machadevrepos/Vantare_Vantage_Suit/Docs/Files from Client/Second level Enclosure Design 03rd April 2026.pptx

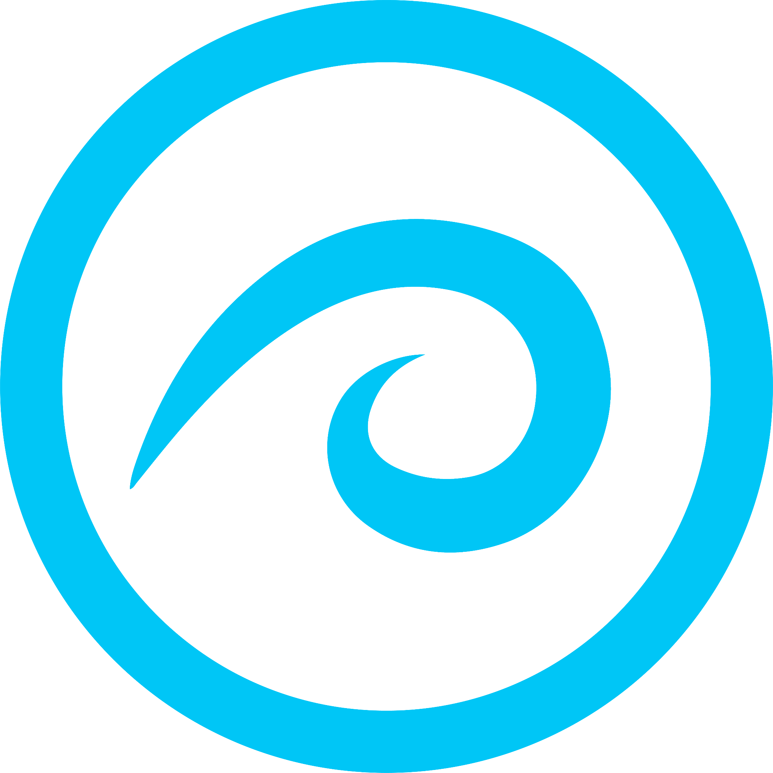
[picture p1: figure]

Exoskeleton
Master and Node Assembly Enclosure Design

Prototype Lab, Groundswell Startups

Date: 03-04-2026, Version: 1.1

## Slide 2

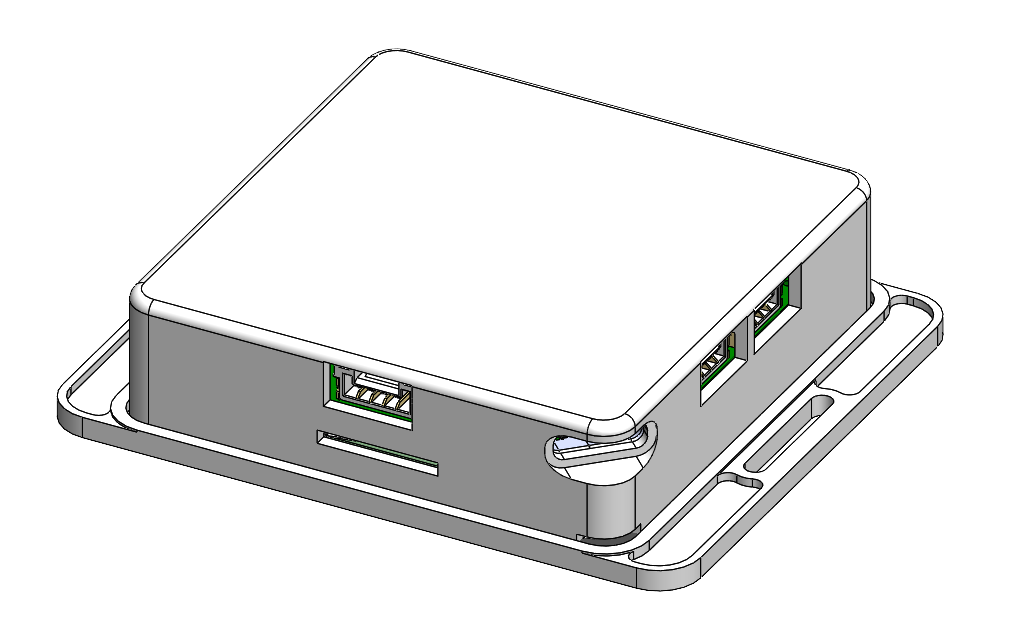
[picture p2: figure]

Master PCB Assembly with encloser

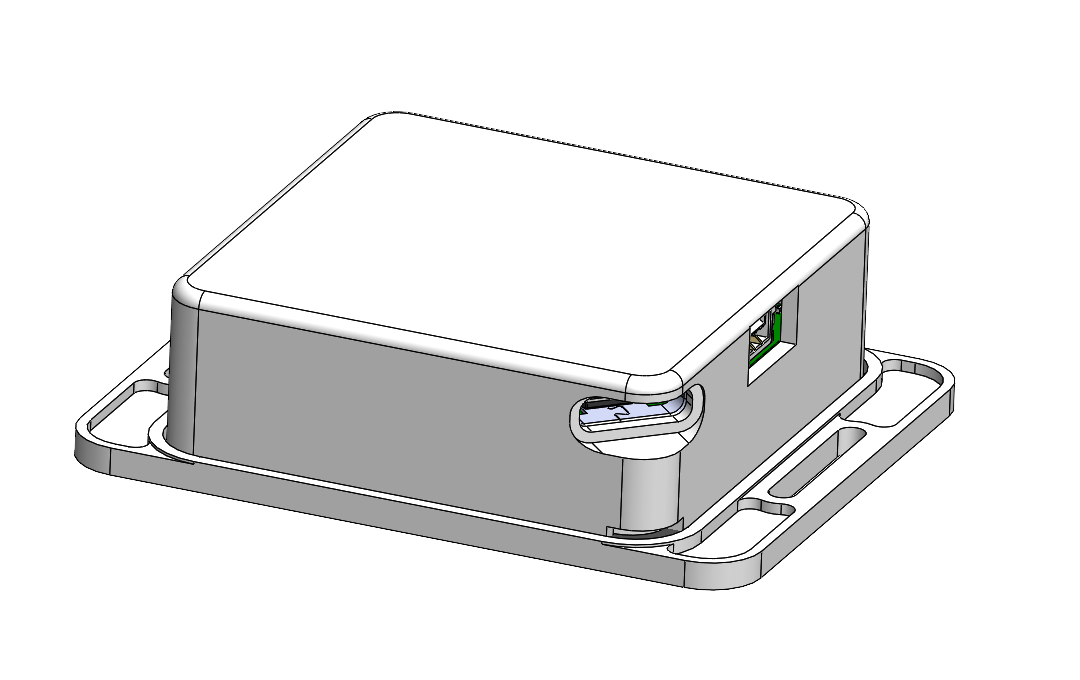
[picture p3: figure]

Node PCB Assembly with encloser

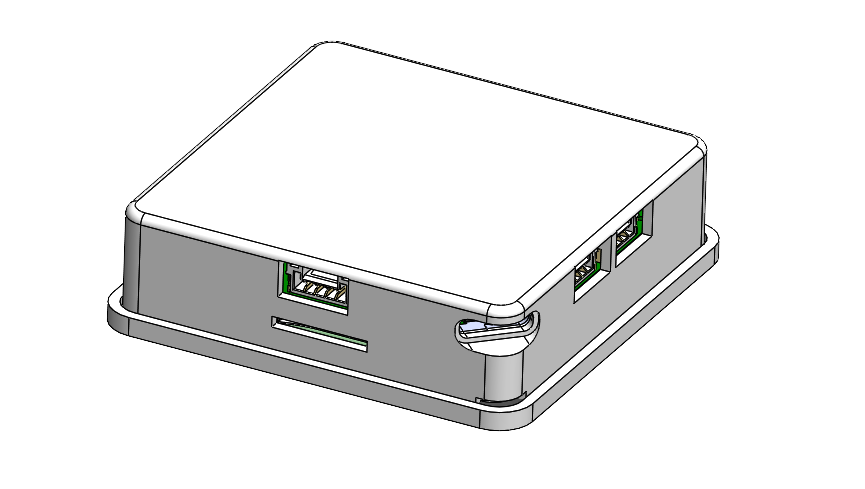
[picture p4: figure]
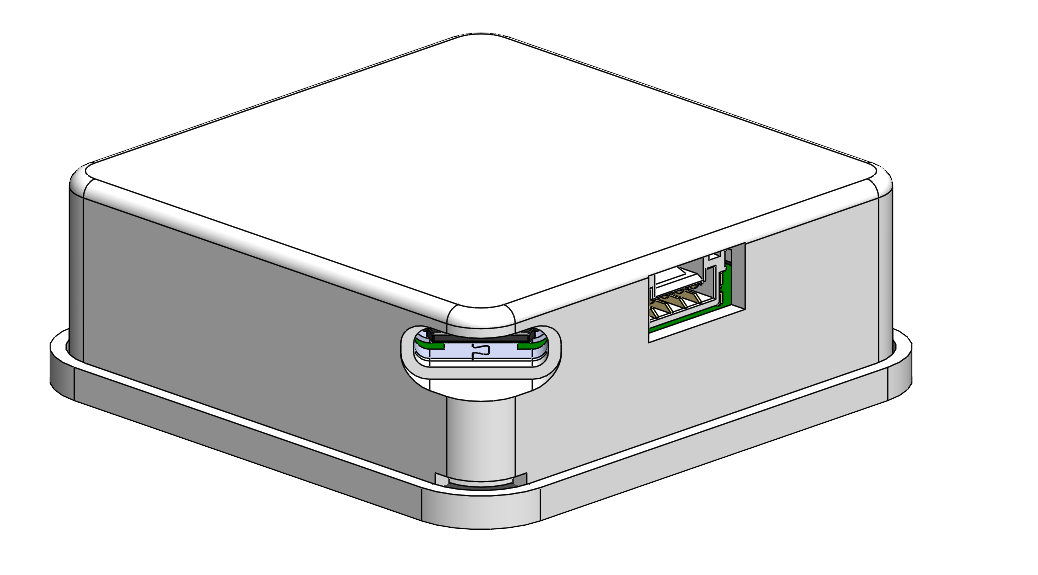
[picture p5: figure]

## Slide 3

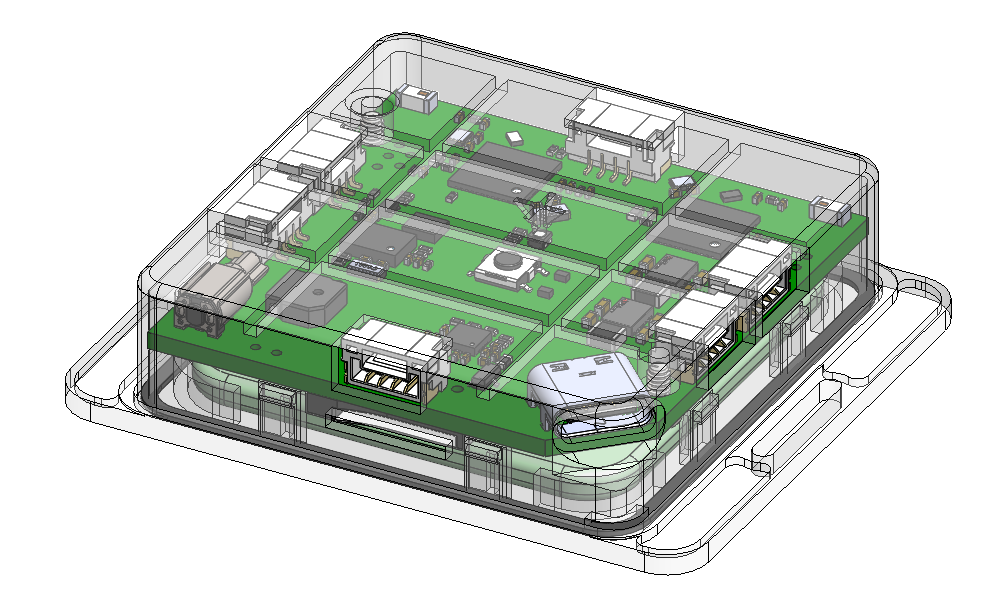
[picture p6: figure]
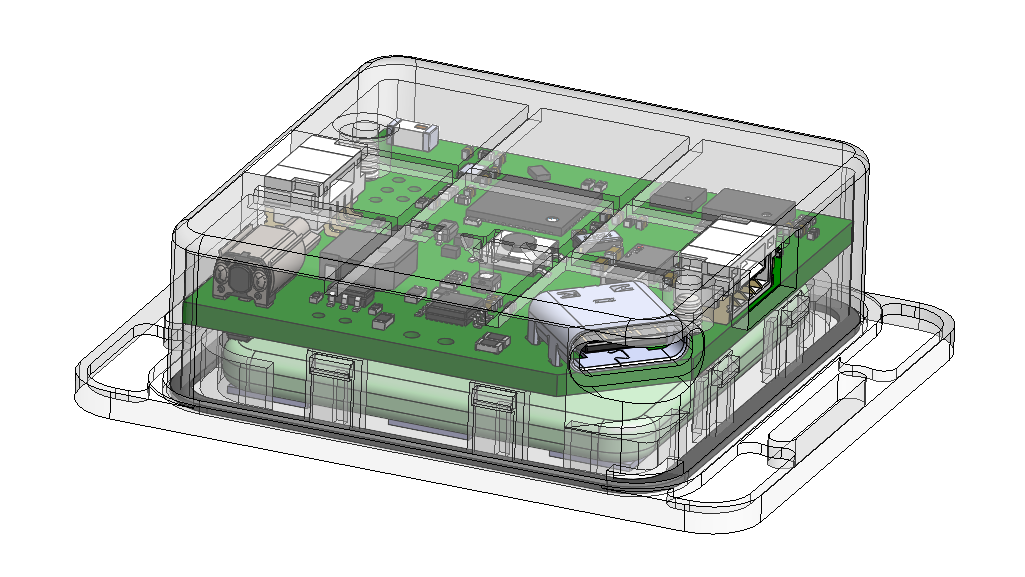
[picture p7: figure]

Node PCB Assembly with encloser

Master PCB Assembly with encloser

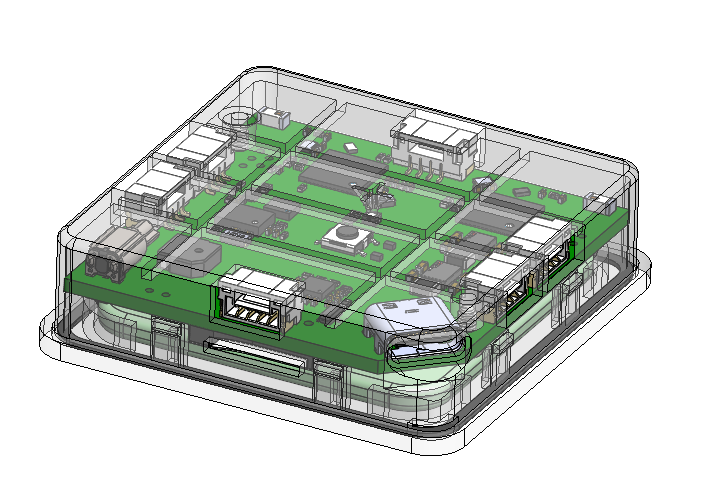
[picture p8: figure]
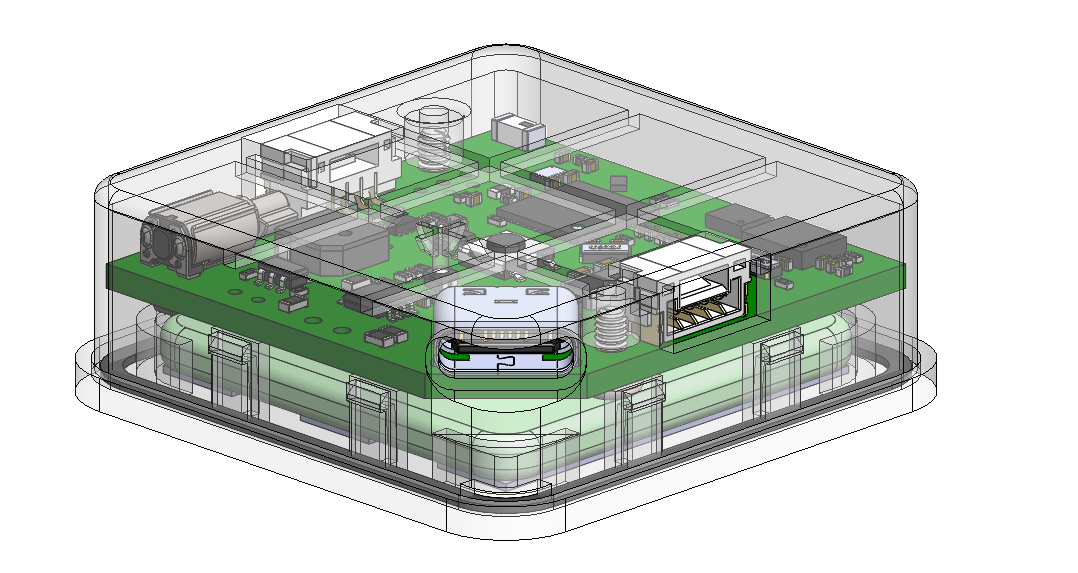
[picture p9: figure]

## Slide 4

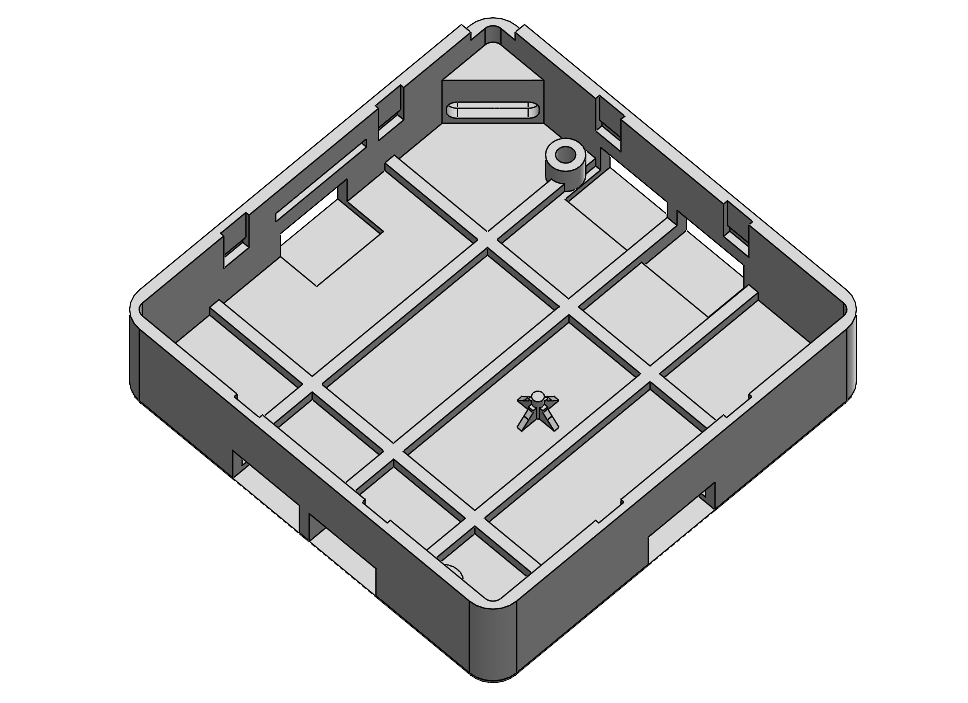
[picture p10: figure]
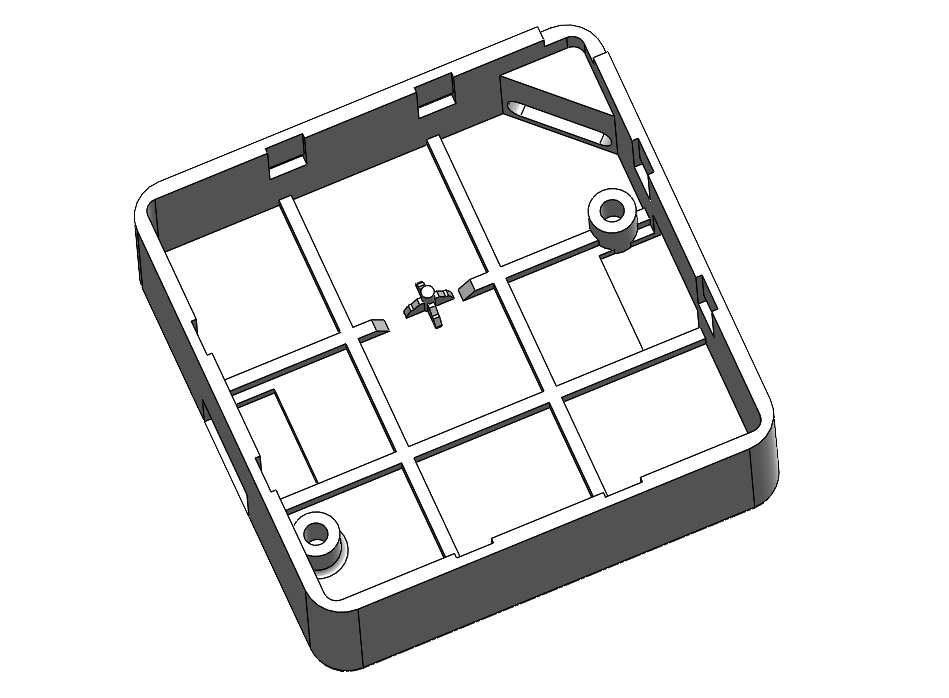
[picture p11: figure]

Node PCB Assembly Top Part

Master PCB Assembly Top Part

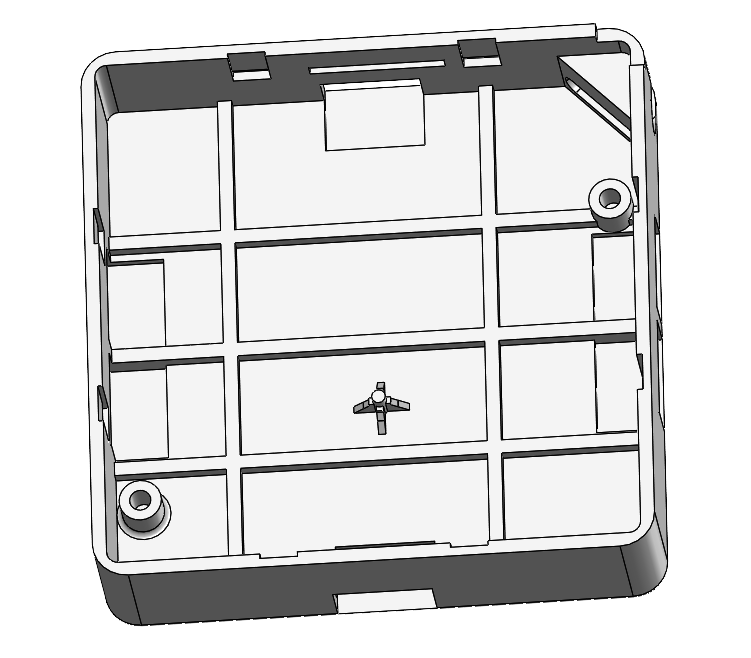
[picture p12: figure]

## Slide 5

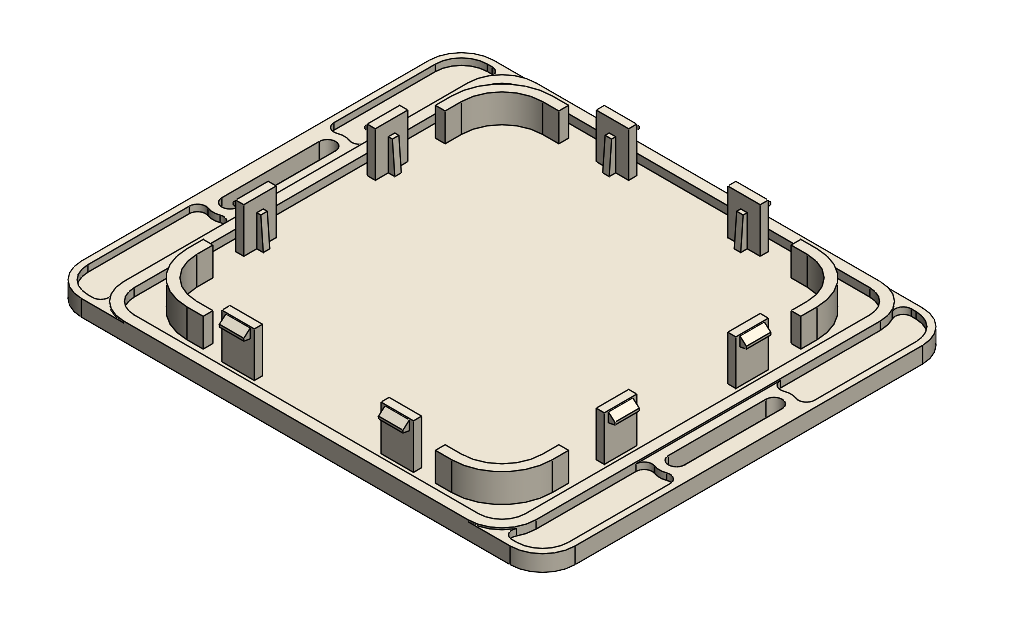
[picture p13: figure]

Node PCB Assembly Bottom Part

Master PCB Assembly Bottom Part

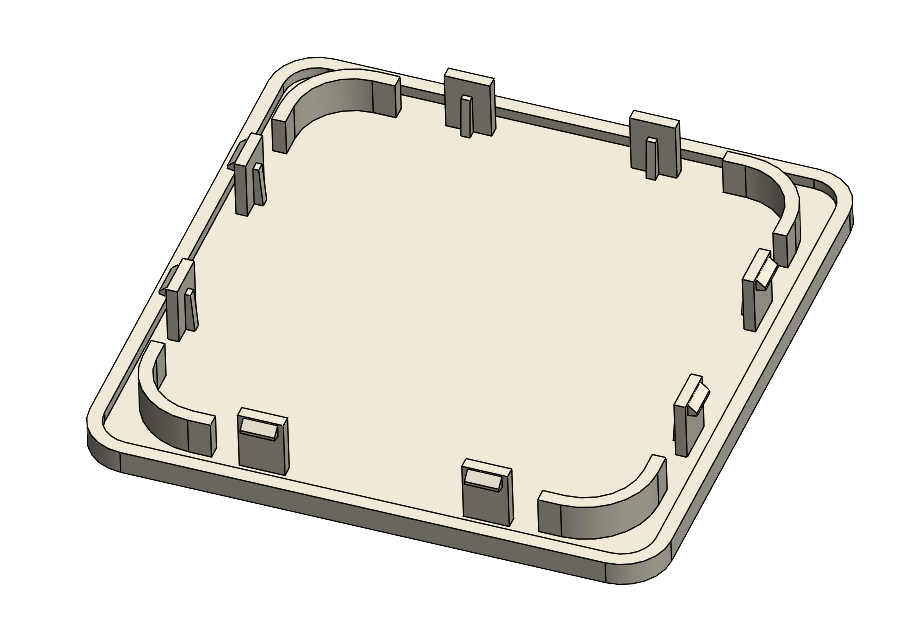
[picture p14: figure]

## Slide 6

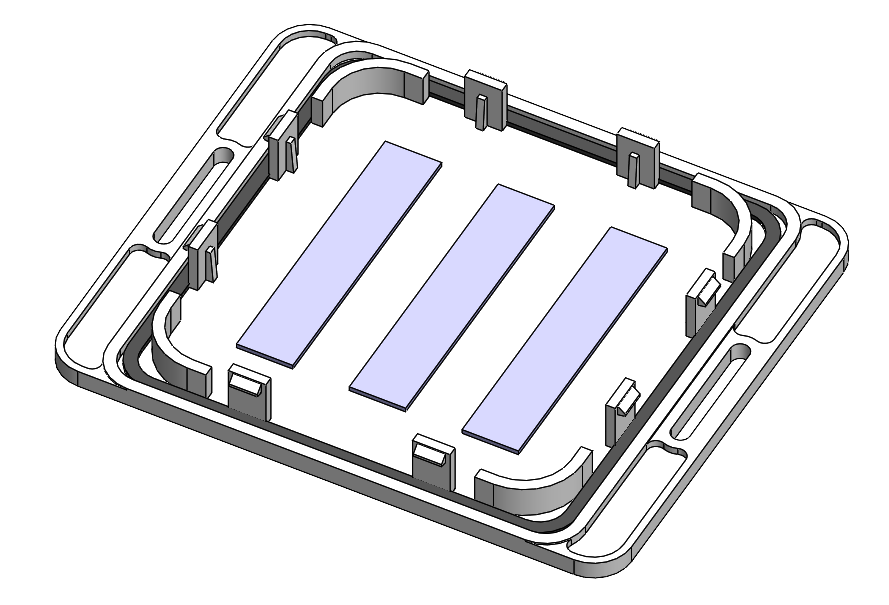
[picture p15: figure]
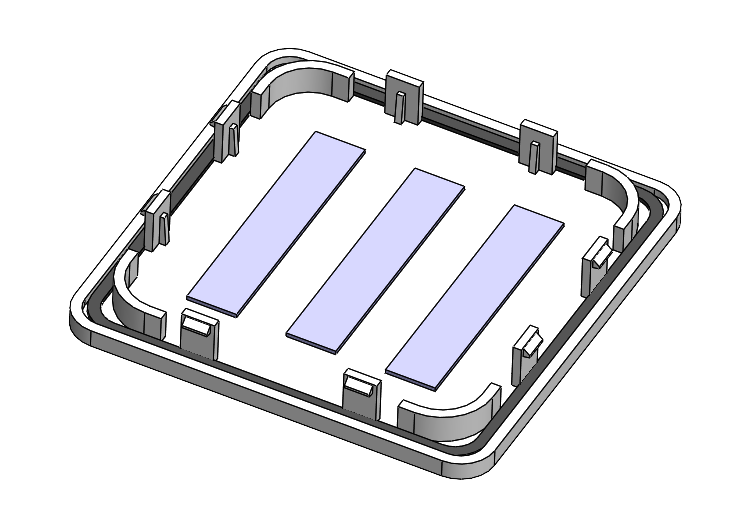
[picture p16: figure]

Master Bottom Part with DST for Battery

Node Bottom Part with DST for Battery

## Slide 7

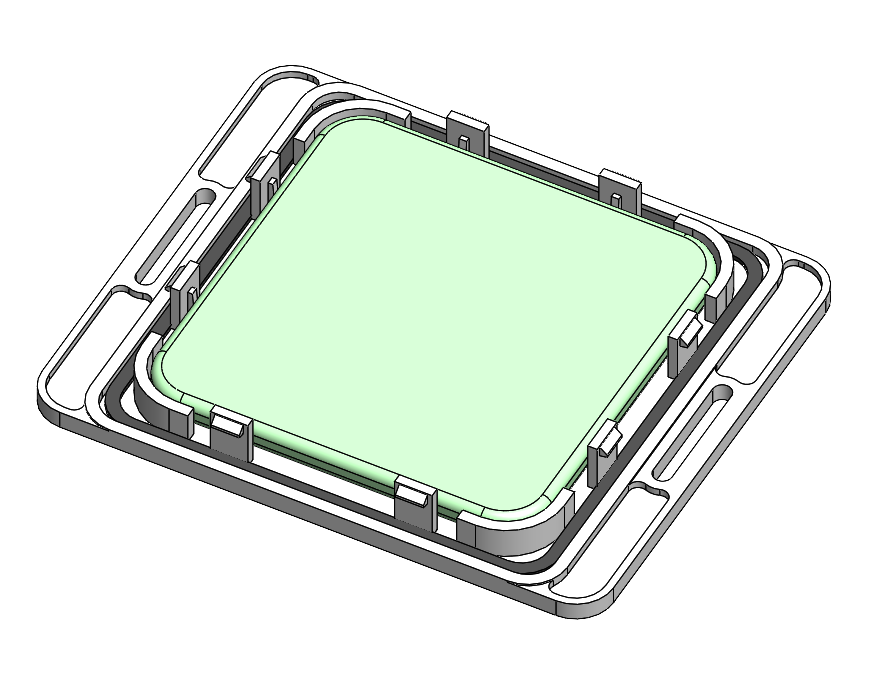
[picture p17: figure]

Master Bottom Part with DST & Battery placement

Node Bottom Part with DST & Battery placement

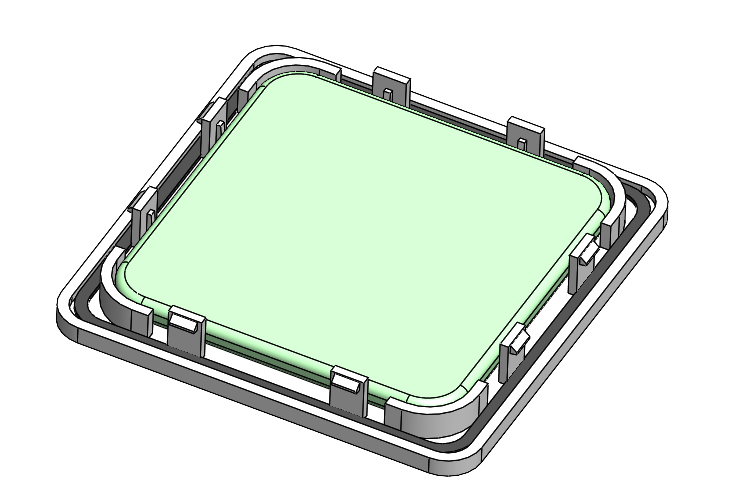
[picture p18: figure]

## Slide 8

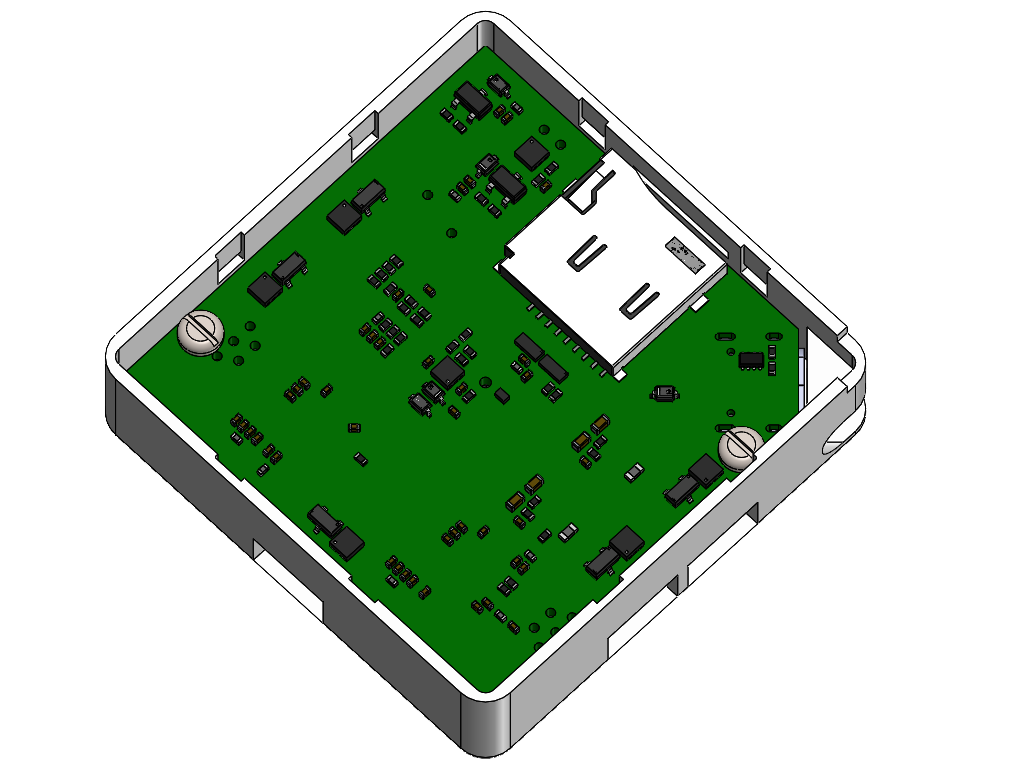
[picture p19: figure]

Master Top Part with PCB placement with self tapping screw

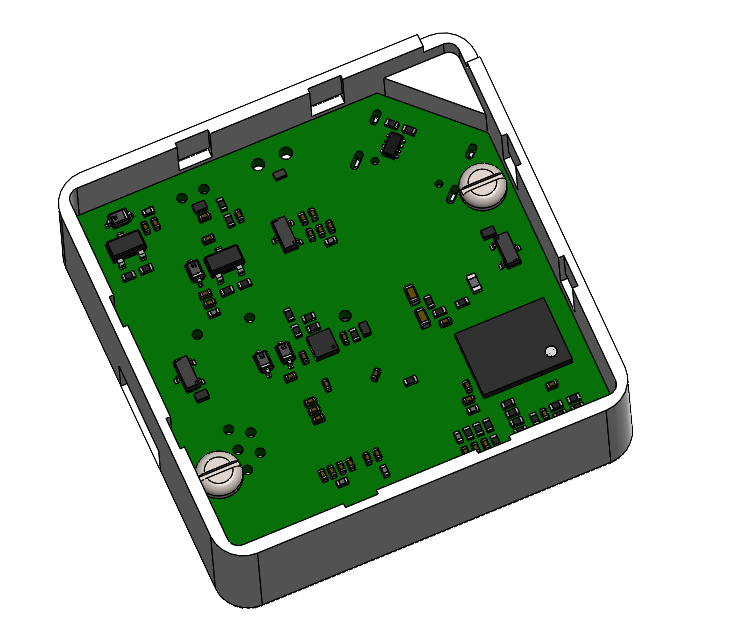
[picture p20: figure]

Node Top Part with PCB placement with self tapping screw

## Slide 9

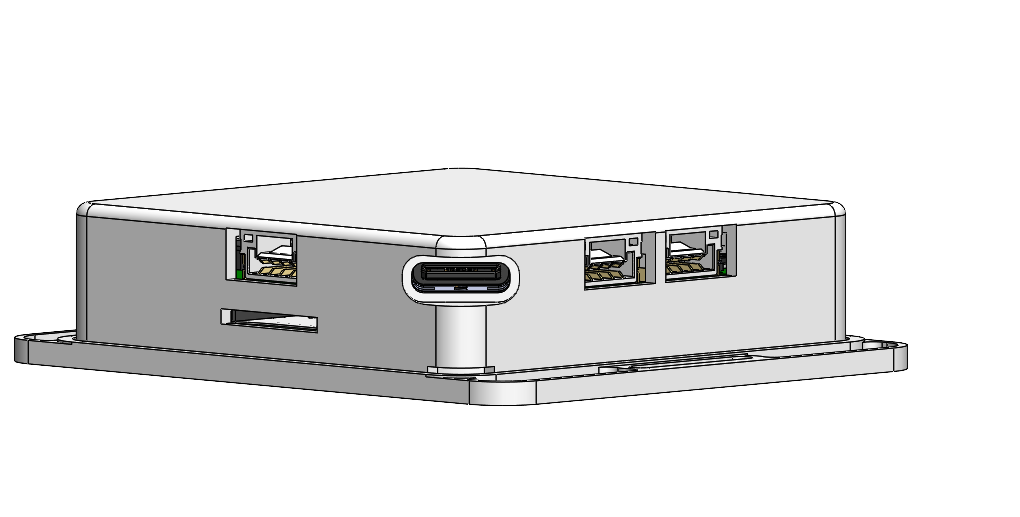
[picture p21: figure]
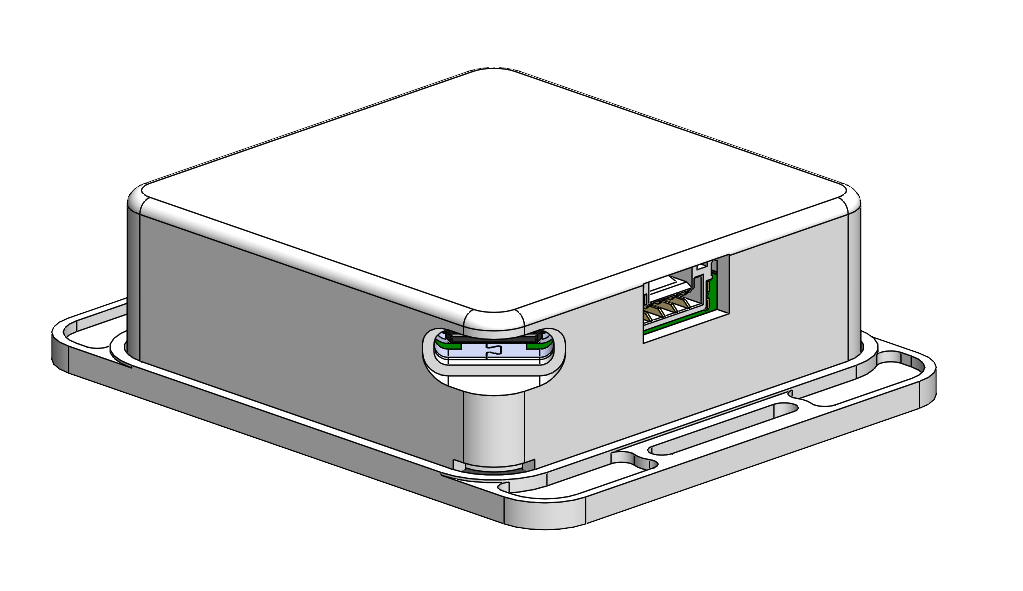
[picture p22: figure]

Master Top Part with cutout for USB-C

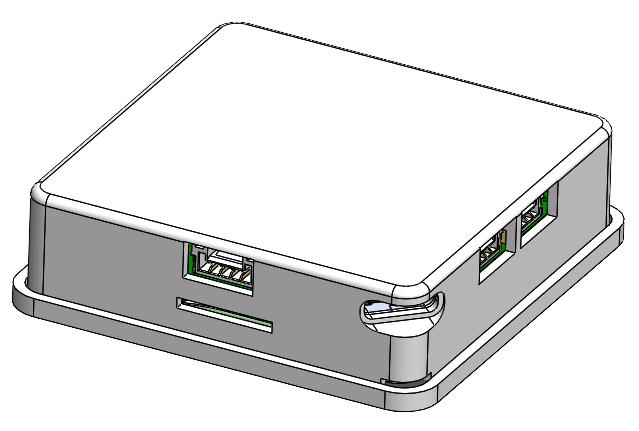
[picture p23: figure]

Node Top Part with cutout for USB-C

## Slide 10

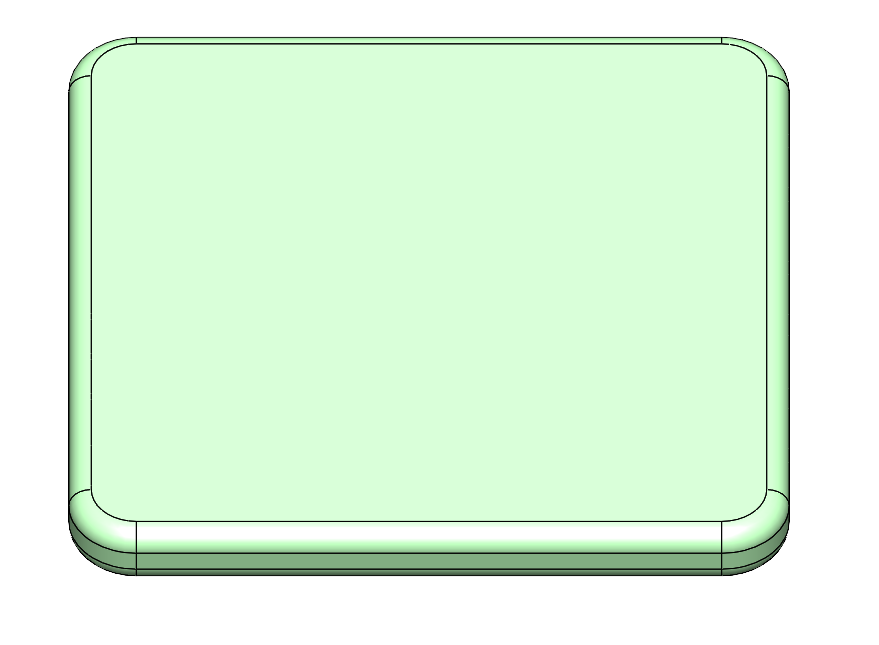
[picture p24: figure]

Length – 42mm
Width – 42mm
Thickness – 3mm

Length – 32mm
Width – 32mm
Thickness – 3mm

Node Assembly Battery Dimensions

Master Assembly Battery Dimensions

## Slide 11

Exoskeleton
Master and Node Assembly Enclosure Design

prototype@swellstartups.com

Thank you!
