machadevrepos/Vantare_Vantage_Suit/Docs/Vantare VantageSuit™️ Pitch Deck_PDF Version.pdf

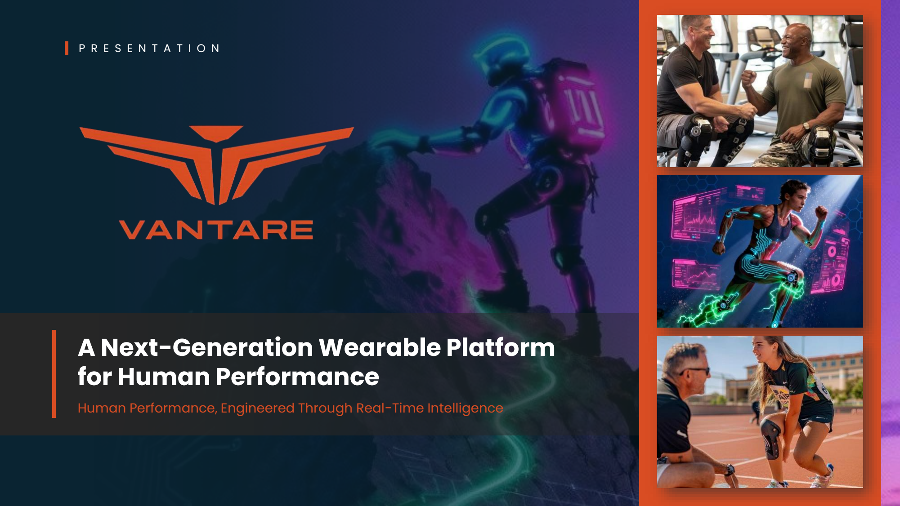
[picture p53: page 1]

1

# A Next-Generation Wearable Platform for Human Performance

Human Performance, Engineered Through Real-Time Intelligence

P R E S E N T A T I O N

## Vantare VantageSuit is a performance technology platform

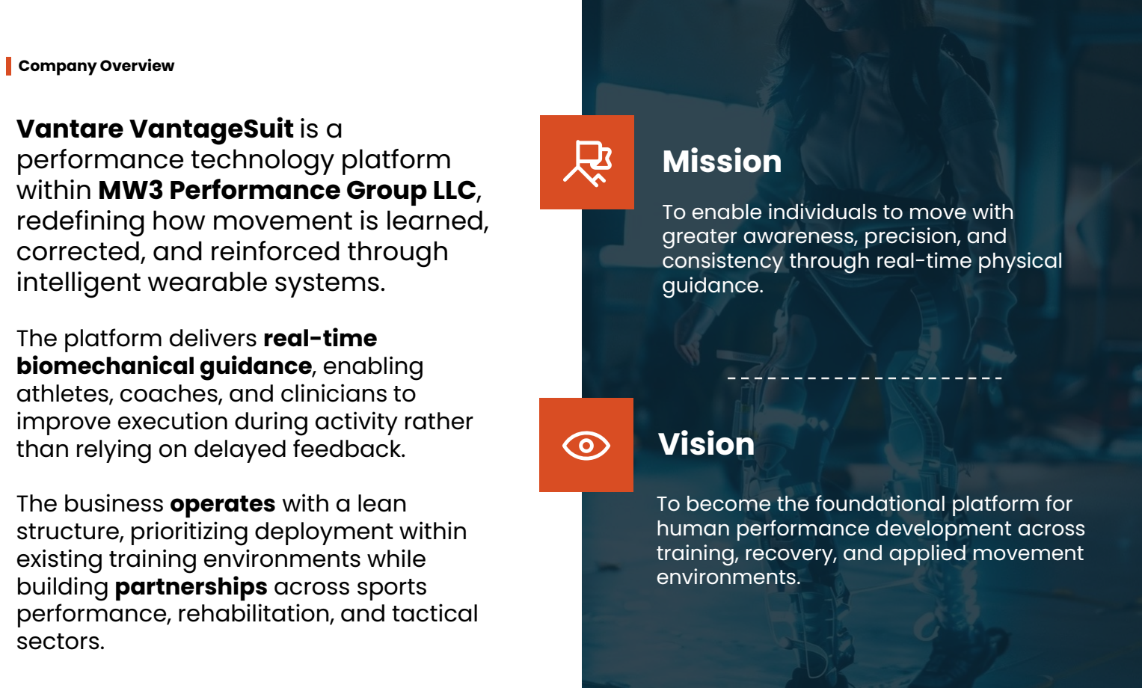
[picture p54: page 2]

2

Company Overview

within MW3 Performance Group LLC, redefining how movement is learned,

## corrected, and reinforced through

intelligent wearable systems.

## The platform delivers real-time biomechanical guidance, enabling athletes, coaches, and clinicians to improve execution during activity rather

than relying on delayed feedback.

## The business operates with a lean structure, prioritizing deployment within existing training environments while building partnerships across sports performance, rehabilitation, and tactical

sectors.

# Mission

## To enable individuals to move with greater awareness, precision, and consistency through real-time physical

guidance.

# Vision

## To become the foundational platform for human performance development across training, recovery, and applied movement

environments.

3

The Founder

# Powering Vantare’s Innovation

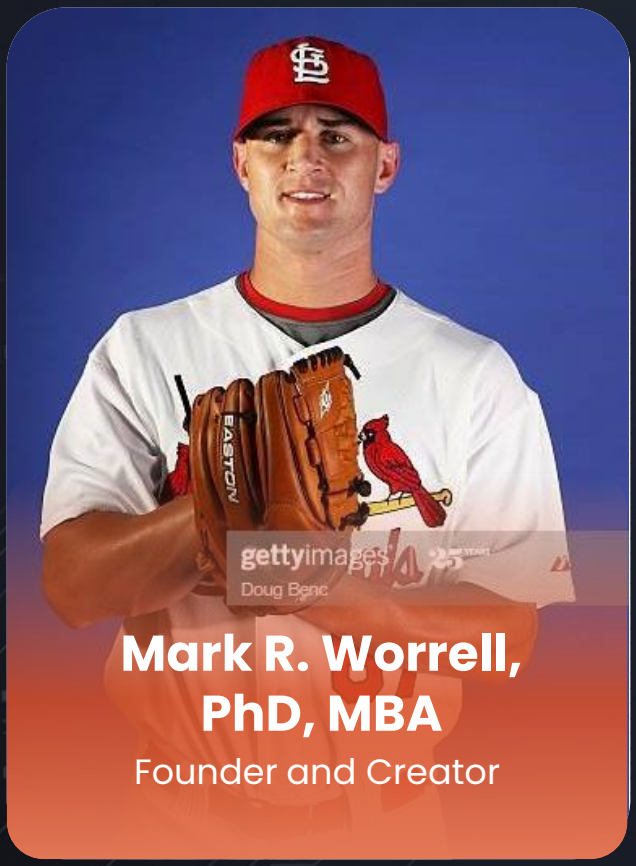
[picture p55: figure]
Mark R. Worrell, PhD, MBA Founder and Creator

### - Elite Athletic Background: Former Major League Baseball player with firsthand experience in high-performance environments

### - Academic Expertise: Advanced academic training in biomechanics, performance science, and human movement development

### - Problem Insight: Deep understanding of the gap between coaching instruction and physical execution

### - Innovation Leadership: Creator of a system that translates coaching intent into real-time physical guidance

- Industry Perspective: Experience across sports, training systems,

### and performance methodologies

### - Vision Alignment: Focused on building scalable solutions for improving movement across multiple sectors

# The Translation Gap: Coaching does not equal physical execution

There is currently no system that translates coaching instruction into real-time physical correction.

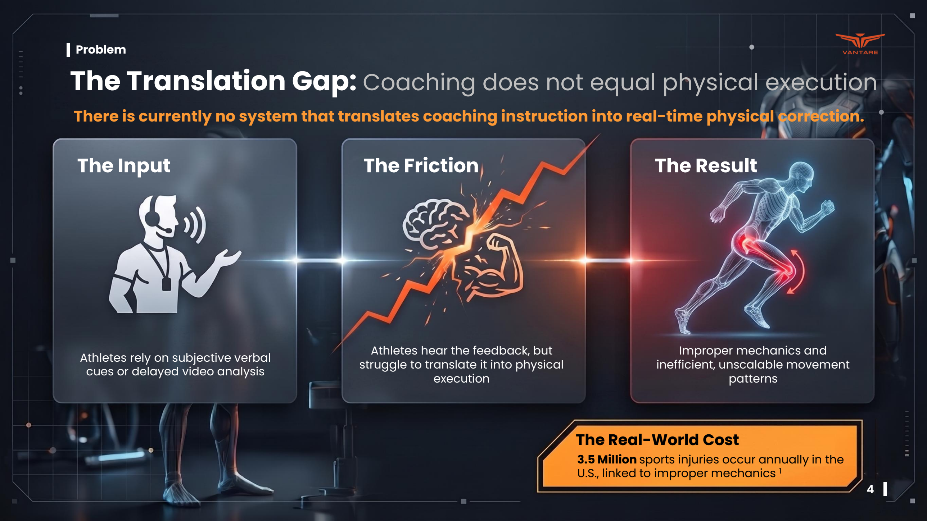
[picture p56: page 4]

4

Problem

## The Input

Athletes rely on subjective verbal cues or delayed video analysis

## The Friction

Athletes hear the feedback, but struggle to translate it into physical execution

## The Result

Improper mechanics and
inefficient, unscalable movement patterns

### 3.5 Million sports injuries occur annually in the

U.S., linked to improper mechanics ¹

## The Real-World Cost

# Introducing Vantare VantageSuit : Guided Physical Learning

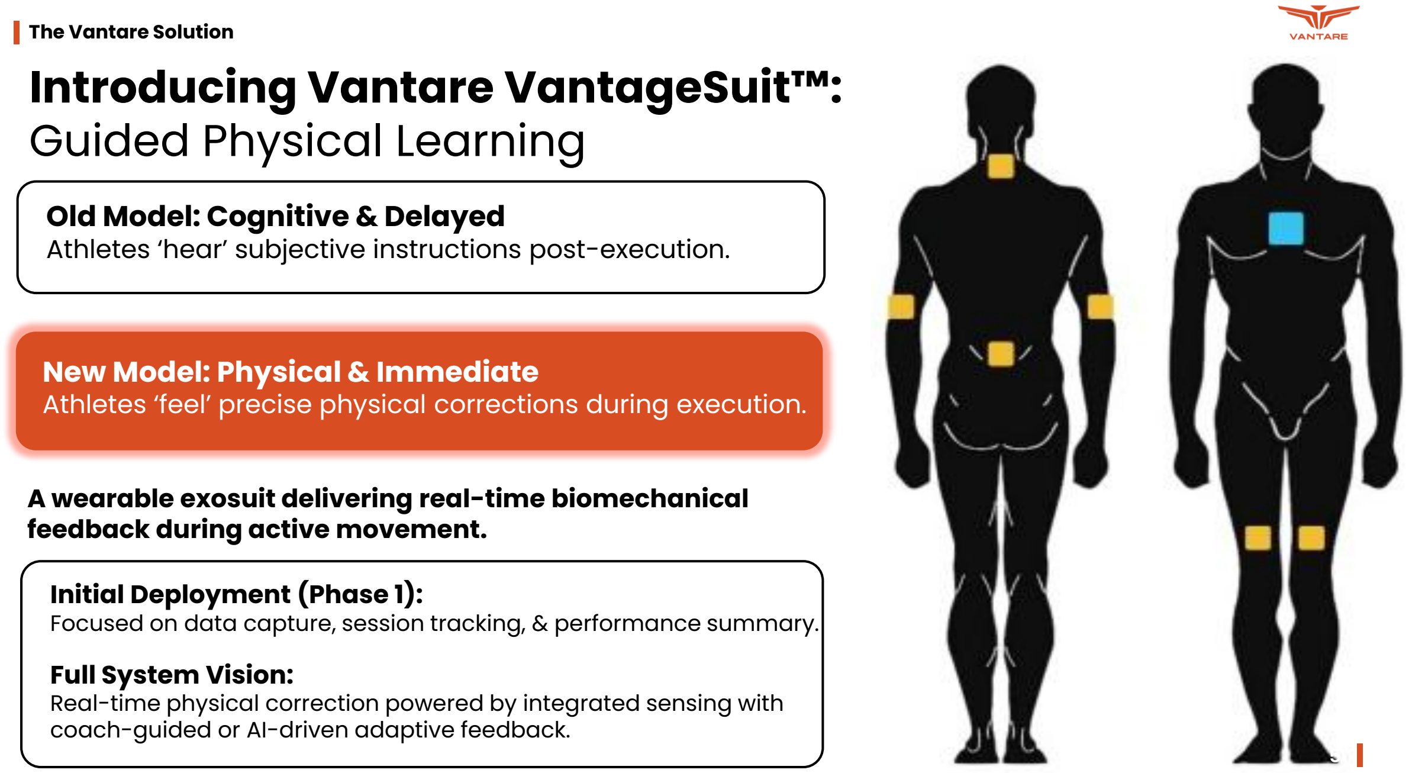
[picture p57: page 5]

5

The Vantare Solution

## Old Model: Cognitive & Delayed

Athletes ‘hear’ subjective instructions post-execution.

## New Model: Physical & Immediate

Athletes ‘feel’ precise physical corrections during execution.

## A wearable exosuit delivering real-time biomechanical

feedback during active movement.

5

## Initial Deployment (Phase 1):

Focused on data capture, session tracking, & performance summary.

## Full System Vision:

Real-time physical correction powered by integrated sensing with coach-guided or AI-driven adaptive feedback.

# A Comprehensive Human Performance System

## An integrated system combining wearable hardware, software platforms, and

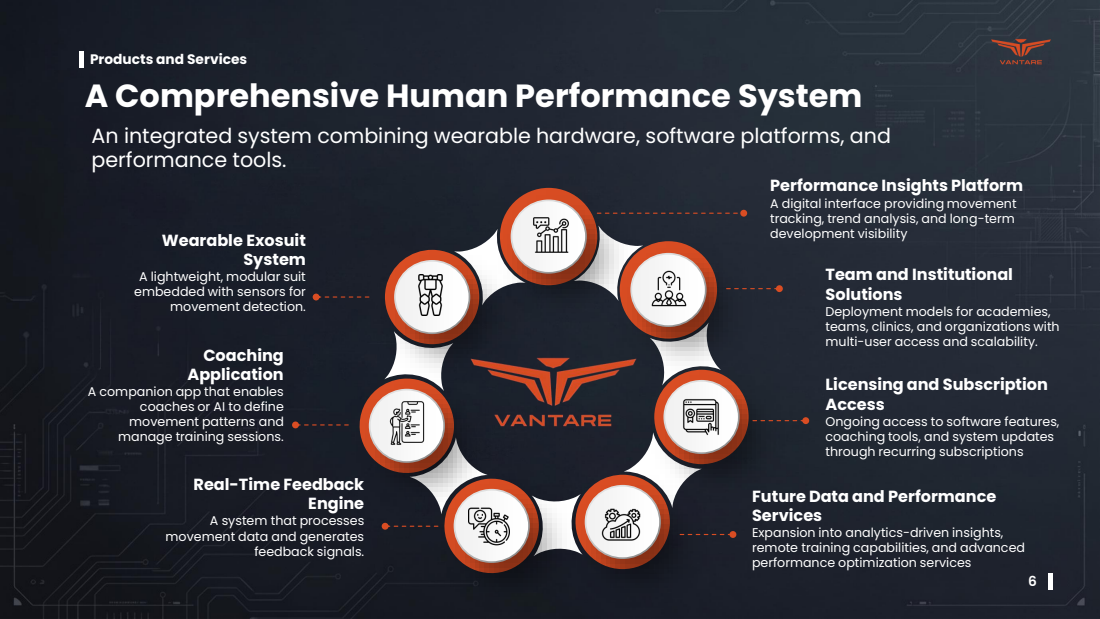
[picture p58: page 6]
performance tools.; Coaching Application; Wearable Exosuit System; Engine; feedback signals.

Products and Services

Performance Insights Platform
A digital interface providing movement
tracking, trend analysis, and long-term
development visibility
Team and Institutional
Solutions
Deployment models for academies,
teams, clinics, and organizations with
multi-user access and scalability.
Licensing and Subscription
Access
Ongoing access to software features,
coaching tools, and system updates
through recurring subscriptions

A lightweight, modular suit
embedded with sensors for
movement detection.

A companion app that enables
coaches or AI to define
movement patterns and
manage training sessions.

Real-Time Feedback

Future Data and Performance
Services
Expansion into analytics-driven insights,
remote training capabilities, and advanced
performance optimization services

A system that processes
movement data and generates

Our Technology

# Real-Time Biomechanical Intelligence System

## - Integrated Motion System: Multi-point sensors capture movement and positional changes continuously

## - Adaptive Guidance Engine: Processes motion data and generates response signals

## - Modular Exosuit Architecture: Flexible design adapts across body types and training contexts

## - Dynamic Response Framework: Adjusts system response based on movement patterns and activity conditions

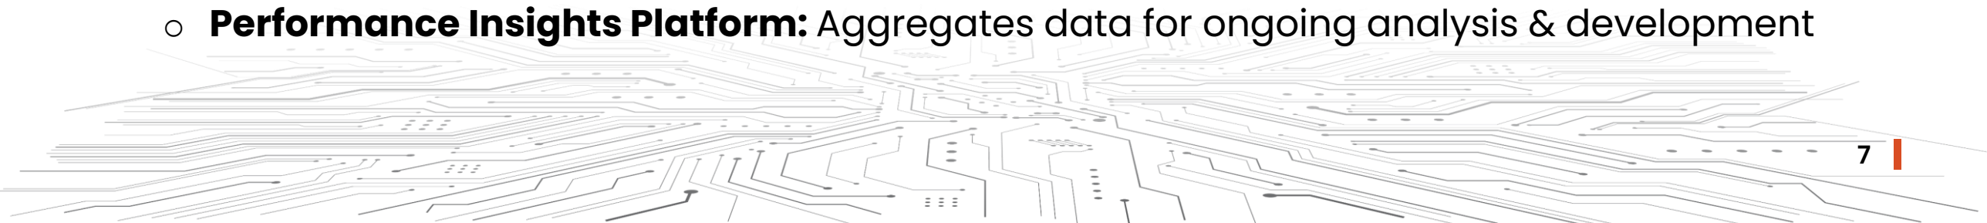
[picture p59: figure]

## - Performance Insights Platform: Aggregates data for ongoing analysis & development

## The Vantare VantageSuit platform is powered by a layered architecture

combining sensing, processing, and adaptive feedback systems.

# Intelligent and Continuous Movement Feedback

The system delivers a seamless process that connects sensing, processing, and response into a

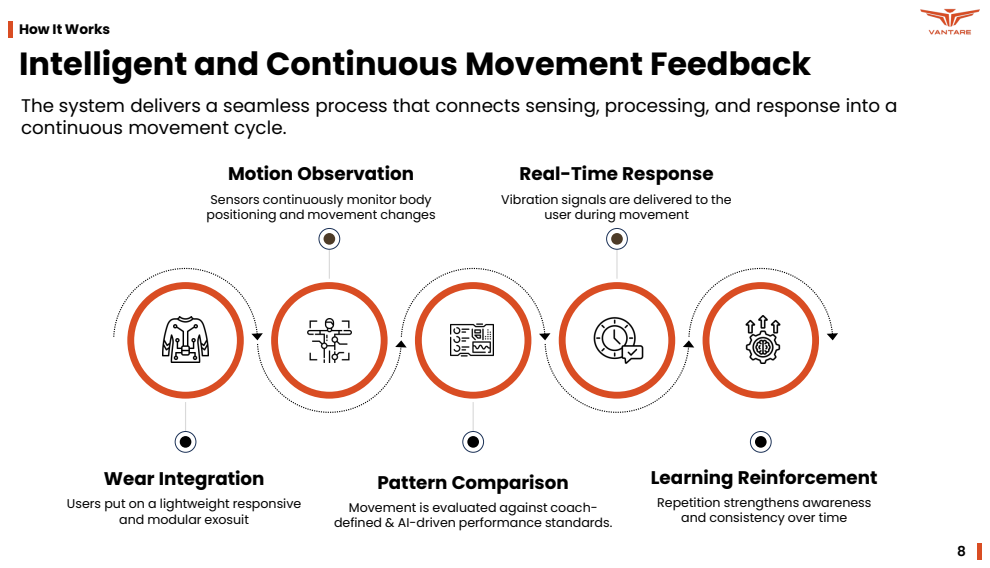
[picture p60: page 8]

How It Works

continuous movement cycle.

Motion Observation
Sensors continuously monitor body
positioning and movement changes

Real-Time Response
Vibration signals are delivered to the
user during movement

Wear Integration
Users put on a lightweight responsive
and modular exosuit

Pattern Comparison
Movement is evaluated against coach-
defined & AI-driven performance standards.

Learning Reinforcement
Repetition strengthens awareness
and consistency over time

9

Market Opportunity in Performance Training Technology

# Unlocking Underserved Training Demand

Organizations spend heavily on training, analytics, and wearables, but the lack of real-time movement feedback creates a clear gap in performance technology.

29.2%

U.S. share of the global smart sports wearables market, reflecting strong U.S. adoption of sports wearable technology.¹

16.7M

Baseball participants in the U.S. (2023),² with high school sports participation reaching 8.06M athletes.³

$4B

$4B in annual NCAA athletic scholarships supporting 500,000+ student-athletes across 1,000+ programs.⁴
36%–44%

U.S. adults using wearable technology, with wearables ranked the #1 fitness trend in 2024.⁵

4.4M

Sports and recreational injury-related emergency visits annually in the U.S.,⁶ with ~3.5M total sports injuries per year⁷

11%

Projected growth in physical therapist employment (2024–2034), indicating expanding rehabilitation demand.⁸

The U.S. sports and performance training landscape is entering a phase of strong adoption of wearable & data-driven tools, yet current solutions remain fragmented and do not address real-time movement correction during training.

10

## The business operates in the U.S. sports technology and wearable performance market, offering a system that improves movement, training consistency, and real-time coaching for athletes and training

organizations.

# Sports Technology & Wearable Performance Market

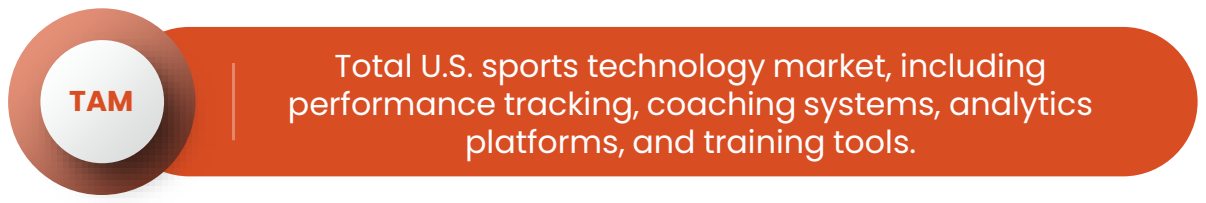
[picture p61: figure]
performance tracking, coaching systems, analytics platforms, and training tools.; TAM

Total U.S. sports technology market, including

U.S. smart sports wearables market, representing wearable-based performance systems used in training,

Initial market share from early adoption across training facilities and sports programs, estimated at $6.9 Million

Addressable Market Size

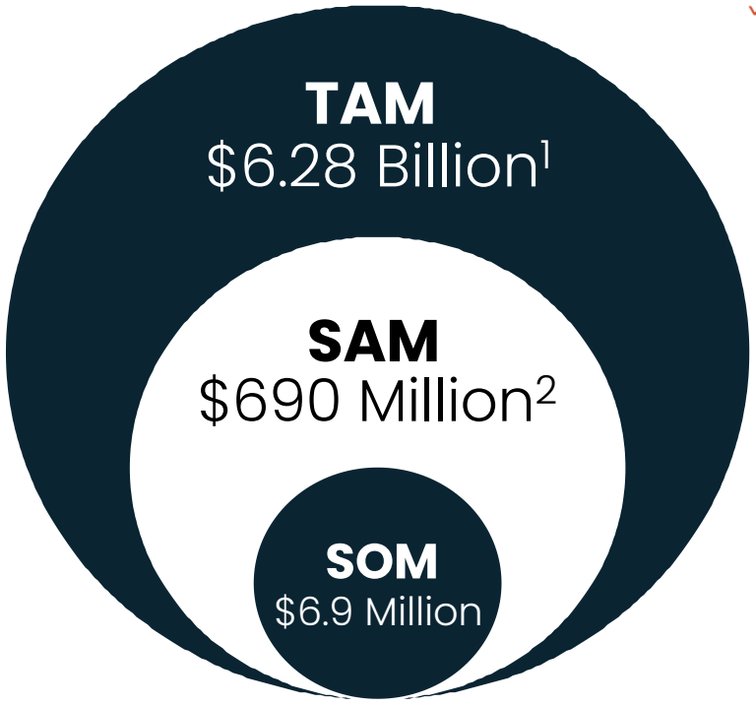
[picture p62: figure]
TAM $6.28 Billion¹; SAM $690 Million²; SOM $6.9 Million

Market Sizing Approach:

Estimates are based on U.S. sports technology market data, wearable adoption trends, and industry benchmarks.
TAM reflects the total sports technology ecosystem, SAM narrows to wearable-based performance systems, and SOM assumes initial penetration of approximately 1% of SAM through early adoption across training organizations.

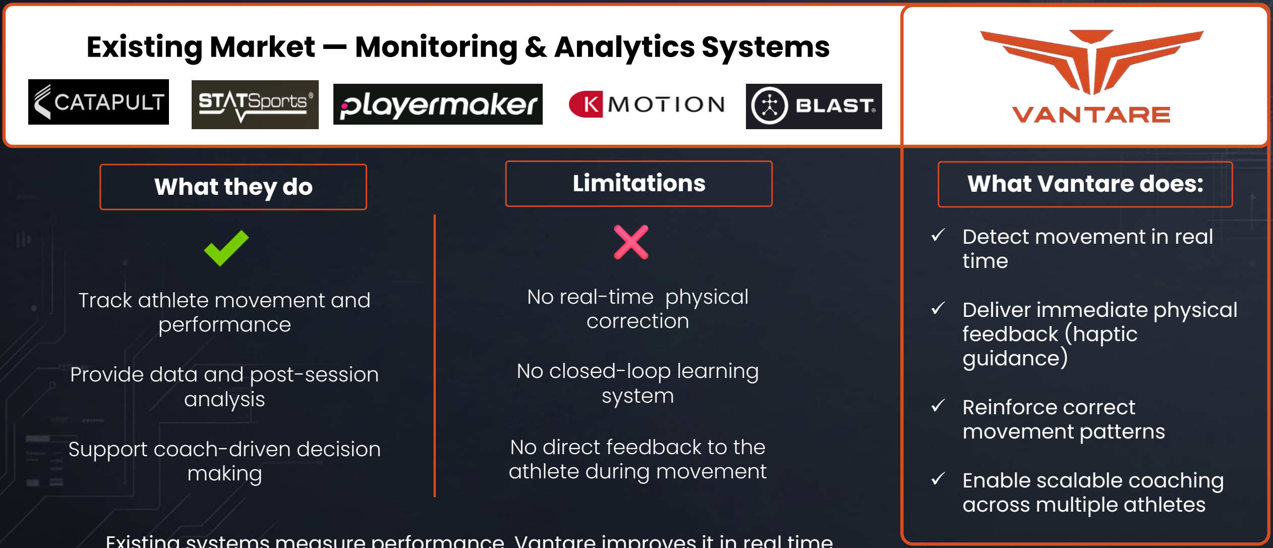
[picture p63: figure]
What they do; Track athlete movement and performance; Provide data and post-session analysis; Support coach-driven decision making; Limitations; No real-time physical correction; No closed-loop learning system; No direct feedback to the athlete during movement; Detect movement in real; time; Deliver immediate physical; feedback (haptic guidance); Reinforce correct; movement patterns; Enable scalable coaching; across multiple athletes; What Vantare does:

11

The Competition

# From Monitoring to Real-Time Performance Correction

## Existing Market — Monitoring & Analytics Systems

Existing systems measure performance. Vantare improves it in real time.

# What Exists vs What’s Missing

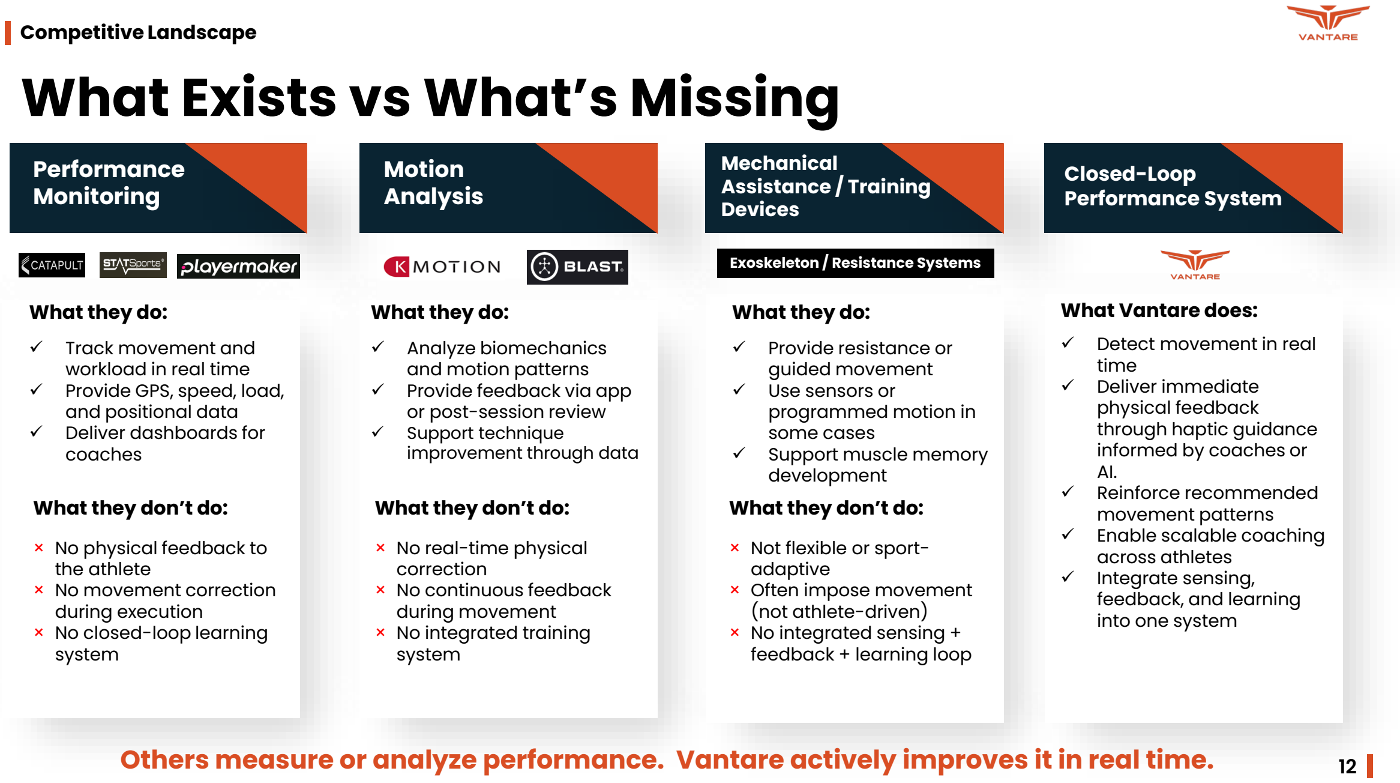
[picture p64: page 12]

12

Competitive Landscape

Performance
Monitoring

Motion
Analysis

Mechanical
Assistance / Training
Devices

Closed-Loop
Performance System

What Vantare does:
✓ | Detect movement in real
| time
✓ | Deliver immediate
| physical feedback
| through haptic guidance
| informed by coaches or
| AI.
✓ | Reinforce recommended
| movement patterns
✓ | Enable scalable coaching
| across athletes
✓ | Integrate sensing,
| feedback, and learning
| into one system

What they do:
✓ | Track movement and
| workload in real time
✓ | Provide GPS, speed, load,
| and positional data
✓ | Deliver dashboards for
| coaches

What they don’t do:
× No physical feedback to
| the athlete
× No movement correction
| during execution
× No closed-loop learning
| system

What they do:
✓ | Analyze biomechanics
| and motion patterns
✓ | Provide feedback via app
| or post-session review
✓ | Support technique improvement through data

What they don’t do:
× No real-time physical
| correction
× No continuous feedback
| during movement
× No integrated training
| system

What they do:
✓ | Provide resistance or
| guided movement
✓ | Use sensors or
| programmed motion in
| some cases
✓ | Support muscle memory
| development
What they don’t do:
× Not flexible or sport-
| adaptive
× Often impose movement
| (not athlete-driven)
× No integrated sensing +
| feedback + learning loop

Exoskeleton / Resistance Systems

Others measure or analyze performance. Vantare actively improves it in real time.

13

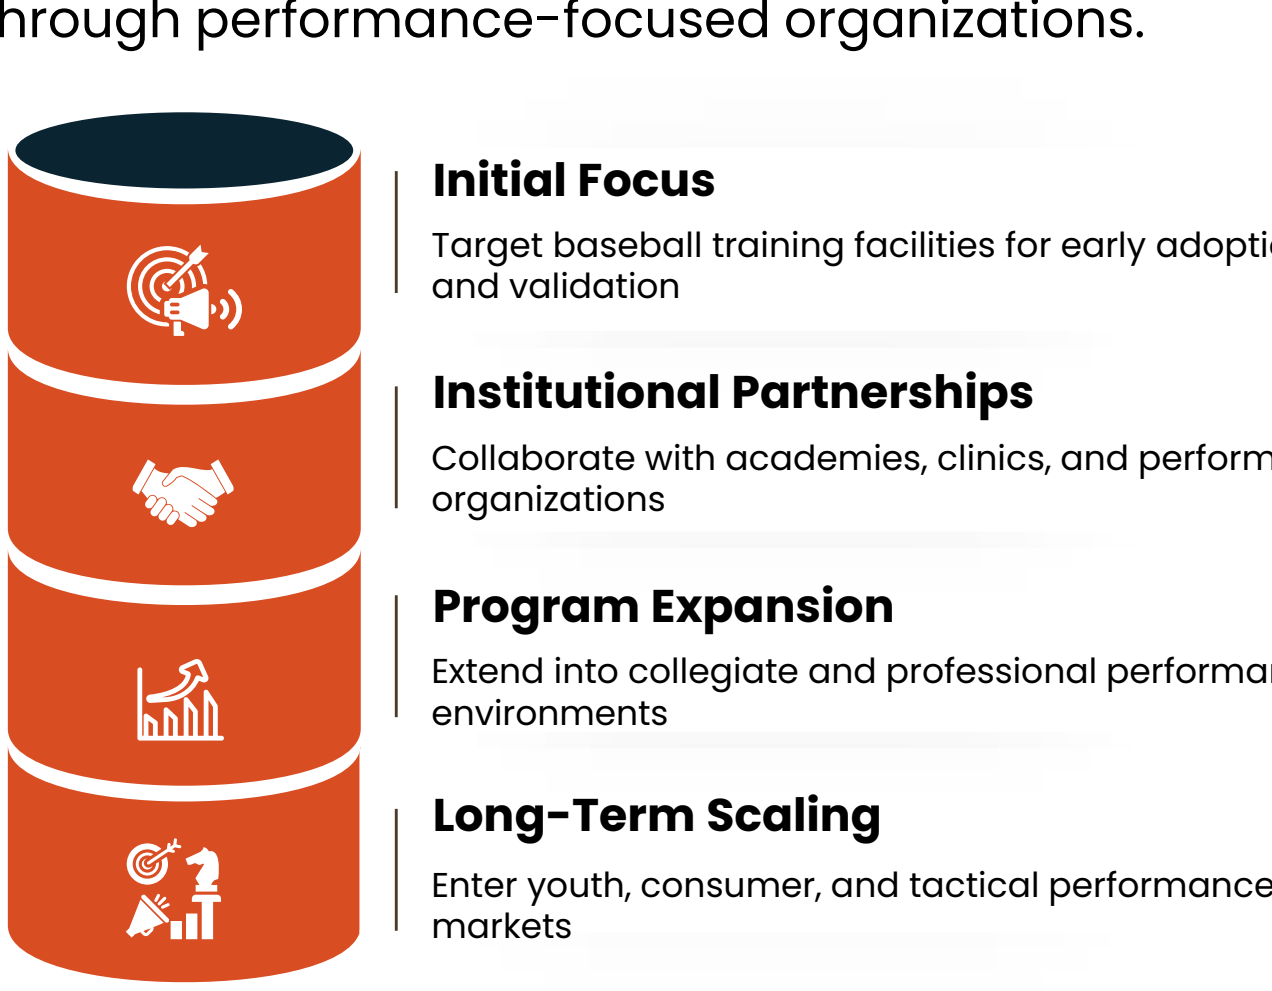
[picture p65: figure]
Initial Focus; and validation; Institutional Partnerships; organizations; Program Expansion; environments Long-Term Scaling; markets

Target baseball training facilities for early adoption

Collaborate with academies, clinics, and performance

Extend into collegiate and professional performance

Enter youth, consumer, and tactical performance

Market Strategy & Expansion Vision

## Our go-to-market strategy prioritizes controlled deployment, validation, and expansion

through performance-focused organizations.

# Strategic Entry and Expansion Approach

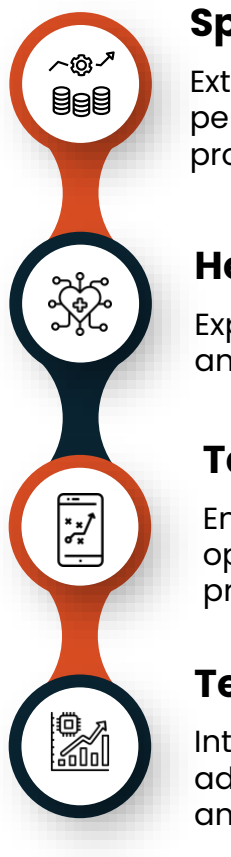
[picture p66: figure]

Sports Expansion
Extend beyond baseball into broader athletic performance environments and training programs

Healthcare Integration
Expand into rehabilitation, physical therapy, and movement recovery applications
Tactical Applications
Enter military and high-performance operational training environments requiring precision and discipline
Technology and Data Evolution
Integrate with immersive systems while advancing data-driven performance insights and analytics

# Early Progress and Market Alignment

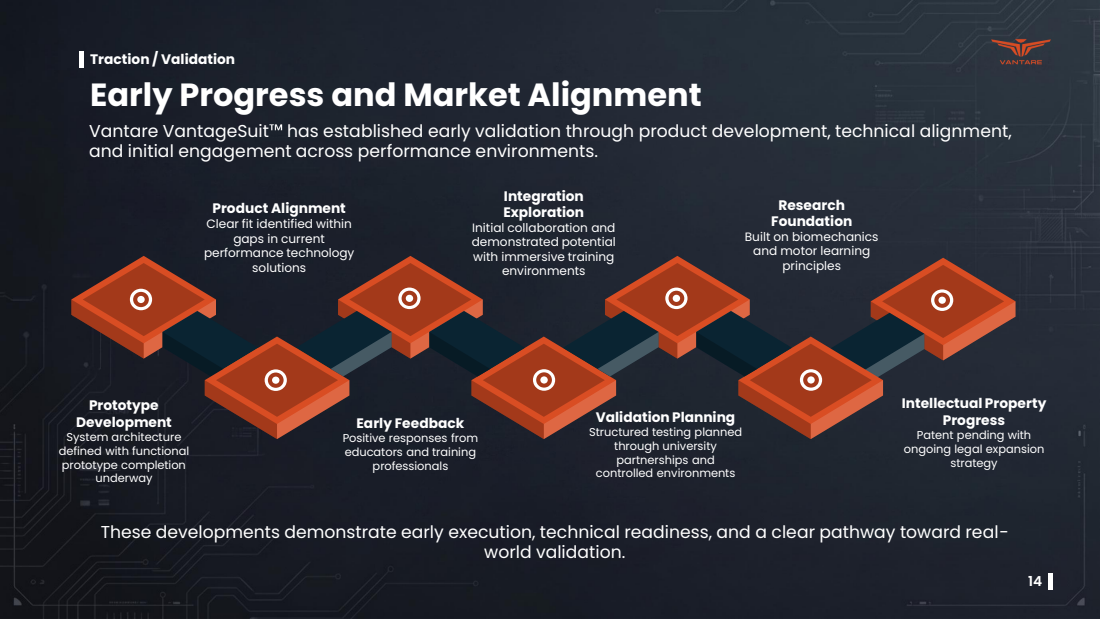
[picture p67: page 14]
world validation.; Traction / Validation

Vantare VantageSuit has established early validation through product development, technical alignment,
and initial engagement across performance environments.

Integration
Exploration
Initial collaboration and
demonstrated potential
with immersive training
environments

Research
Foundation
Built on biomechanics
and motor learning
principles

Product Alignment
Clear fit identified within
gaps in current
performance technology
solutions

Prototype
Development
System architecture
defined with functional
prototype completion
underway

Intellectual Property
Progress
Patent pending with
ongoing legal expansion
strategy

Validation Planning
Structured testing planned
through university
partnerships and
controlled environments

Early Feedback
Positive responses from
educators and training
professionals

These developments demonstrate early execution, technical readiness, and a clear pathway toward real-

15

Pilot Plan

# Structured Deployment for Real-World Validation

## The pilot plan is designed to validate system effectiveness, usability, and adoption

within real training environments through structured deployment.

## Pilot Targets: Engagement with 3–5 organizations, each including 20-30 participating athletes

## Deployment Structure: 60-day implementation period with 15–20 VantageSuit units distributed across sites

## Training Integration: Systems embedded within existing performance routines to ensure realistic testing conditions

## Success Metrics: Measurement of movement consistency improvement, coach adoption, and athlete usability satisfaction

## Conversion Objective: Target conversion of 50–70% of pilot participants into paying customers

16

## Hardware Sales

VantageSuit units sold to
individuals, teams, and
organizations as the
primary entry point

## Software Subscriptions

Monthly access to
coaching tools, real-time
feedback, and
performance insights

## Institutional Contracts

Agreements with
organizations deploying
the system across
structured environments

## Data & Analytics Expansion

Expansion into performance insights and advanced data services

## Team Licensing

Multi-user access
models designed for
academies, training
facilities, and institutions

Revenue Model

# Hybrid and Recurring Revenue Structure

Vantare VantageSuit
operates a hybrid
monetization structure that combines hardware
distribution with recurring digital access, enabling
consistent engagement &
long-term value generation across performance
environments.

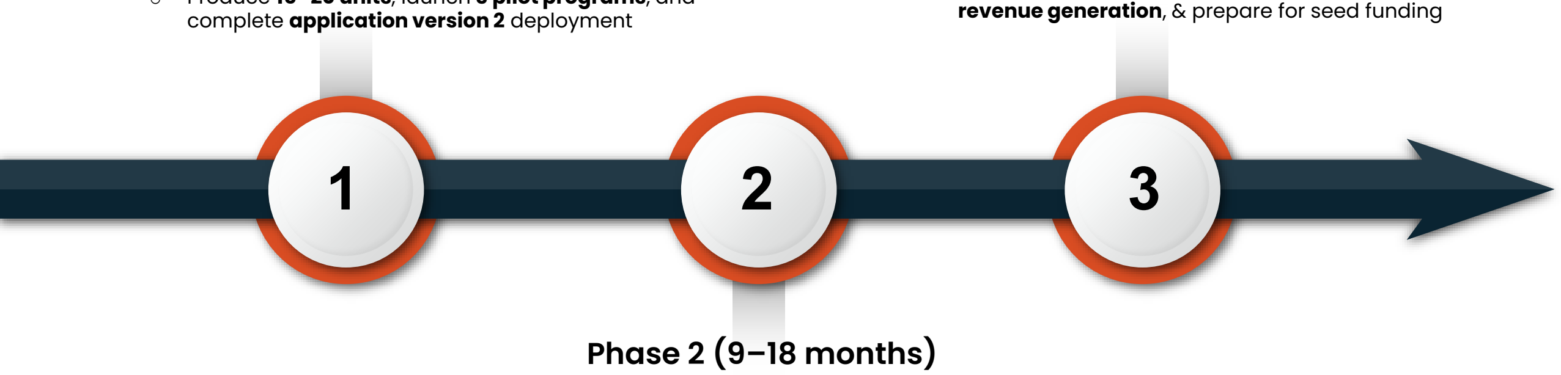
[picture p68: figure]
Phase 2 (9–18 months); complete application version 2 deployment

17

- Expand to 5–10 organizations, collect 150+ athlete sessions, and refine product and pricing

Strategic Roadmap

# Phased Execution Strategy

## Phase 1 (0–9 months)

- Produce 15–20 units, launch 3 pilot programs, and

## Phase 3 (18+ months)

- Scale production to 50+ units, support early-stage revenue generation, & prepare for seed funding

## Vantare VantageSuit roadmap defines a phased execution plan covering product

deployment, validation, and expansion across performance environments.

# Building a High-Margin, Scalable Model

## The financial outlook reflects a hybrid structure combining upfront product sales with

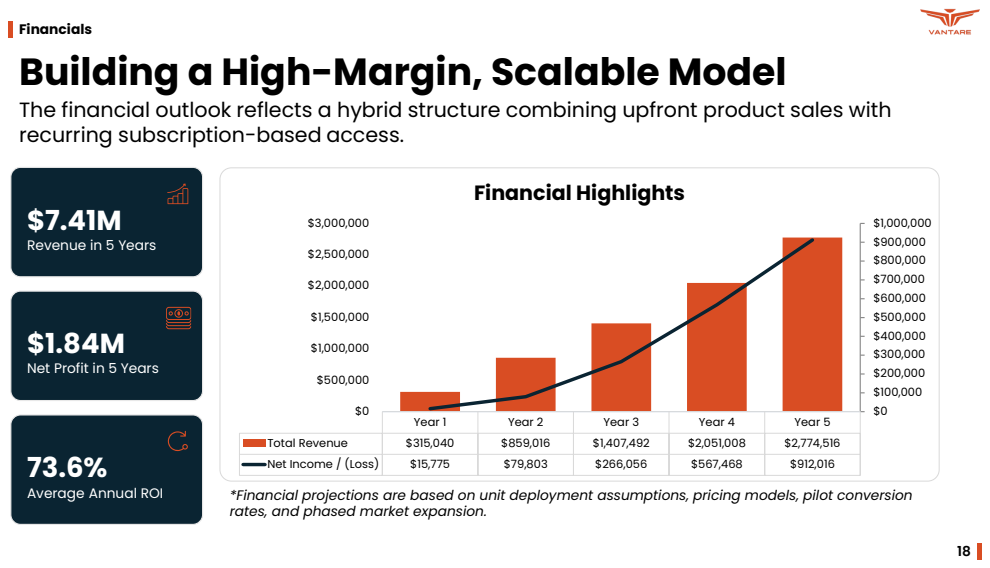
[picture p69: page 18]
Financials; Financial Highlights

recurring subscription-based access.

Revenue in 5 Years

Net Profit in 5 Years

Year 1 | Year 2 | Year 3 | Year 4 | Year 5

Total Revenue | $315,040 | $859,016 | $1,407,492 | $2,051,008 | $2,774,516
Net Income / (Loss) | $15,775 | $79,803 | $266,056 | $567,468 | $912,016

Average Annual ROI

*Financial projections are based on unit deployment assumptions, pricing models, pilot conversion
rates, and phased market expansion.

# Funding to Drive Deployment and Validation

Vantare VantageSuit is seeking investment to transition from prototype readiness to real-world

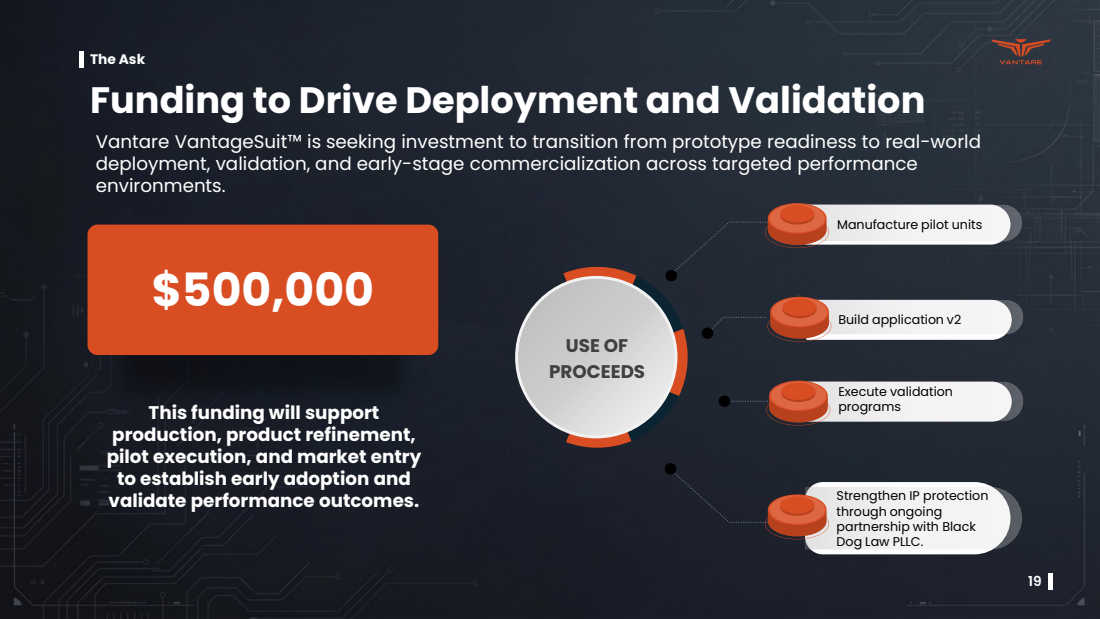
[picture p70: page 19]
The Ask; USE OF PROCEEDS; Build application v2; Execute validation programs

deployment, validation, and early-stage commercialization across targeted performance
environments.

Manufacture pilot units

This funding will support
production, product refinement,
pilot execution, and market entry
to establish early adoption and
validate performance outcomes.

Strengthen IP protection
through ongoing
partnership with Black
Dog Law PLLC.

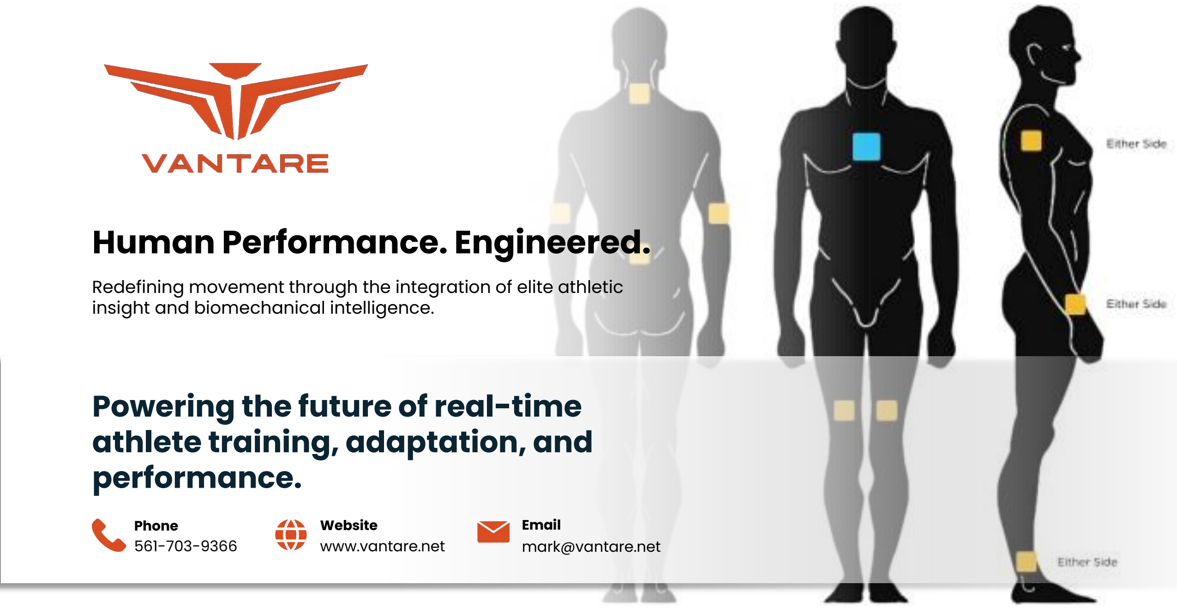
[picture p71: page 20]

20

Human Performance. Engineered.

Redefining movement through the integration of elite athletic insight and biomechanical intelligence.

# Powering the future of real-time athlete training, adaptation, and

performance.

Phone
561-703-9366

Email
mark@vantare.net

Website
www.vantare.net
