machadevrepos/Vantare_Vantage_Suit/Docs/Vantage_Component_list.xlsx

 | Quantity | Price/unit | Total Price | Note | Link | Local Availability
STM32WB55CG | 5 | $8.41 | 42.05 |  | https://www.aliexpress.com/item/1005007119406784.html?curPageLogUid=1kyLN33iCBkm
or nRF 5340 | 5 | $63.39 | 316.95 | instead of STM we can use this due to its higher performance but the drawback could be high price | https://www.aliexpress.com/item/1005009779397672.html?curPageLogUid=McXtCieCkKVZ&utparam-url=scene%3Asearch|query_from%3A|x_object_id%3A1005009779397672|_p_origin_prod%3A
4KHZ Buzzer | 4 | $1.91 | 7.64 |  | https://www.aliexpress.com/item/1005009589049639.html?curPageLogUid=4HAyTh37b3zS
Vibration Motor DC 3V | 4 | $2.07 | 8.28 | locally available | https://www.aliexpress.com/item/1005007600971536.html?curPageLogUid=x8iPAnTSgmjD | https://electrobes.com/product/3v-6v-dc-mini-coin-vibration-motor-miniature-micro-vibrator/
IMU BNO085 | 4 | $22.32 | 89.28 |  | https://www.aliexpress.com/item/1005010533705883.html?curPageLogUid=lUDpyoDrCCzh
ICM-45686 IMU SENSOR | 4 | $7.81 | 31.24 |  | https://www.aliexpress.com/item/1005010459308693.html?curPageLogUid=V4EVMkfAnmvl
MAX485 Module RS-485 | 8 | $1.02 | 8.16 | locally available | https://www.aliexpress.com/item/1005007539932947.html?curPageLogUid=RFn3M7zAKkh1&utparam-url=scene%3Asearch|query_from%3A|x_object_id%3A1005007539932947|_p_origin_prod%3A1005008258254062 | https://electrobes.com/product/uart-ttl-to-rs485-converter-module/
RS485 Twisted Pair Shielded Cable 26awg | 10m | $20.09 | 15.8 | make sure its a 4 core cable | https://www.aliexpress.com/item/1005006546939974.html?curPageLogUid=JUjTtfaylVYK&utparam-url=scene%3Asearch|query_from%3A|x_object_id%3A1005006546939974|_p_origin_prod%3A
Flex Sensors | 4 | $4.33 | 17.32 |  | https://www.aliexpress.com/item/1005010471550362.html?curPageLogUid=tT85eVDygi15&utparam-url=scene%3Asearch|query_from%3A|x_object_id%3A1005010471550362|_p_origin_prod%3A
Total Price |  | $67.96 | 219.77 | excluding nrf price for now because nRF alone would cost 316.95
