machadevrepos/Vantare_Vantage_Suit/Docs/Files from Client/ExoSkeleton Master PCB V1.0.xlsx

Comment | Description | Manufacturer | MPN | Designator | Link | Quantity
2450AT18B100E | Antennas ANTENNA CHIP ISM 915MHZ | Johanson Dielectrics | 2450AT18B100E | ANT1, ANT2 | https://www.mouser.in/ProductDetail/Johanson-Technology/2450AT18B100E?qs=yCnrNFeXz%252Bh5MFsFIXGZGA%3D%3D | 2
10uF 10V 0402 X5R | 10V 10uF X5R ±20% 0402 Multilayer Ceramic Capacitors MLCC - SMD/SMT ROHS | Samsung Electro-Mechanics | CL05A106MQ5NUNC | C1, C9, C10, C25, C26, C30, C32, C34, C41, C50, C51, C63, C72, C73, C80, C88 | https://www.mouser.in/ProductDetail/Samsung-Electro-Mechanics/CL05A106MQ5NUNC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 | 16
47nF 50V 0402 X7R | 50V 47nF X7R ±10% 0402 Multilayer Ceramic Capacitors MLCC - SMD/SMT ROHS | Samsung Electro-Mechanics | CL05B473KB5VPNC | C2 | https://www.mouser.in/ProductDetail/Samsung-Electro-Mechanics/CL05B473KB5VPNC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 | 1
100nF 50V 0402 X7R | 50V 100nF X7R ±10% 0402 Multilayer Ceramic Capacitors MLCC - SMD/SMT ROHS | Samsung Electro-Mechanics | CL05B104KB54PNC | C3, C5, C7, C8, C17, C24, C27, C28, C31, C33, C35, C36, C38, C39, C42, C43, C44, C46, C48, C49, C58, C60, C61, C64, C65, C66, C68, C70, C71, C81, C82, C83, C86, C87 | https://www.mouser.in/ProductDetail/Samsung-Electro-Mechanics/CL05B104KB54PNC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 | 34
2.2uF 10V 0402 X5R | 10V 2.2uF X5R ±10% 0402 Multilayer Ceramic Capacitors MLCC - SMD/SMT ROHS | Samsung Electro-Mechanics | CL05A225KP5NSNC | C4, C6 | https://www.mouser.in/ProductDetail/Samsung-Electro-Mechanics/CL05A225KP5NSNC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 | 2
22uF 10V 0603 X5R | 22uF ±20% 10V Ceramic Capacitor X5R 0603 | Samsung Electro-Mechanics | CL10A226MP8NUNE | C11, C12, C13, C14, C15, C16, C18, C19, C20, C21, C22, C23 | https://www.mouser.in/ProductDetail/Samsung-Electro-Mechanics/CL10A226MP8NUNE?qs=gRKWieUq2Hb5O0PTfRKzDQ%3D%3D | 12
100pF 50V 0402 C0G | 50V 100pF C0G ±5% 0402 Multilayer Ceramic Capacitors MLCC - SMD/SMT ROHS | Vishay | GA0402A101JXAAC31G | C37, C40, C59, C62 | https://www.mouser.in/ProductDetail/Vishay-Vitramon/GA0402A101JXAAC31G?qs=y6ZabgHbY%252ByIrHtIRnCYQg%3D%3D | 4
4.7uF 10V 0402 X5R | 10V 4.7uF X5R ±20% 0402 Multilayer Ceramic Capacitors MLCC - SMD/SMT ROHS | Samsung Electro-Mechanics | CL05A475MP5NRNC | C45, C47, C67, C69 | https://www.mouser.in/ProductDetail/Samsung-Electro-Mechanics/CL05A475MP5NRNC?qs=o1waKiAPAqcD9NPTF25fGg%3D%3D | 4
15pF 50V 0402 C0G | 50V 15pF C0G ±5% 0402 Multilayer Ceramic Capacitors MLCC - SMD/SMT ROHS | Vishay | VJ0402A150JXAAC | C52, C53, C74, C75, C84, C85 | https://www.mouser.in/ProductDetail/Vishay-Vitramon/VJ0402A150JXAAC?qs=am5fBa4br%2FvB4vvn0AQ47A%3D%3D | 6
6pF 50V 0402 C0G | 50V 6pF C0G 0402 Multilayer Ceramic Capacitors MLCC - SMD/SMT ROHS | FH (Guangdong Fenghua Advanced Tech) | 0402CG6R0C500NT | C54, C55, C76, C77 | https://www.digikey.in/en/products/detail/cal-chip-electronics-inc/GMC04CG6R0C50NT/23028935 | 4
TVS0500DRVR | -40℃~+125℃ 155pF 400W@8/20us 43A@8/20us 5V 7.9V 70pA 9.2V IEC 61000-4-2 TVS Unidirectional WSON-6(2x2) ESD and Surge Protection (TVS/ESD) ROHS | Texas Instruments | TVS0500DRVR | D1, D2, D6, D8, D10, D12, D14, D16 | https://www.ti.com/product/TVS0500 | 8
1N5819WS | 40V 600mV@1A 1A SOD-323 Schottky Diodes ROHS | Shenzhen Slkormicro Semicon Co., Ltd. | 1N5819WS | D3, D4, D5, D21, D22 | https://www.digikey.in/en/products/detail/shenzhen-slkormicro-semicon-co-ltd/1N5819WS/26112850 | 5
SM712 | RS485 12A 15V 300W Bidirectional SOT-23 ESD and Surge Protection (TVS/ESD) ROHS | SMC Diode Solutions | SM712 | D7, D9, D11, D13, D15, D17 | https://www.digikey.in/en/products/detail/smc-diode-solutions/SM712/16584910 | 6
CDDFN10-3324P-ES | 8A 120W 9V 4V Unidirectional 3.3V DFN2510-10L ESD and Surge Protection (TVS/ESD) ROHS | Bourns Inc. | CDDFN10-3324P-ES | D18, D19 | https://www.digikey.in/en/products/detail/bourns-inc/CDDFN10-3324P/5019648 | 2
RGB LED | -30℃~+85℃ 1.5mm 1.6mm 110° 1mm Common Anode R:2V、G:2.7V、B:2.8V R:48mW、G:64mW、B:64mW R:48mcd、G:155mcd、B:25mcd R:622nm、G:526nm、B:470nm R:8mA、G:5mA、B:3mA Top-mount SMD-4P,1.6x1.5mm RGB LEDs ROHS | Foshan NationStar Optoelectronics | NH-B1515RGBA-HF | D20 | https://www.digikey.com/en/products/detail/xinglight/XL-B1515RGBA-HF/25673124 | 1
SP3031-01ETG | 5A@8/20us 7.5V 6V Unidirectional 5V SOD-882 ESD and Surge Protection (TVS/ESD) ROHS | Littelfuse | SP3031-01ETG | D23, D24, D25 | https://www.mouser.in/ProductDetail/Littelfuse/SP3031-01ETG?qs=B%2FZyIADl9o%252B%2FfpJwZJPmLg%3D%3D | 3
BLM21SP111SN1D | -55℃~+125℃ 1 110Ω@100MHz 13mΩ 5A ±25% 0805 Ferrite Beads ROHS | Murata Electronics | BLM21SP111SN1D | FB1, FB2, FB3 | https://www.mouser.in/ProductDetail/Murata-Electronics/BLM21SP111SN1D?qs=byeeYqUIh0MCjH4e%2FBBFzA%3D%3D | 3
BLM15AX102SN1D | Ferrite Bead 0402 Murata BLM15PX Series | Murata | BLM15AX102SN1D | FB4, FB5, FB6, FB7, FB8, FB9, FB10, FB11, FB12, FB13, FB14, FB15 | https://www.mouser.in/ProductDetail/Murata-Electronics/BLM15AX102SN1D?qs=MY6wChARw2zFsmOR09MDxg%3D%3D | 12
TYPEC-304J-BCP16 | 5A USB 3.1 1 260℃ Surface Mount 16 Female -40℃~+85℃ Type-C SMD USB Connectors ROHS |  |  | J1 |  | 1
1uH 3.3A 1008 | 1uH 3.3A 4.7A 40mΩ ±20% 1008 Power Inductors ROHS | Murata Electronics | DFE252012F-1R0M=P2 | L1, L2, L3 | https://www.mouser.in/ProductDetail/Murata-Electronics/DFE252012F-1R0M%3dP2?qs=ty6qhqyUUEtPvXJAIo0Pnw%3D%3D | 3
10nF 300mA 0402 | 10nH 3.2GHz 300mA 400mΩ 8@100MHz ±5% 0402 Inductors (SMD) ROHS | Sunlord | SDCL1005C10NJTDF | L4, L7 | https://www.mouser.in/ProductDetail/Johanson-Technology/LRC0402CJ10NGV001T?qs=jRuttqqUwMSWUSZ1JoAk2Q%3D%3D | 2
10uH 400mA 0603 | 10uH 400mA 550mΩ ±20% 0603 Inductors (SMD) ROHS | TDK | MLZ1608E100MT | L5, L8 | https://www.mouser.in/ProductDetail/TDK/MLZ1608E100MT?qs=chjFIDm9dbpIEfuxjG5mwA%3D%3D&mgh=1 | 2
0R 0402 | 10nH 3.2GHz 300mA 400mΩ 8@100MHz ±5% 0402 Inductors (SMD) ROHS | UNI-ROYAL(Uniroyal Elec) | 0402WGF0000TCE | L6, L9 | https://www.mouser.in/ProductDetail/Royalohm/0402WGF0000TCE?qs=e8oIoAS2J1QQohiDIE5NFA%3D%3D | 2
SMD BUZZER | -20℃~+70℃ 100mA 2.5mm 2V~4V 3V 4kHz 5.2mm 5.2mm 75dB Electromagnetic Passive (Externally Driven) SMD,5x5mm Buzzers ROHS | Jiangsu Huaneng Elec | MLT-5020 | LS1 | https://www.hqonline.com/product-detail/alarm-buzzer-siren-hndz-mlt-5020-2500283770 | 1
JST-GH-04P-RA | -25℃~+85℃ 1 1.25mm 1A 1x4P 4 4.25mm 4P 50V 8.25mm Auxiliary Solder Pin GH LCP Phosphor bronze Surface Mount, Right Angle Tin UL94V-0 SMD,P=1.25mm,Surface Mount，Right Angle Wire To Board Connector ROHS | XKB Connection | JST | P2, P3, P4, P5, P6, P7 | https://www.mouser.in/ProductDetail/JST-Commercial/SM04B-GHS-TBLFSN?qs=QpmGXVUTftGayLYZQBIuZw%3D%3D | 6
AO3400A | -55℃~+150℃@(Tj) 1.45V@250uA 30V 48mΩ@2.5V 630pF@15V 7nC@10V N-Channel SOT-23-3L MOSFETs ROHS | Alpha & Omega Semicon | AO3400A | Q1, Q2 | https://www.digikey.in/en/products/detail/alpha-omega-semiconductor-inc/AO3400A/1855772 | 2
10k 0402 | Thick Film Resistors - SMD 0402 62.5 mW (1/16 W) 1% 10K | UNI-ROYAL(Uniroyal Elec) | 0402WGF1002TCE | R1, R3, R6, R7, R11, R17, R18, R24, R27, R31, R34, R35, R37, R38, R40, R41, R43, R46, R47, R48, R59 | https://www.mouser.in/ProductDetail/Royalohm/0402WGF1002TCE?qs=e8oIoAS2J1T9%2FSfQTy4YqQ%3D%3D | 21
137k 0402 | Thick Film Resistors - SMD 0402 62.5 mW (1/16 W) 1% 10K | UNI-ROYAL | 0402WGF1373TCE | R2, R4, R9 | https://www.mouser.in/ProductDetail/Royalohm/0402WGF1373TCE?qs=e8oIoAS2J1RSI%2FTPO1rFCA%3D%3D | 3
14k 0402 | -55℃~+155℃ 14kΩ 50V 62.5mW Thick Film Resistor ±1% ±100ppm/℃ 0402 Chip Resistor - Surface Mount ROHS | UNI-ROYAL(Uniroyal Elec) | 0402WGF1402TCE | R5 | https://www.mouser.in/ProductDetail/Royalohm/0402WGF1402TCE?qs=e8oIoAS2J1RJuzskQU9GMA%3D%3D | 1
768k 0402 | Thick Film Resistors - SMD 0402 62.5 mW (1/16 W) 1% 10K | UNI-ROYAL(Uniroyal Elec) | 0402WGF7683TCE | R8 | www.mouser.com/ProductDetail/Royalohm/0402WGF7683TCE?qs=e8oIoAS2J1TZU81G2s0BIw%3D%3D | 1
30.9K 0402 | -55℃~+155℃ 30.9kΩ 50V 62.5mW Thick Film Resistor ±1% ±100ppm/℃ 0402 Chip Resistor - Surface Mount ROHS | UNI-ROYAL(Uniroyal Elec) | 0402WGF3092TCE | R10 | https://www.mouser.com/ProductDetail/Royalohm/0402WGF3092TCE?qs=e8oIoAS2J1Taod5Yg%2F2i9w%3D%3D | 1
180K 0402 | -55℃~+155℃ 180kΩ 50V 62.5mW Thick Film Resistor ±1% ±100ppm/℃ 0402 Chip Resistor - Surface Mount ROHS | UNI-ROYAL(Uniroyal Elec) | 0402WGF1803TCE | R12, R14 | https://www.mouser.in/ProductDetail/Royalohm/0402WGF1803TCE?qs=e8oIoAS2J1QaedrqcHxcvw%3D%3D | 2
1.62M 0402 | -55℃~+155℃ 1.62MΩ 50V 62.5mW Thick Film Resistor ±1% ±100ppm/℃ 0402 Chip Resistor - Surface Mount ROHS | UNI-ROYAL(Uniroyal Elec) | RC0402FR-071M62L | R13 | https://www.mouser.in/ProductDetail/YAGEO/RC0402FR-071M62L?qs=sxZXDnvRBEhFeauARDSpQA%3D%3D | 1
0R 0402 | Thick Film Resistors - SMD RMC 0402 1/16W 1% T/R-10000 | UNI-ROYAL(Uniroyal Elec) | 0402WGF0000TCE | R15, R69 | https://www.mouser.in/ProductDetail/Royalohm/0402WGF0000TCE?qs=e8oIoAS2J1QQohiDIE5NFA%3D%3D | 2
2K 0402 | Thick Film Resistors - SMD RMC 0402 1/16W 1% T/R-10000 | UNI-ROYAL(Uniroyal Elec) | 0402WGF2001TCE | R20 | https://www.mouser.in/ProductDetail/Royalohm/0402WGF2001TCE?qs=e8oIoAS2J1SkMQvjTM5e8Q%3D%3D | 1
5.1K 0402 | Thick Film Resistors - SMD RMC 0402 1/16W 1% T/R-10000 | UNI-ROYAL(Uniroyal Elec) | 0402WGF5101TCE | R21, R30, R33, R60, R61, R66, R67 | https://www.mouser.in/ProductDetail/Royalohm/0402WGF5101TCE?qs=e8oIoAS2J1TXcMSJPHU1Ew%3D%3D | 7
22R 0402 | Thick Film Resistors - SMD RMC 0402 1/16W 1% T/R-10000 | UNI-ROYAL(Uniroyal Elec) | 0402WGF220JTCE | R22, R23, R25, R26 | https://www.mouser.in/ProductDetail/Royalohm/0402WGF220JTCE?qs=e8oIoAS2J1SfW%252BMYbRP45Q%3D%3D | 4
1K 0402 | Thick Film Resistors - SMD RMC 0402 1/16W 1% T/R-10000 | UNI-ROYAL(Uniroyal Elec) | 0402WGF1001TCE | R28, R29, R32 | https://www.mouser.in/ProductDetail/Royalohm/0402WGF1001TCE?qs=e8oIoAS2J1RlrMC0w7DkrQ%3D%3D | 3
2.43K 0402 | 62.5mW Thick Film Resistor 50V ±100ppm/℃ ±1% 2.43kΩ 0402 Chip Resistor - Surface Mount ROHS | UNI-ROYAL(Uniroyal Elec) | RC0402FR-072K43L | R50, R52, R56, R57 | https://www.mouser.in/ProductDetail/YAGEO/RC0402FR-072K43L?qs=uhiLka0QEaFAaSrxN7NKpQ%3D%3D | 4
120R 0402 | Thick Film Resistors - SMD RMC 0402 1/16W 1% T/R-10000 | UNI-ROYAL(Uniroyal Elec) | 0402WGF1200TCE | R70 | https://www.mouser.in/ProductDetail/Royalohm/0402WGF1200TCE?qs=e8oIoAS2J1RgyR7SId1NOw%3D%3D | 1
BQ25308RTER | BQ25308 Standalone 1-Cell, 17V, 3.0A Battery Charger with Dead Battery Charge Inhibit | Texas Instruments | BQ25308RTER | U1 | https://www.mouser.in/ProductDetail/Texas-Instruments/BQ25308RTER?qs=HFfMDpzxxd2C%252BtwxOSaWsg%3D%3D | 1
TPS63020DSJR | Buck-boost type Adjustable 1.2V~5.5V 1.8V~5.5V 3.5A DFN-14-EP(3x4) DC-DC Converters ROHS | Texas Instruments | TPS63020DSJR | U2, U4 | https://www.mouser.com/c/?q=TPS63020DSJR | 2
TPS2117DRLR | 3.3-V to 5-V 12-Mbps half-duplex RS-485 transceiver auto-direction control ±12-kV IEC ESD | Texas Instruments | TPS2117DRLR | U3 | https://www.ti.com/product/TPS2117 | 1
THVD1426DRLR | 3.3-V to 5-V 12-Mbps half-duplex RS-485 transceiver auto-direction control ±12-kV IEC ESD | Texas Instruments | THVD1426DRLR | U5 | https://www.ti.com/product/THVD1426 | 1
PT2041AD6 | -40℃~+85℃ 1 2.4V~5.5V 2uA 2uA 4kV Capacitive Touch No WDFN-6-EP(2x2) Touch Sensors ROHS | PinTeng | PT2041AD6 | U6 | https://www.mouser.in/ProductDetail/TDK-InvenSense/ICM-45686?qs=vvQtp7zwQdPk96IFOwypvQ%3D%3D | 1
Micro SD card Slot | -25℃~+90℃ 2mm Gold Deck MicroSD card (TF card) 260℃ Copper Alloy Self bomb SMD SD Card / Memory Card Connector ROHS | XKB Connection | XKTF-015-G | U7 | https://www.ktron.in/product/micro-sd-card-holder-smd-push-type/?v=c86ee0d9d7ed | 1
SMD ERM Motor | 14000±2500rpm Cylindrical DC Motor 2.7V CW - Vibration Motors ROHS | KOTL | Z3OC1T8219731 | U8 | https://www.digikey.in/en/products/detail/ineed-motor/IND-SMD-001/15795986?gad_campaignid=20127178981 | 1
STM32WB55CGU6 | Multiprotocol wireless 32-bit MCU Arm®- ased Cortex®-M4 with FPU, Bluetooth® 5.4 and 802.15.4 radio solution | STMicroelectronics | STM32WB55CGU6 | U9, U11 | https://www.mouser.in/ProductDetail/STMicroelectronics/STM32WB55CGU6?qs=lYGu3FyN48eI3bRY%252B36gew%3D%3D | 2
MLPF-WB55-01E3 | Signal Conditioning 2.4 GHz Matched filter companion chip for STM32WB55Cx and STM32WB55Rx | STMicroelectronics | MLPF-WB55-01E3 | U10, U12 | https://www.mouser.in/ProductDetail/STMicroelectronics/MLPF-WB55-01E3?qs=vLWxofP3U2xV%2FkxL9PmCDA%3D%3D | 2
BNO085 | IMUs - Inertial Measurement Units 9-axis IMU | CEVA | BNO085 | U13 | https://www.mouser.in/ProductDetail/CEVA/BNO085?qs=ulEaXIWI0c9BFVeZDQCmmQ%3D%3D | 1
ICM-45686 | IMUs - Inertial Measurement Units Ultra-Low Power, High-Performance Integrated 6-Axis MEMS MotionTracking Device with BalanceGyro Technology, 4000dps/ 32g, dual interface | TDK InvenSense | ICM-45686 | U14 | https://www.mouser.in/ProductDetail/TDK-InvenSense/ICM-45686?qs=vvQtp7zwQdPk96IFOwypvQ%3D%3D | 1
32.768KHz XTAL | 32.768kHz Crystal Oscillator 12.5pF ±20ppm ±30ppm SMD3215-2P Crystals ROHS | ABRACON | ABS07N-32.768kHz-T | Y1, Y3, Y5 | https://www.mouser.in/ProductDetail/ABRACON/ABS07N-32768kHz-T?qs=7%2F6SraaimPRg0eKp7E9hQw%3D%3D&mgh=1 | 3
32MHz 2016-4P | -40℃~+85℃ 32MHz 8pF Crystal Oscillator ±10ppm ±20ppm SMD2016-4P Crystals ROHS | YXC Crystal Oscillators | XL7EL89CKI-111YLC-32M | Y2, Y4 | https://www.xonelec.com/mpn/yangxing/xl7el89cki111ylc32m | 2
