machadevrepos/Vantare_Vantage_Suit/Docs/P037-Exoskeleton/Exoskeleton Node PCB V1.1/Manufacturing Files/ExoSkeleton Node PCB V1.1.xlsx

Comment | Manufacturer | MPN | Designator | Link | Quantity
2450AT18B100E | Johanson Dielectrics | 2450AT18B100E | ANT1 | https://www.mouser.in/ProductDetail/Johanson-Technology/2450AT18B100E?qs=yCnrNFeXz%252Bh5MFsFIXGZGA%3D%3D | 1
10uF 10V 0402 X5R | Samsung Electro-Mechanics | CL05A106MQ5NUNC | C1, C2, C4, C6, C14, C19, C25, C26, C32, C34, C41, C50, C51, C80, C88 | https://www.mouser.in/ProductDetail/Samsung-Electro-Mechanics/CL05A106MQ5NUNC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 | 15
22uF 10V 0603 X5R | Samsung Electro-Mechanics | CL10A226MP8NUNE | C3, C9, C11, C12, C13, C16 | https://www.mouser.in/ProductDetail/Samsung-Electro-Mechanics/CL10A226MP8NUNE?qs=gRKWieUq2Hb5O0PTfRKzDQ%3D%3D | 6
100nF 50V 0402 X7R | Samsung Electro-Mechanics | CL05B104KB54PNC | C5, C7, C8, C10, C15, C17, C18, C27, C28, C33, C35, C36, C38, C39, C42, C43, C44, C46, C48, C49, C81, C82, C83, C86, C87 | https://www.mouser.in/ProductDetail/Samsung-Electro-Mechanics/CL05B104KB54PNC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 | 25
100pF 50V 0402 C0G | Vishay | GA0402A101JXAAC31G | C37, C40 | https://www.mouser.in/ProductDetail/Vishay-Vitramon/GA0402A101JXAAC31G?qs=y6ZabgHbY%252ByIrHtIRnCYQg%3D%3D | 2
4.7uF 10V 0402 X5R | Samsung Electro-Mechanics | CL05A475MP5NRNC | C45, C47 | https://www.mouser.in/ProductDetail/Samsung-Electro-Mechanics/CL05A475MP5NRNC?qs=o1waKiAPAqcD9NPTF25fGg%3D%3D | 2
15pF 50V 0402 C0G | Vishay | VJ0402A150JXAAC | C52, C53, C84, C85 | https://www.mouser.in/ProductDetail/Vishay-Vitramon/VJ0402A150JXAAC?qs=am5fBa4br%2FvB4vvn0AQ47A%3D%3D | 4
6pF 50V 0402 C0G | FH (Guangdong Fenghua Advanced Tech) | 0402CG6R0C500NT | C54, C55 | https://www.digikey.in/en/products/detail/cal-chip-electronics-inc/GMC04CG6R0C50NT/23028935 | 2
SP3031-01ETG | Littelfuse | SP3031-01ETG | D1, D6, D8, D11, D12, D13 | https://www.mouser.in/ProductDetail/Littelfuse/SP3031-01ETG?qs=B%2FZyIADl9o%252B%2FfpJwZJPmLg%3D%3D | 6
TVS0500DRVR | Texas Instruments | TVS0500DRVR | D2 | https://www.ti.com/product/TVS0500 | 1
1N5819WS | Shenzhen Slkormicro Semicon Co., Ltd. | 1N5819WS | D3, D4, D5, D21, D22 | https://www.digikey.in/en/products/detail/shenzhen-slkormicro-semicon-co-ltd/1N5819WS/26112850 | 5
SM712 | SMC Diode Solutions | SM712 | D7, D9 | https://www.digikey.in/en/products/detail/smc-diode-solutions/SM712/16584910 | 2
ESD351DPYR | Texas Instruments | ESD351DPYR | D10 | https://www.mouser.in/ProductDetail/Texas-Instruments/ESD351DPYR?qs=w%2Fv1CP2dgqqeRo4Km2by%252BQ%3D%3D | 1
RGB LED | Foshan NationStar Optoelectronics | NH-B1515RGBA-HF | D20 | https://www.digikey.com/en/products/detail/xinglight/XL-B1515RGBA-HF/25673124 | 1
BLM15AX102SN1D | Murata | BLM15AX102SN1D | FB1, FB3, FB4, FB5, FB6, FB7, FB8, FB9, FB10, FB14, FB15 | https://www.mouser.in/ProductDetail/Murata-Electronics/BLM15AX102SN1D?qs=MY6wChARw2zFsmOR09MDxg%3D%3D | 11
BLM21SP111SN1D | Murata Electronics | BLM21SP111SN1D | FB2 | https://www.mouser.in/ProductDetail/Murata-Electronics/BLM21SP111SN1D?qs=byeeYqUIh0MCjH4e%2FBBFzA%3D%3D | 1
TYPEC-304J-BCP16 |  |  | J1 |  | 1
1uH 3.3A 1008 | Murata Electronics | DFE252012F-1R0M=P2 | L2 | https://www.mouser.in/ProductDetail/Murata-Electronics/DFE252012F-1R0M%3dP2?qs=ty6qhqyUUEtPvXJAIo0Pnw%3D%3D | 1
10nF 300mA 0402 | Sunlord | SDCL1005C10NJTDF | L4 | https://www.mouser.in/ProductDetail/Johanson-Technology/LRC0402CJ10NGV001T?qs=jRuttqqUwMSWUSZ1JoAk2Q%3D%3D | 1
10uH 400mA 0603 | TDK | MLZ1608E100MT | L5 | https://www.mouser.in/ProductDetail/TDK/MLZ1608E100MT?qs=chjFIDm9dbpIEfuxjG5mwA%3D%3D&mgh=1 | 1
0R 0402 | UNI-ROYAL(Uniroyal Elec) | 0402WGF0000TCE | L6 | https://www.mouser.in/ProductDetail/Royalohm/0402WGF0000TCE?qs=e8oIoAS2J1QQohiDIE5NFA%3D%3D | 1
SMD BUZZER | Jiangsu Huaneng Elec | MLT-5020 | LS1 | https://www.hqonline.com/product-detail/alarm-buzzer-siren-hndz-mlt-5020-2500283770 | 1
JST-GH-04P-RA | XKB Connection | JST | P2, P3 | https://www.mouser.in/ProductDetail/JST-Commercial/SM04B-GHS-TBLFSN?qs=QpmGXVUTftGayLYZQBIuZw%3D%3D | 2
AO3400A | Alpha & Omega Semicon | AO3400A | Q1, Q2 | https://www.digikey.in/en/products/detail/alpha-omega-semiconductor-inc/AO3400A/1855772 | 2
2K 0402 | UNI-ROYAL(Uniroyal Elec) | 0402WGF2001TCE | R1, R20 | https://www.mouser.in/ProductDetail/Royalohm/0402WGF2001TCE?qs=e8oIoAS2J1SkMQvjTM5e8Q%3D%3D | 2
137k 0402 | UNI-ROYAL, UNI-ROYAL(Uniroyal Elec) | 0402WGF1373TCE | R2, R3, R4, R5, R9 | https://www.mouser.in/ProductDetail/Royalohm/0402WGF1373TCE?qs=e8oIoAS2J1RSI%2FTPO1rFCA%3D%3D | 5
22R 0402 | UNI-ROYAL(Uniroyal Elec) | 0402WGF220JTCE | R6, R7, R12, R13 | https://www.mouser.in/ProductDetail/Royalohm/0402WGF220JTCE?qs=e8oIoAS2J1SfW%252BMYbRP45Q%3D%3D | 4
768k 0402 | UNI-ROYAL(Uniroyal Elec) | 0402WGF7683TCE | R8 | www.mouser.com/ProductDetail/Royalohm/0402WGF7683TCE?qs=e8oIoAS2J1TZU81G2s0BIw%3D%3D | 1
30.9K 0402 | UNI-ROYAL(Uniroyal Elec) | 0402WGF3092TCE | R10 | https://www.mouser.com/ProductDetail/Royalohm/0402WGF3092TCE?qs=e8oIoAS2J1Taod5Yg%2F2i9w%3D%3D | 1
10k 0402 | UNI-ROYAL(Uniroyal Elec) | 0402WGF1002TCE | R11, R16, R17, R24, R31, R34, R35, R37, R41, R43, R46, R47, R48, R59 | https://www.mouser.in/ProductDetail/Royalohm/0402WGF1002TCE?qs=e8oIoAS2J1T9%2FSfQTy4YqQ%3D%3D | 14
5.1K 0402 | UNI-ROYAL(Uniroyal Elec) | 0402WGF5101TCE | R14, R15, R21, R30, R33, R60, R61 | https://www.mouser.in/ProductDetail/Royalohm/0402WGF5101TCE?qs=e8oIoAS2J1TXcMSJPHU1Ew%3D%3D | 7
0R 0402 | UNI-ROYAL(Uniroyal Elec) | 0402WGF0000TCE | R18, R22 | https://www.mouser.in/ProductDetail/Royalohm/0402WGF0000TCE?qs=e8oIoAS2J1QQohiDIE5NFA%3D%3D | 2
120R 0402 | UNI-ROYAL(Uniroyal Elec) | 0402WGF1200TCE | R19 | https://www.mouser.in/ProductDetail/Royalohm/0402WGF1200TCE?qs=e8oIoAS2J1RgyR7SId1NOw%3D%3D | 1
20K 0.1% 0603 | YAGEO | RT0603BRD0720KL | R25, R26, R27 | https://www.mouser.in/ProductDetail/YAGEO/RT0603BRD0720KL?qs=Br90QIIERxRwlDio38URkw%3D%3D | 3
1K 0402 | UNI-ROYAL(Uniroyal Elec) | 0402WGF1001TCE | R28, R29, R32 | https://www.mouser.in/ProductDetail/Royalohm/0402WGF1001TCE?qs=e8oIoAS2J1RlrMC0w7DkrQ%3D%3D | 3
10K 0.1% 0603 | YAGEO | 0603WAF1002T5E | R38, R39 | https://www.mouser.in/ProductDetail/YAGEO/RT0603BRD0710KL?qs=Br90QIIERxSXuxEMyECqGA%3D%3D | 2
2.43K 0402 | UNI-ROYAL(Uniroyal Elec) | RC0402FR-072K43L | R50, R52, R56, R57 | https://www.mouser.in/ProductDetail/YAGEO/RC0402FR-072K43L?qs=uhiLka0QEaFAaSrxN7NKpQ%3D%3D | 4
TP4054 | GOODWORK | TP4054 | U1 | https://www.digikey.com/en/products/detail/umw/TP4054/17635214 | 1
TPS63020DSJR | Texas Instruments | TPS63020DSJR | U2 | https://www.mouser.com/c/?q=TPS63020DSJR | 1
TPS2117DRLR | Texas Instruments | TPS2117DRLR | U3 | https://www.ti.com/product/TPS2117 | 1
W25Q256JVEIQ | Winbond Electronics | W25Q256JVEIQ | U4 | https://www.mouser.in/ProductDetail/Winbond/W25Q256JVEIQ?qs=qSfuJ%252Bfl%2Fd4o%2FNFUf7yCgA%3D%3D | 1
THVD1426DRLR | Texas Instruments | THVD1426DRLR | U5 | https://www.ti.com/product/THVD1426 | 1
PT2041AD6 | PinTeng | PT2041AD6 | U6 | https://www.mouser.in/ProductDetail/TDK-InvenSense/ICM-45686?qs=vvQtp7zwQdPk96IFOwypvQ%3D%3D | 1
TLV8802DGKR | Texas Instruments | TLV8802DGKR | U7 | https://www.mouser.in/ProductDetail/Texas-Instruments/TLV8802DGKR?qs=aVyJF2WnouRxTiFmfwY8sQ%3D%3D | 1
SMD ERM Motor | KOTL | Z3OC1T8219731 | U8 | https://www.digikey.in/en/products/detail/ineed-motor/IND-SMD-001/15795986?gad_campaignid=20127178981 | 1
STM32WB55CGU6 | STMicroelectronics | STM32WB55CGU6 | U9 | https://www.mouser.in/ProductDetail/STMicroelectronics/STM32WB55CGU6?qs=lYGu3FyN48eI3bRY%252B36gew%3D%3D | 1
MLPF-WB55-01E3 | STMicroelectronics | MLPF-WB55-01E3 | U10 | https://www.mouser.in/ProductDetail/STMicroelectronics/MLPF-WB55-01E3?qs=vLWxofP3U2xV%2FkxL9PmCDA%3D%3D | 1
REF3025AIDBZR | Texas Instruments | REF3025AIDBZR | U11 | https://www.mouser.in/ProductDetail/Texas-Instruments/REF3025AIDBZR?qs=sSOk4GDDv7xc9PQEJ%2FIkkg%3D%3D | 1
BNO085 | CEVA | BNO085 | U13 | https://www.mouser.in/ProductDetail/CEVA/BNO085?qs=ulEaXIWI0c9BFVeZDQCmmQ%3D%3D | 1
ICM-45686 | TDK InvenSense | ICM-45686 | U14 | https://www.mouser.in/ProductDetail/TDK-InvenSense/ICM-45686?qs=vvQtp7zwQdPk96IFOwypvQ%3D%3D | 1
32.768KHz XTAL | ABRACON | ABS07N-32.768kHz-T | Y1, Y5 | https://www.mouser.in/ProductDetail/ABRACON/ABS07N-32768kHz-T?qs=7%2F6SraaimPRg0eKp7E9hQw%3D%3D&mgh=1 | 2
32MHz 2016-4P | YXC Crystal Oscillators | XL7EL89CKI-111YLC-32M | Y2 | https://www.xonelec.com/mpn/yangxing/xl7el89cki111ylc32m | 1
