machadevrepos/Vantare_Vantage_Suit/Docs/P037-Exoskeleton/Exoskeleton Master PCB V1.0/Manufacturing Files/STEP File/Exoskeleton Master STEP File.step

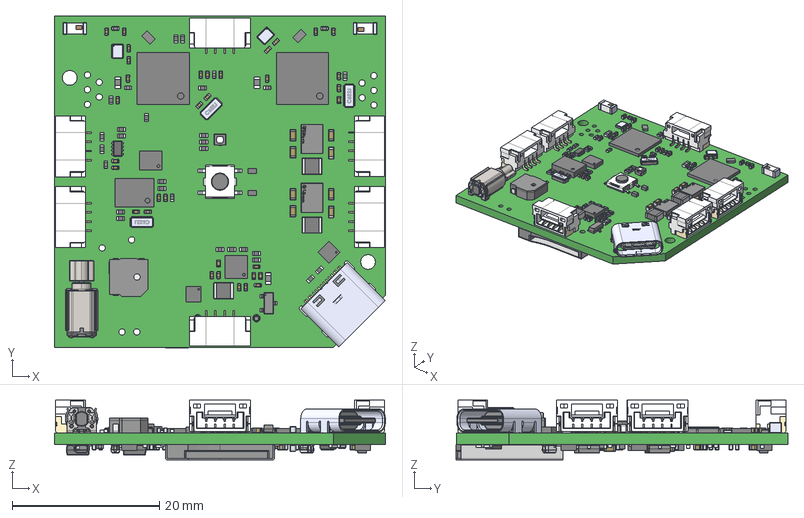
[picture p72: CAD file, 2026-08-03, an earlier design]
Docs/P037-Exoskeleton/Exoskeleton Master PCB V1.0/Manufacturing Files/STEP File/Exoskeleton Master STEP File.step
45.0 x 45.1 x 8.11 mm
bigPin x 6
Mid Body x 60
Mark x 60
FC-135 x 3
CX2016DB32000D0WZRC1_CX2016DB32000D0WZRC1 x 2
Pin Shape x 62
BODY-SOT x 2
Thermal Shape x 12
BLM18SG700TN1D x 5
BLM15AX102SN1D x 16
ON Semiconductor x 5
bar x 5
FRAME x 2
MOLD x 2
Texas Logo Yury x 2
Texas Logo Yury - Copy x 2
VIBRATING-MOTOR-SMD_3P-C9900001680~VIBRATING-MOTOR-SMD_ 3P-C9900001680~P7o008
VIBRATING-MOTOR-SMD_3P-C9900001680~VIBRATING-MOTOR-SMD_ 3P-C9900001680~P7o009
VIBRATING-MOTOR-SMD_3P-C9900001680~VIBRATING-MOTOR-SMD_ 3P-C9900001680~P7o010
VIBRATING-MOTOR-SMD_3P-C9900001680~VIBRATING-MOTOR-SMD_ 3P-C9900001680~P7o011
TF-SMD_XKTF-015-N~TF-SMD_XKTF-015-N~HLSF
TF-SMD_XKTF-015-N~TF-SMD_XKTF-015-N~HLSF001
TF-SMD_XKTF-015-N~TF-SMD_XKTF-015-N~HLSF002
TF-SMD_XKTF-015-N~TF-SMD_XKTF-015-N~HLSF003
TF-SMD_XKTF-015-N~TF-SMD_XKTF-015-N~HLSF004
TF-SMD_XKTF-015-N~TF-SMD_XKTF-015-N~HLSF005
TF-SMD_XKTF-015-N~TF-SMD_XKTF-015-N~HLSF006
TF-SMD_XKTF-015-N~TF-SMD_XKTF-015-N~HLSF007
TF-SMD_XKTF-015-N~TF-SMD_XKTF-015-N~HLSF008
TF-SMD_XKTF-015-N~TF-SMD_XKTF-015-N~HLSF009
TF-SMD_XKTF-015-N~TF-SMD_XKTF-015-N~HLSF010
Leader x 6
Lead x 6
Leads x 6
Nexp x 6
X peria x 6
2450AT18B100E--3DModel-STEP-269445 x 2
