machadevrepos/Vantare_Vantage_Suit/Docs/P037-Exoskeleton/Exoskeleton Node PCB V1.0/Manufacturing Files/STEP 3D/Exoskeleton Node STEP File.step

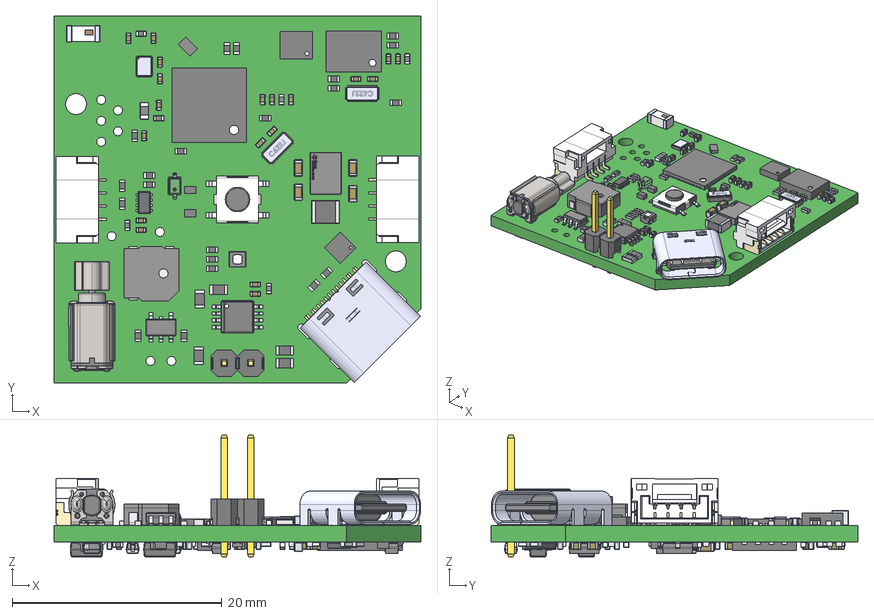
[picture p73: CAD file, 2026-08-03, an earlier design]
Docs/P037-Exoskeleton/Exoskeleton Node PCB V1.0/Manufacturing Files/STEP 3D/Exoskeleton Node STEP File.step
35.0 x 35.0 x 11.6 mm
Mid Body x 56
Mark x 56
BODY-SOT x 3
FRAME
MOLD
Texas Logo Yury
Texas Logo Yury - Copy
BLM18SG700TN1D x 2
Lead x 3
Leads x 3
Nexp x 3
X peria x 3
Leader x 14
BLM15AX102SN1D x 13
bigPin x 12
BODY-SON
ON Semiconductor x 5
bar x 5
Thermal Shape x 4
2450AT18B100E--3DModel-STEP-269445
FC-135 x 2
CX2016DB32000D0WZRC1_CX2016DB32000D0WZRC1
VIBRATING-MOTOR-SMD_3P-C9900001680~VIBRATING-MOTOR-SMD_ 3P-C9900001680~P7o008
VIBRATING-MOTOR-SMD_3P-C9900001680~VIBRATING-MOTOR-SMD_ 3P-C9900001680~P7o009
VIBRATING-MOTOR-SMD_3P-C9900001680~VIBRATING-MOTOR-SMD_ 3P-C9900001680~P7o010
VIBRATING-MOTOR-SMD_3P-C9900001680~VIBRATING-MOTOR-SMD_ 3P-C9900001680~P7o011
Pin Shape x 42
PLS (DS1021 CONNFLY)
LEAD-SOT x 5
LEAD-DUMMY
