machadevrepos/Vantare_Vantage_Suit/Docs/Files from Client/Exo-Skeleton Master PCB Schematics Release 1_1.22.26.pdf

# SWITCH MODE LI-ION/LI-PO BATTERY CHARGER (3A)

# 10uF 10V 0402 X5R 1 2 C¹⁰ 10uF ¹⁰V ⁰⁴⁰² X⁵R

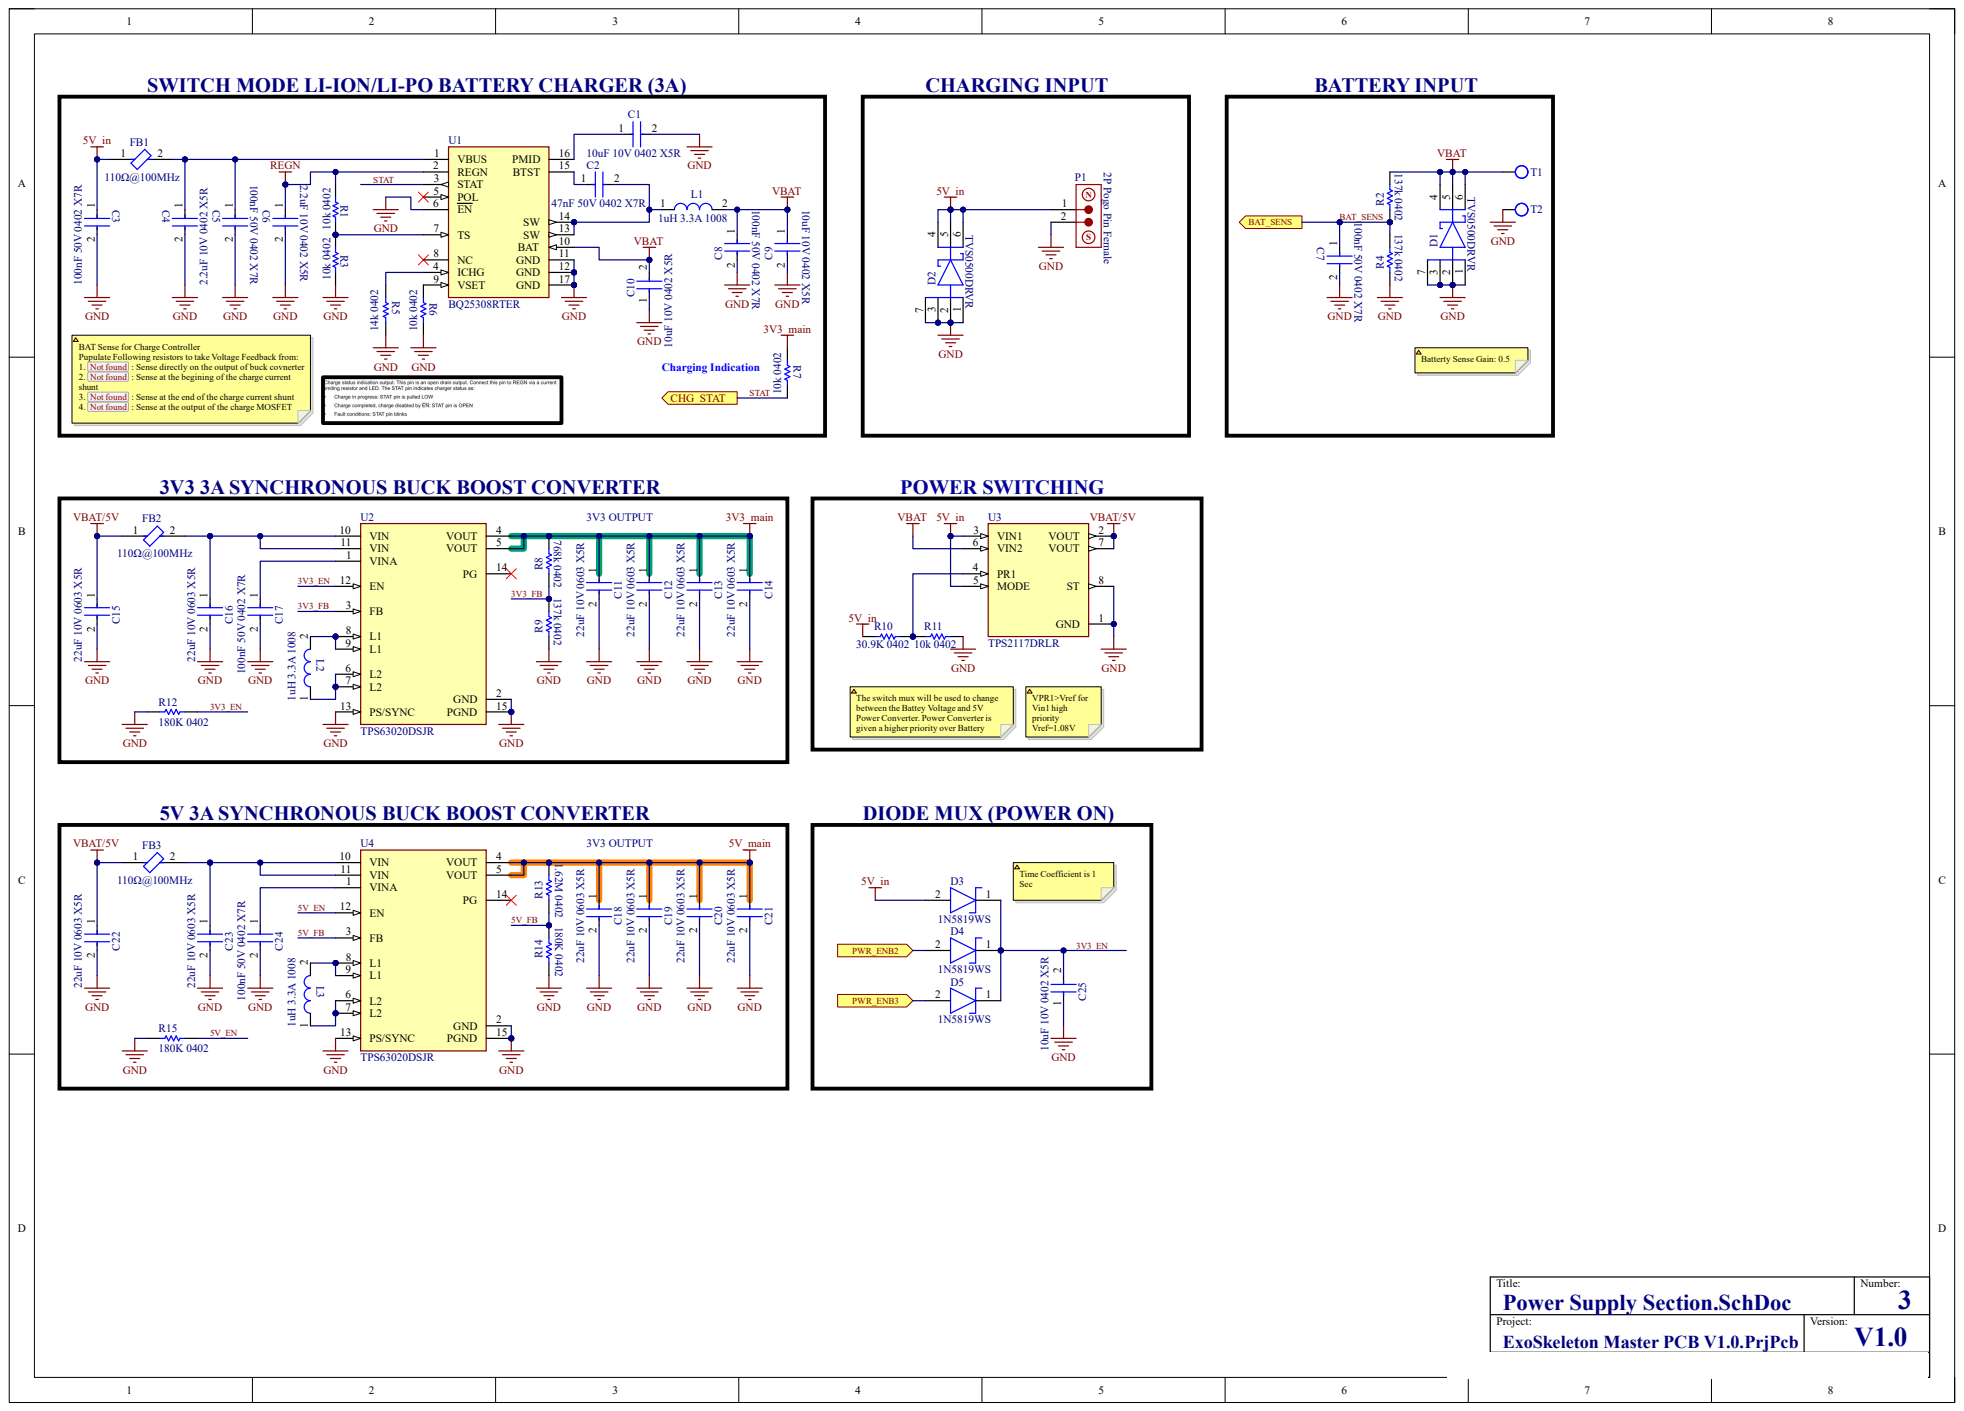
[picture p74: page 1]

BAT Sense for Charge Controller
Pupulate Following resistors to take Voltage Feedback from:
1. Not found : Sense directly on the output of buck covnerter
2. Not found : Sense at the begining of the charge current
shunt
3. Not found : Sense at the end of the charge current shunt
4. Not found : Sense at the output of the charge MOSFET

3V3 3A SYNCHRONOUS BUCK BOOST CONVERTER

The switch mux will be used to change
between the Battey Voltage and 5V
Power Converter. Power Converter is
given a higher priority over Battery

5V 3A SYNCHRONOUS BUCK BOOST CONVERTER

DIODE MUX (POWER ON)

Title: Power Supply Section.SchDoc | Number: 3
Project: ExoSkeleton Master PCB V1.0.PrjPcb | Version: V1.0
Date: | Designed by: 23/4/2024 PRANAY SHARMA

11

22

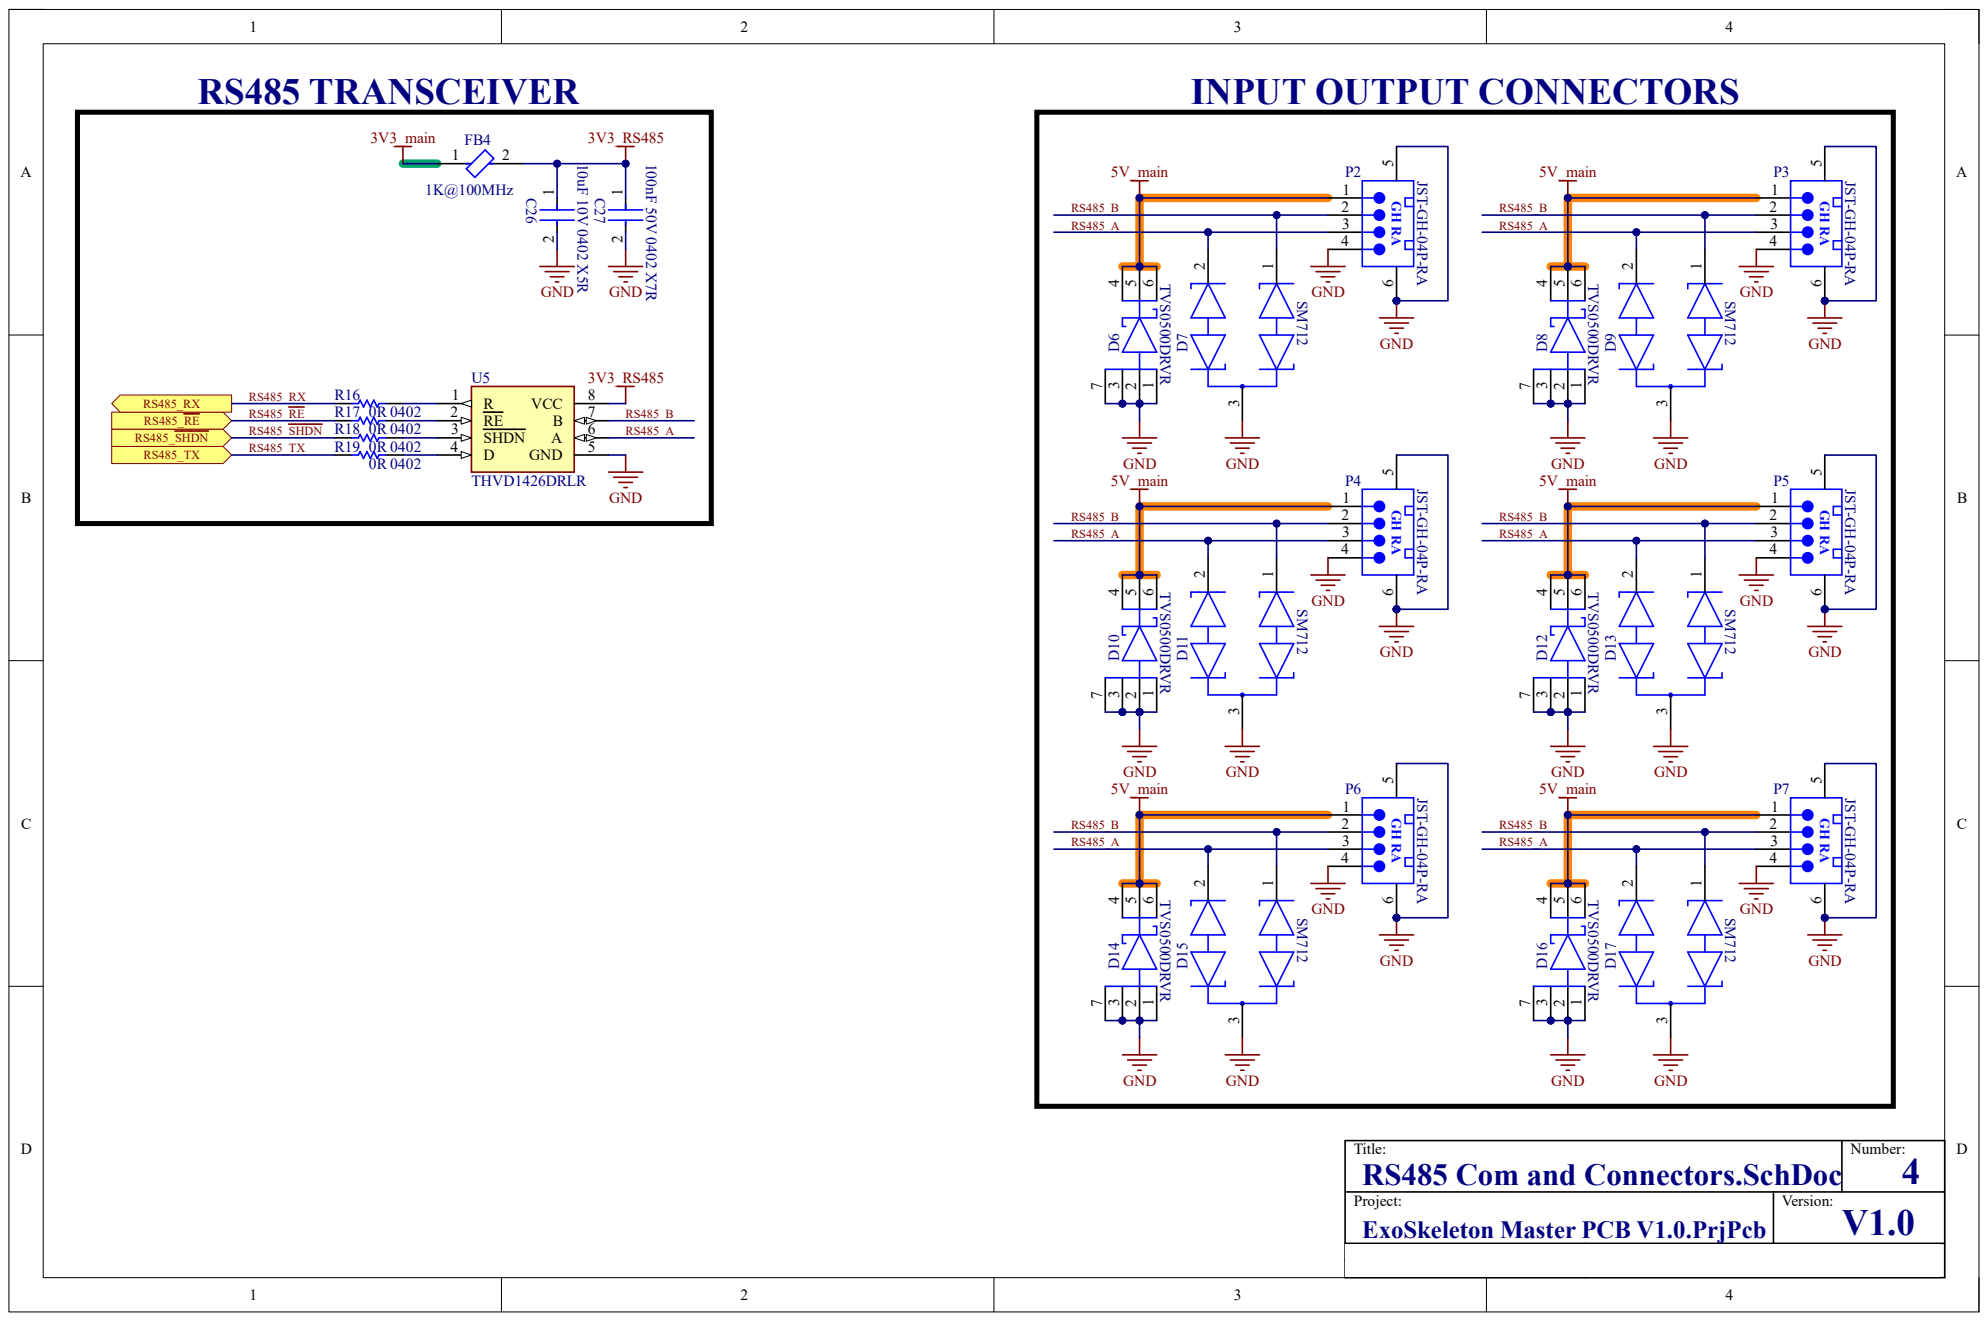
[picture p75: page 2]

Title: RS485 Com and Connectors.SchDoc | Number: 4
Project: ExoSkeleton Master PCB V1.0.PrjPcb | Version: V1.0

Date: | Designed by: 01/02/2025

A A

## 3V3_BNO

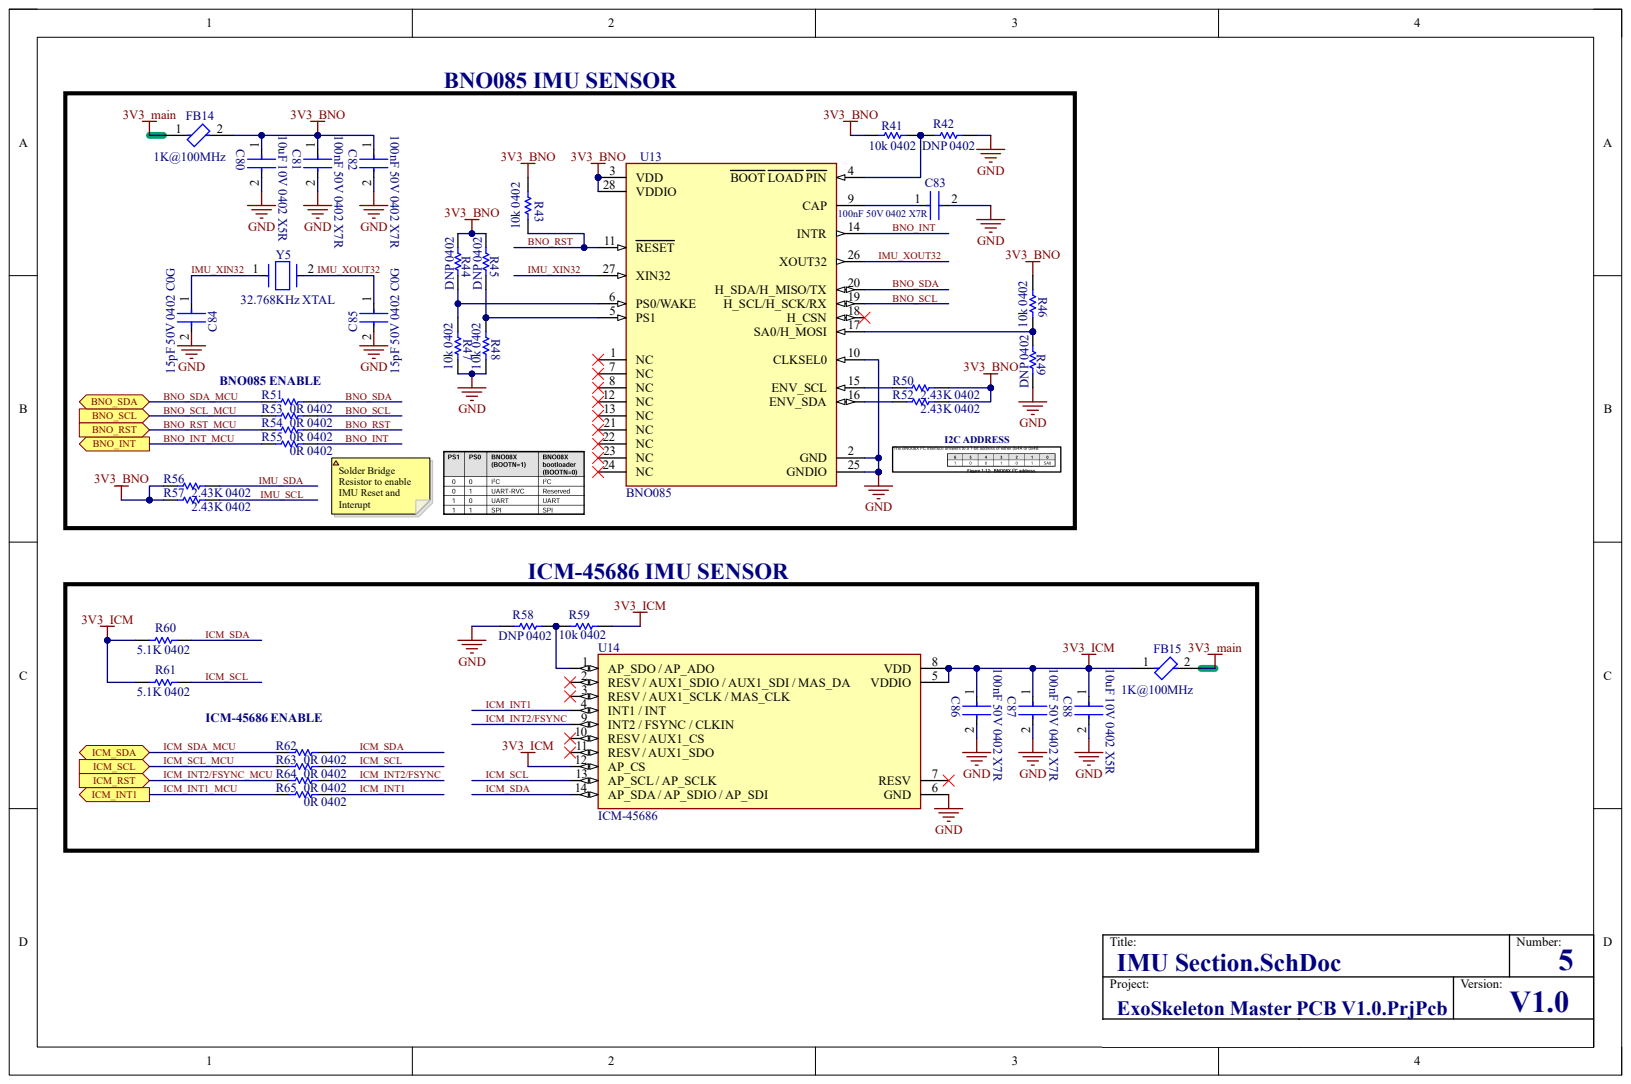
[picture p76: page 3]

Title: IMU Section.SchDoc | Number: 5
Project: ExoSkeleton Master PCB V1.0.PrjPcb | Version: V1.0

Date: | Designed by: 15/7/2024

A A

# MICRO SD CARD SLOT

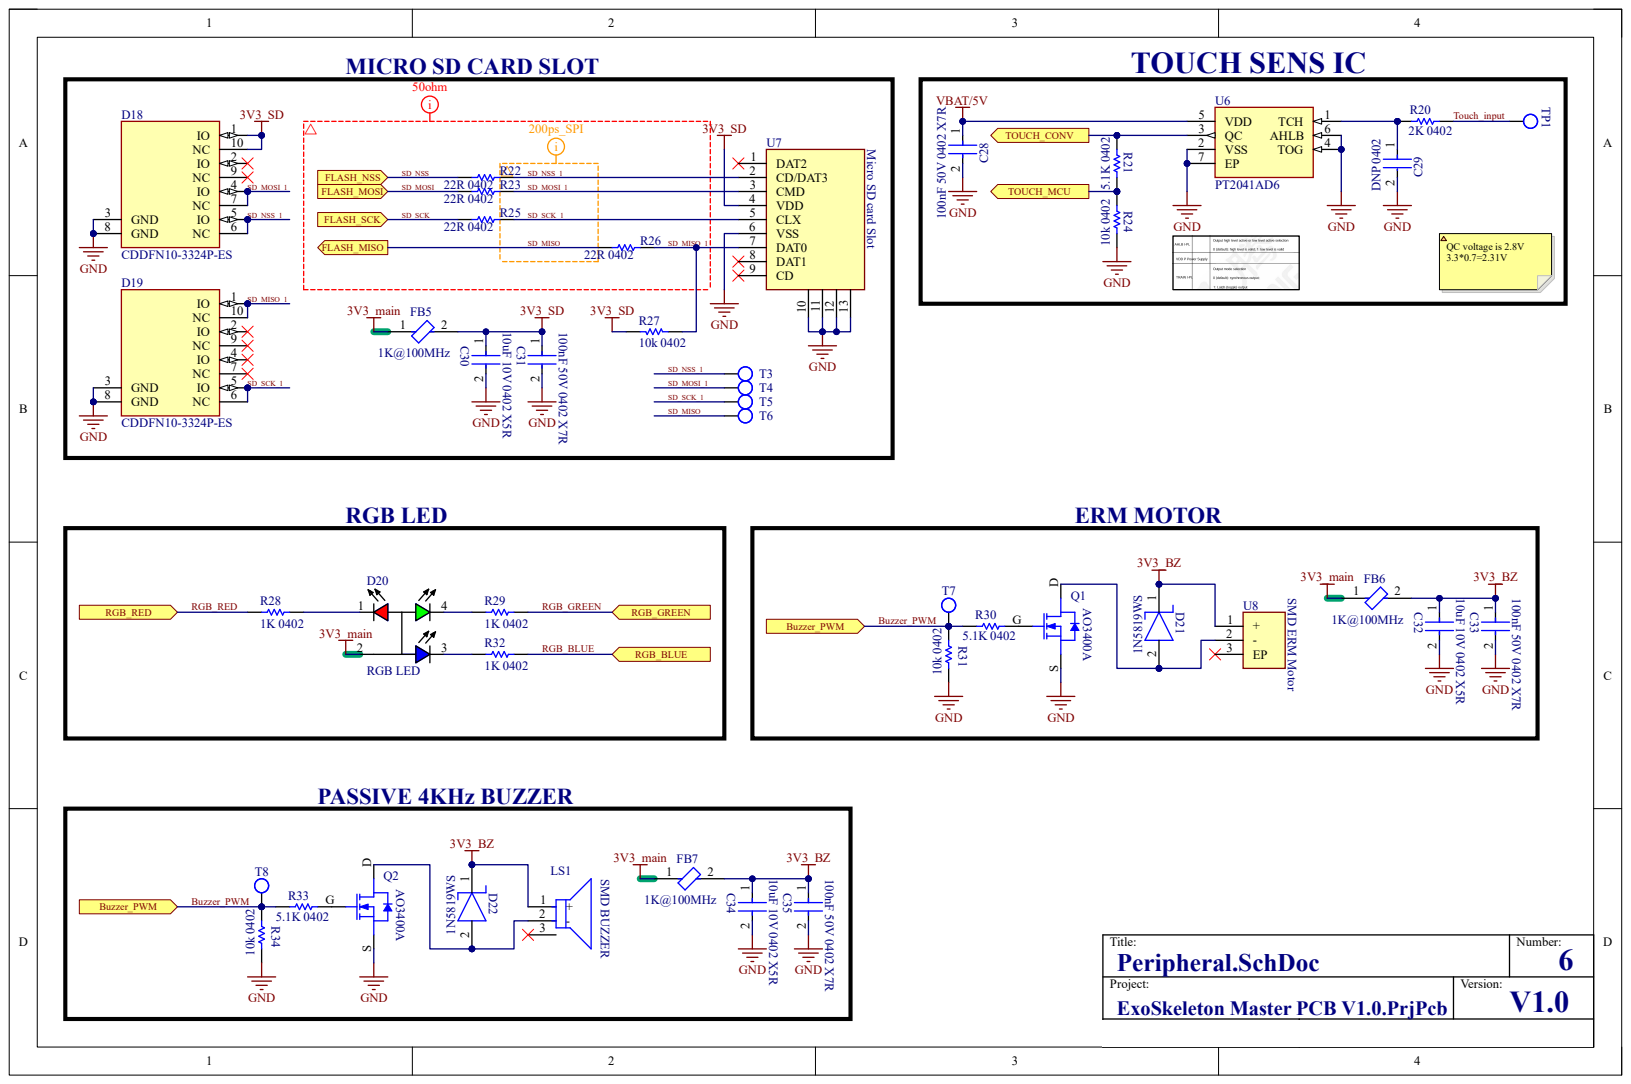
[picture p77: page 4]

Title: Peripheral.SchDoc | Number: 6
Project: ExoSkeleton Master PCB V1.0.PrjPcb | Version: V1.0

Date: | Designed by: 01/02/2025

# GND 100pF ⁵⁰V ⁰⁴⁰² C⁰G

# STM32WB55 POWER SUPPLY

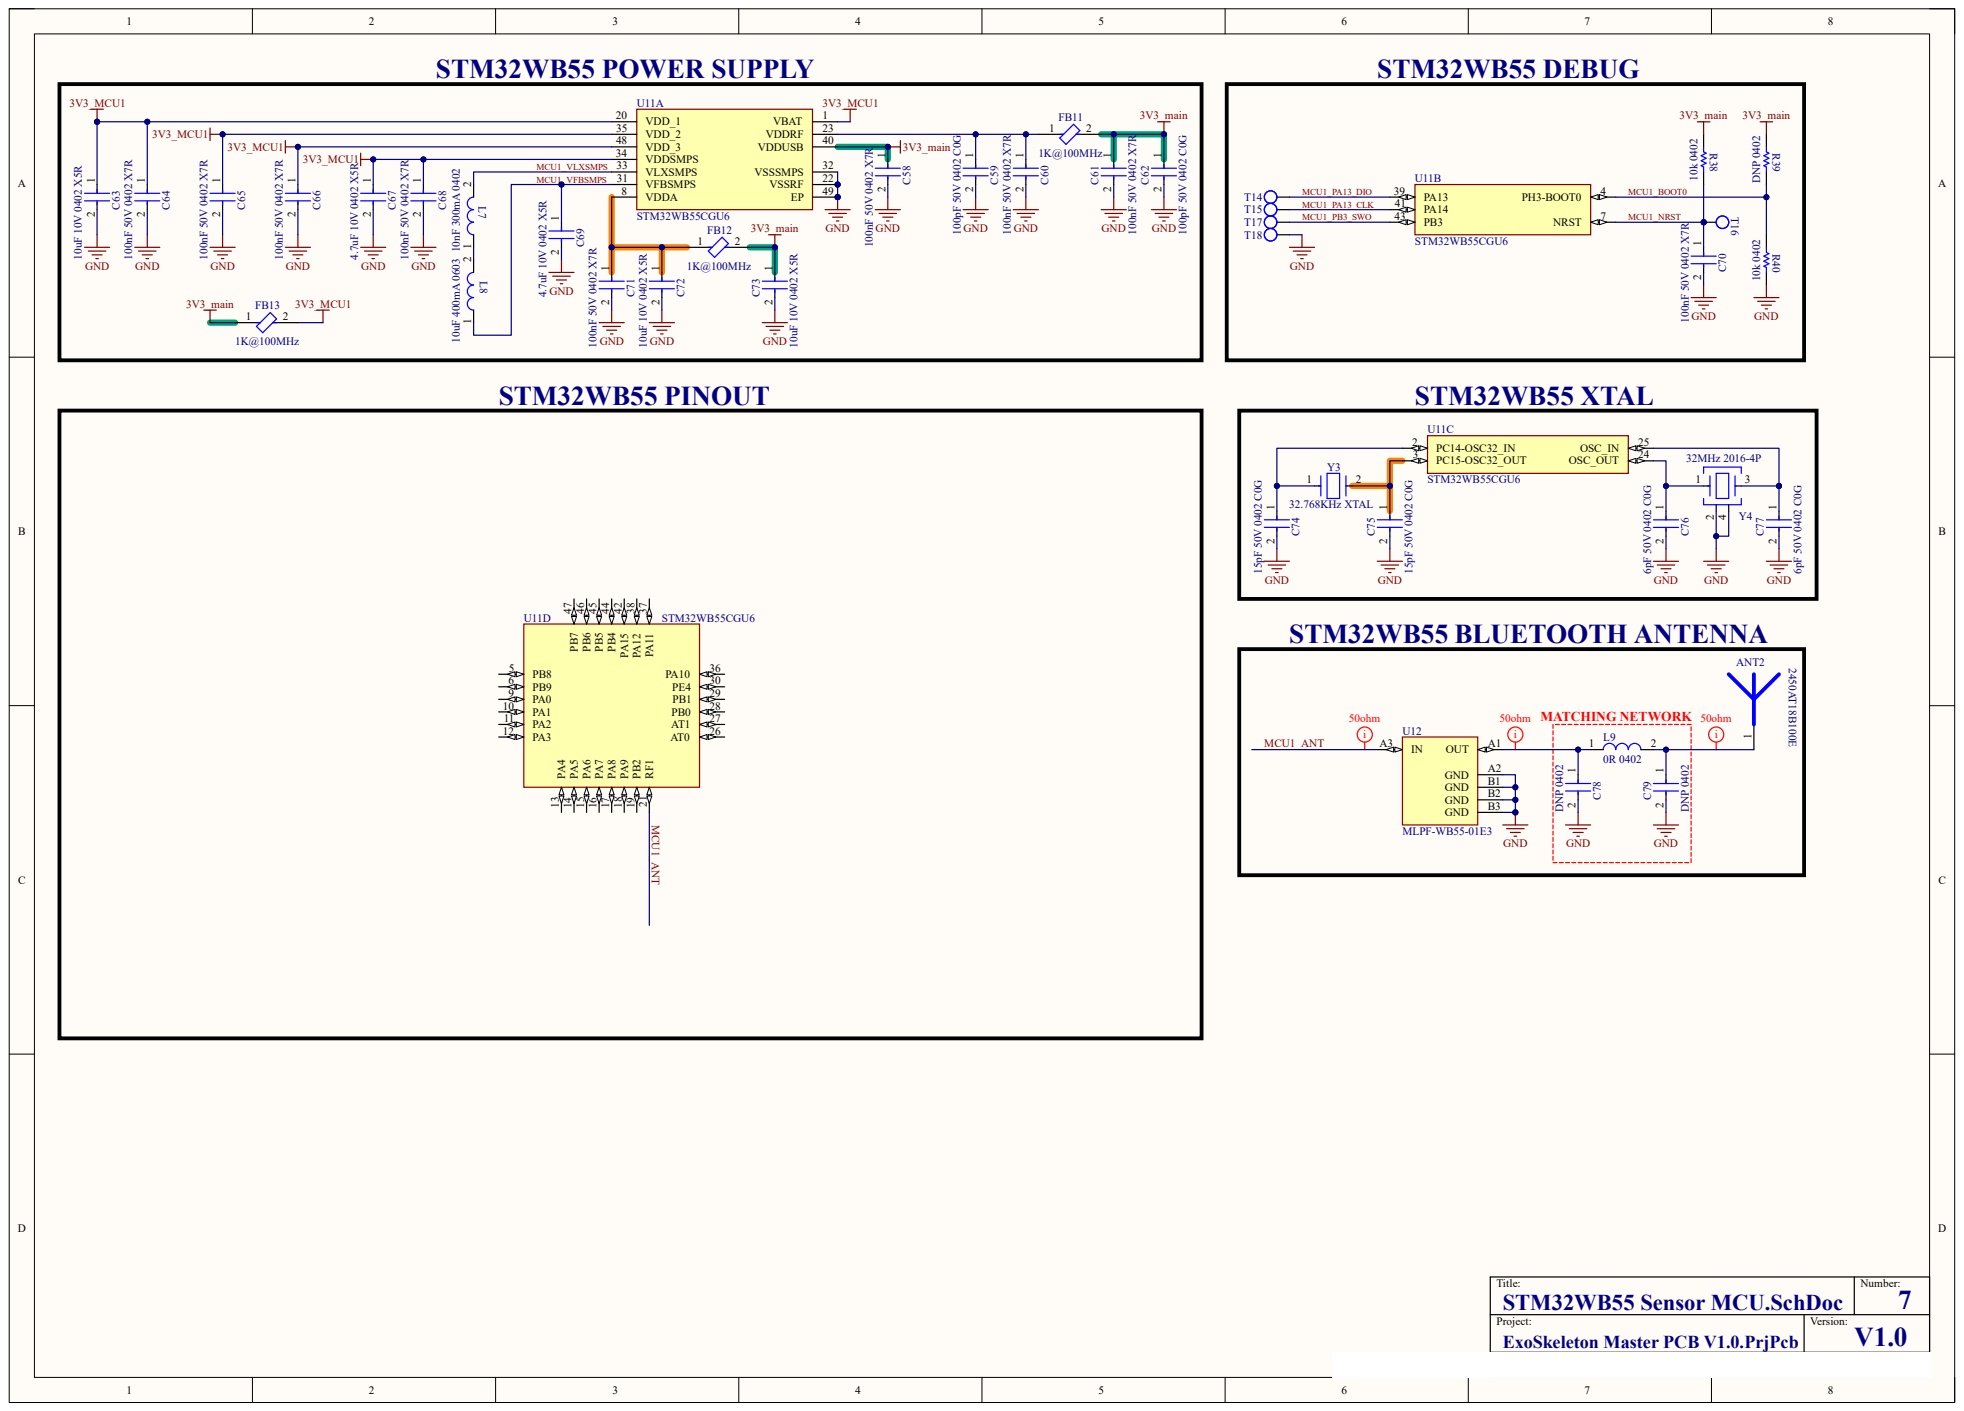
[picture p78: page 5]

# GND 100pF ⁵⁰V ⁰⁴⁰² C⁰G

# STM32WB55 POWER SUPPLY

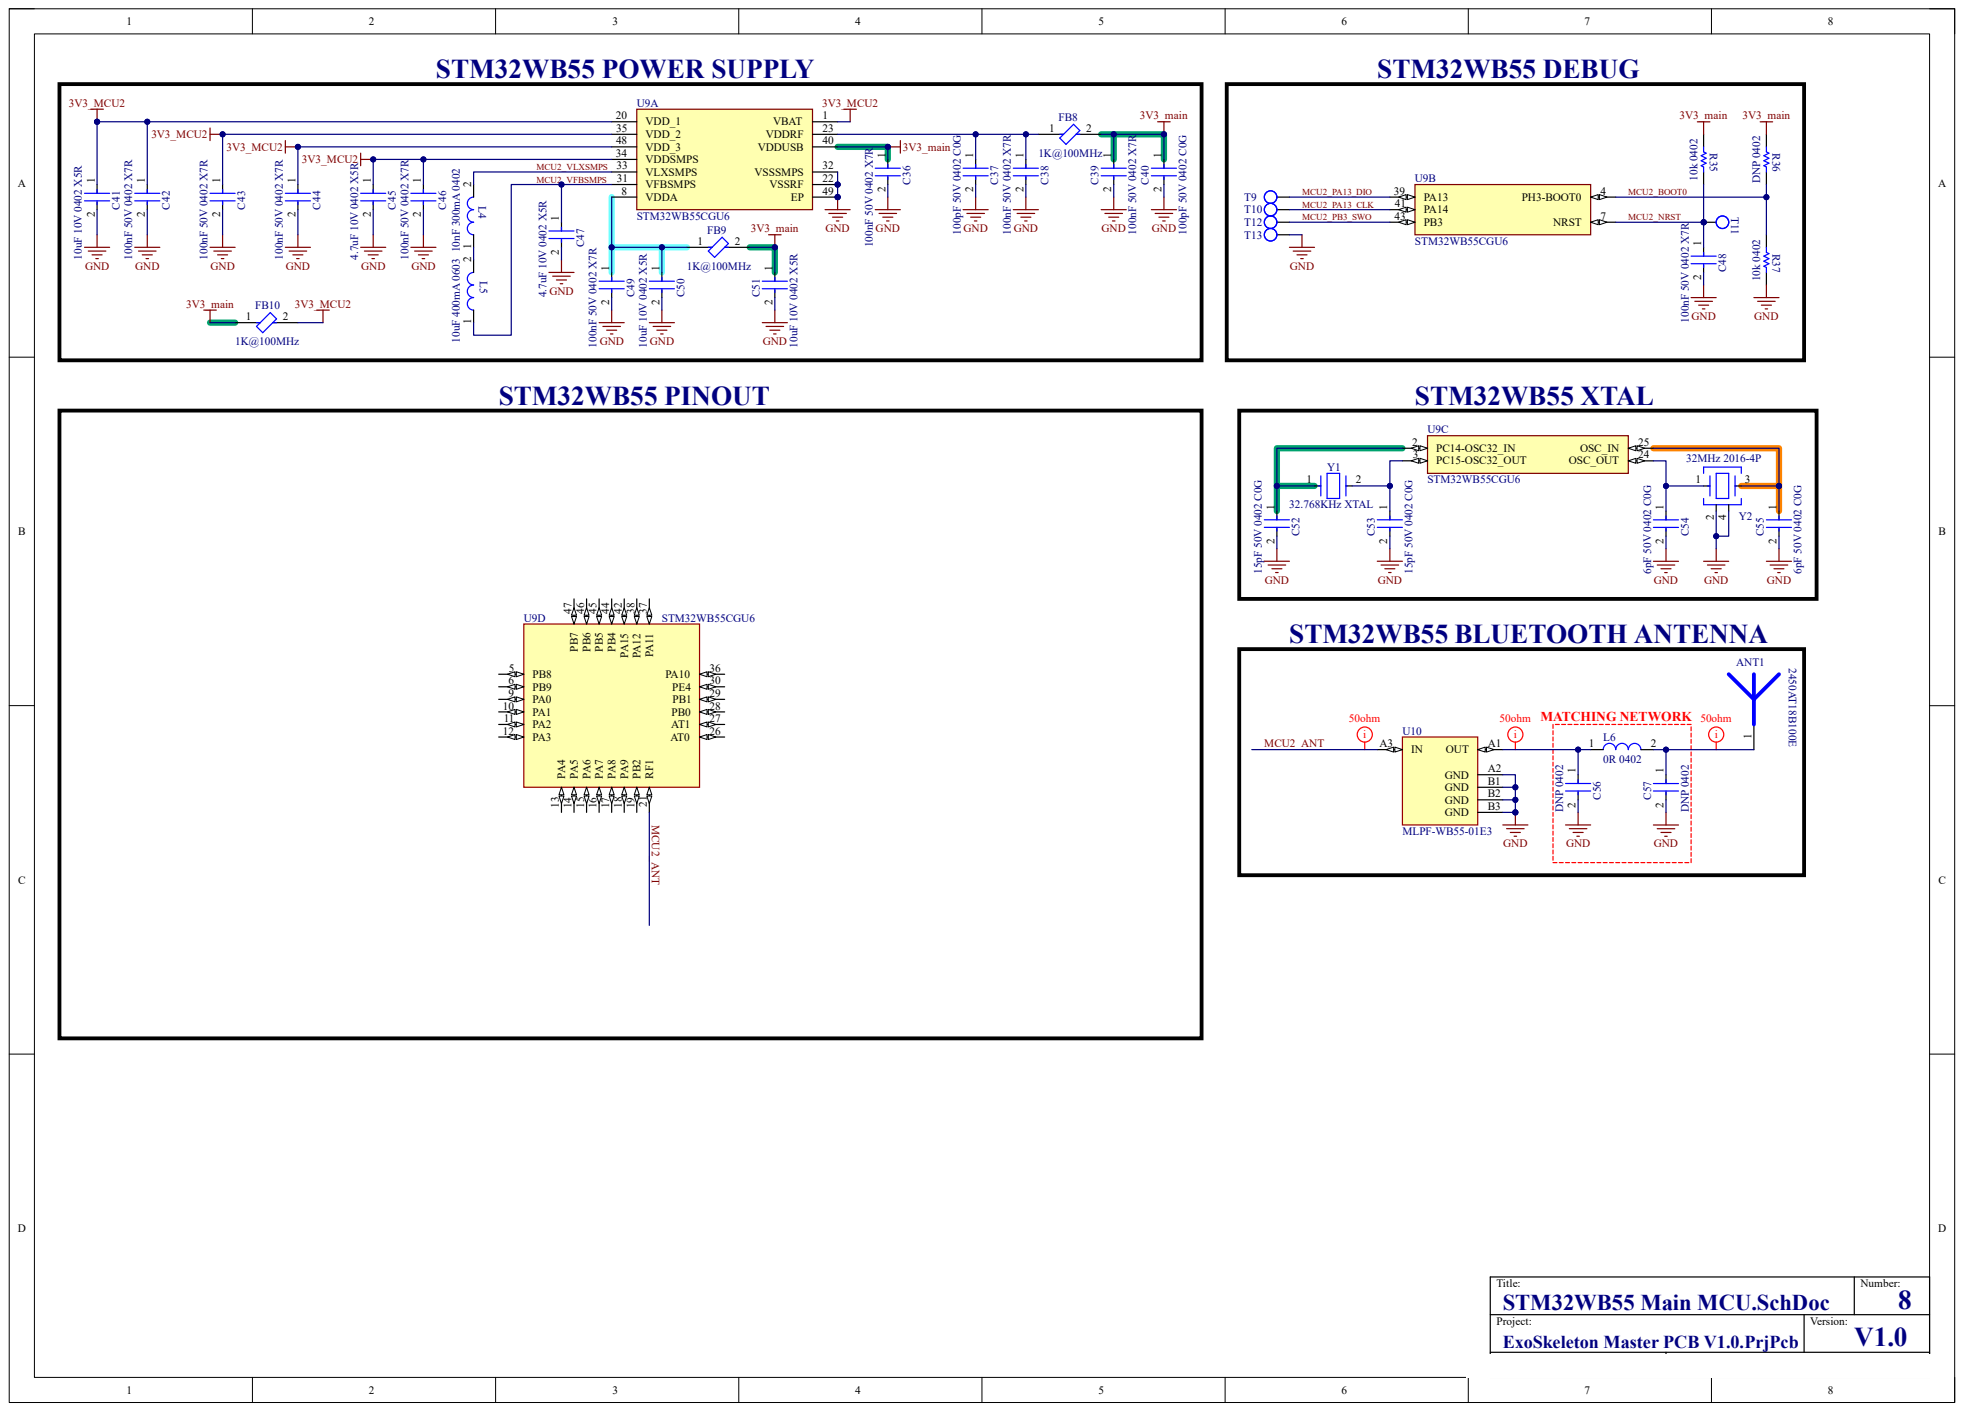
[picture p79: page 6]
