machadevrepos/Vantare_Vantage_Suit/Docs/Files from Client/Exo-Skeleton Sensor Node PCB Schematics Release 1_1.22.26.pdf

## LINEAR LI-ION/LI-PO BATTERY CHARGER (500mA)

CHARGING INPUT | BATTERY INPUT R⁴ | 137k 0402

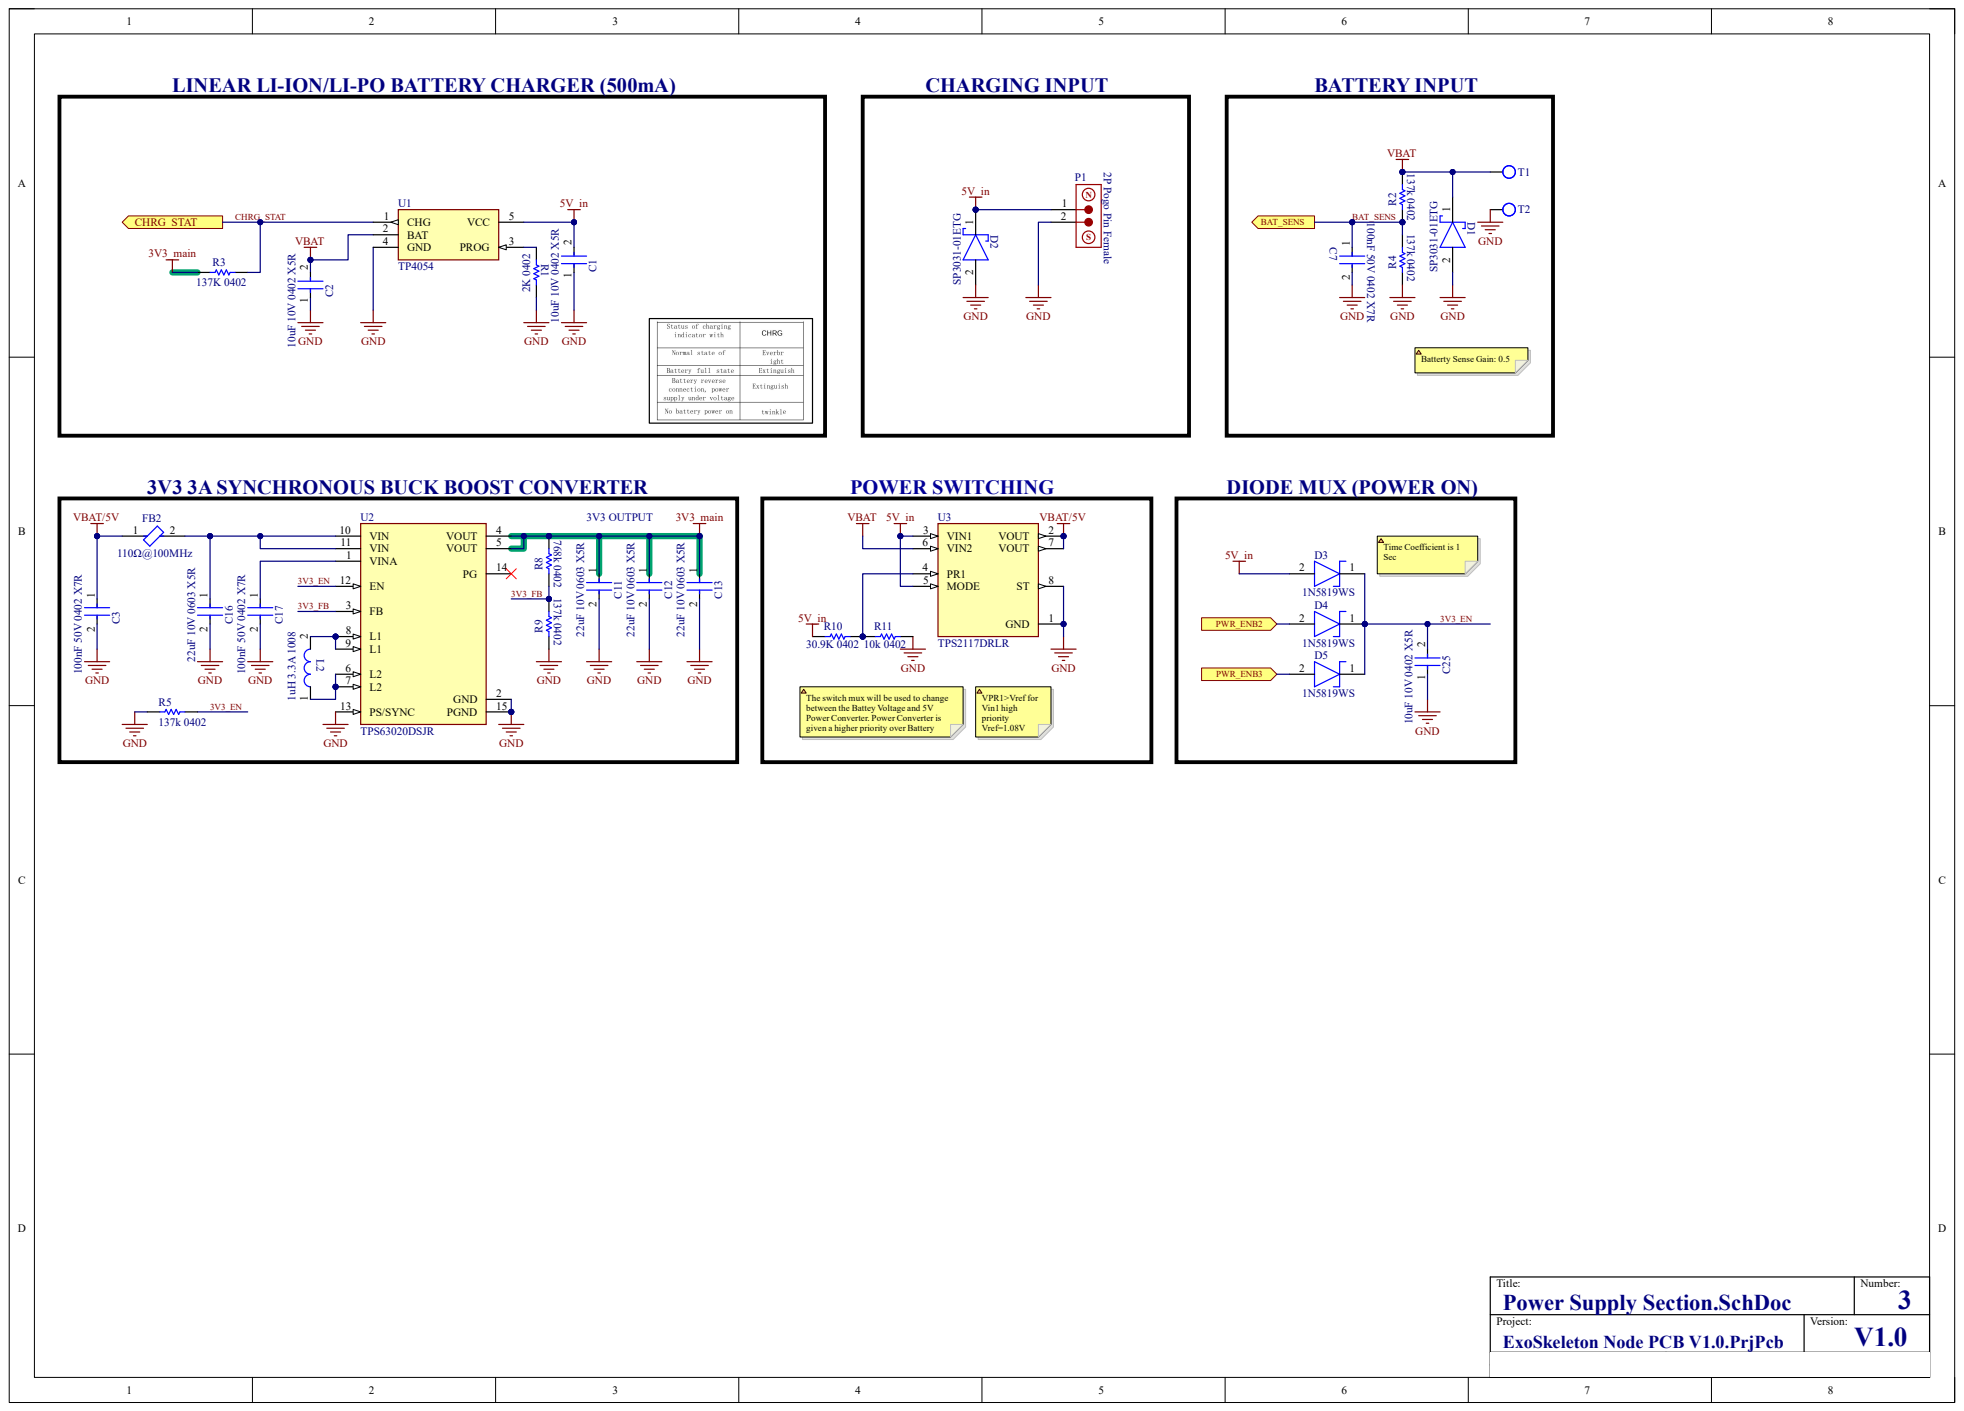
[picture p80: page 1]

3V3 3A SYNCHRONOUS BUCK BOOST CONVERTER

DIODE MUX (POWER ON)

The switch mux will be used to change
between the Battey Voltage and 5V
Power Converter. Power Converter is
given a higher priority over Battery

Title: Power Supply Section.SchDoc | Number: 3
Project: ExoSkeleton Node PCB V1.0.PrjPcb | Version: V1.0
Date: | Designed by: 23/4/2024 PRANAY SHARMA

# RS485 TRANSCEIVER

3 5 6

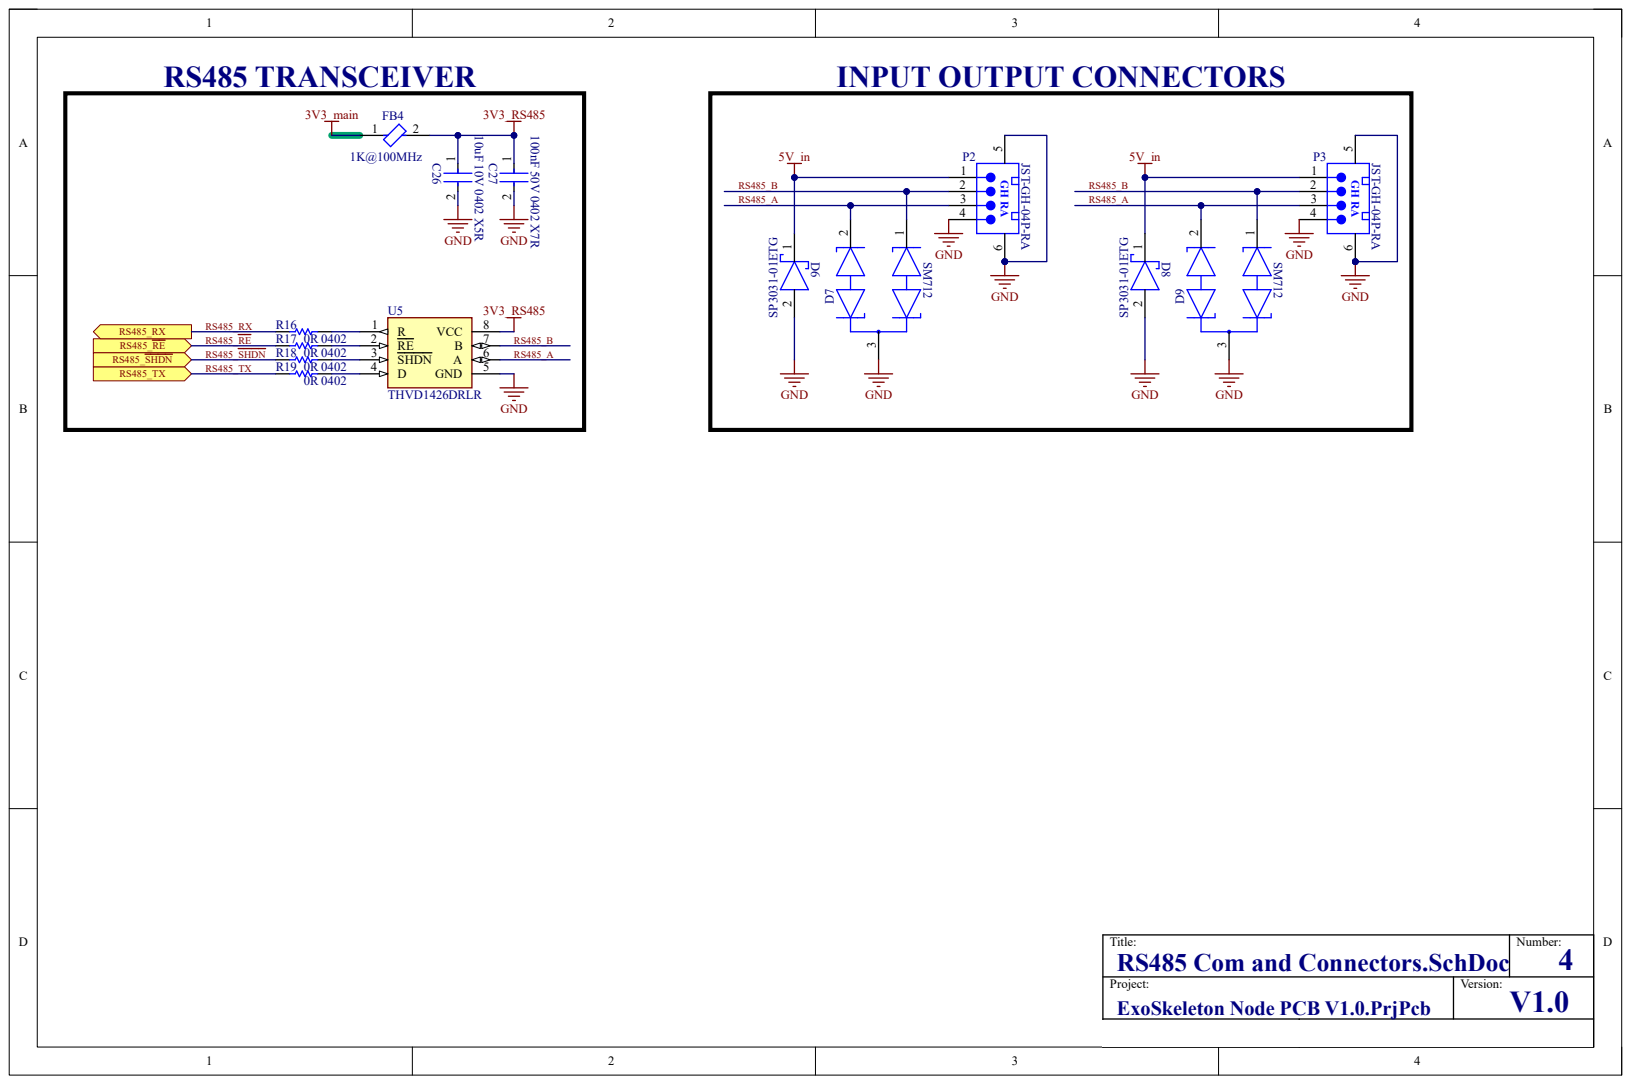
[picture p81: page 2]

Title: RS485 Com and Connectors.SchDoc | Number: 4
Project: ExoSkeleton Node PCB V1.0.PrjPcb | Version: V1.0

Date: | Designed by: 01/02/2025

# BNO085 IMU SENSOR

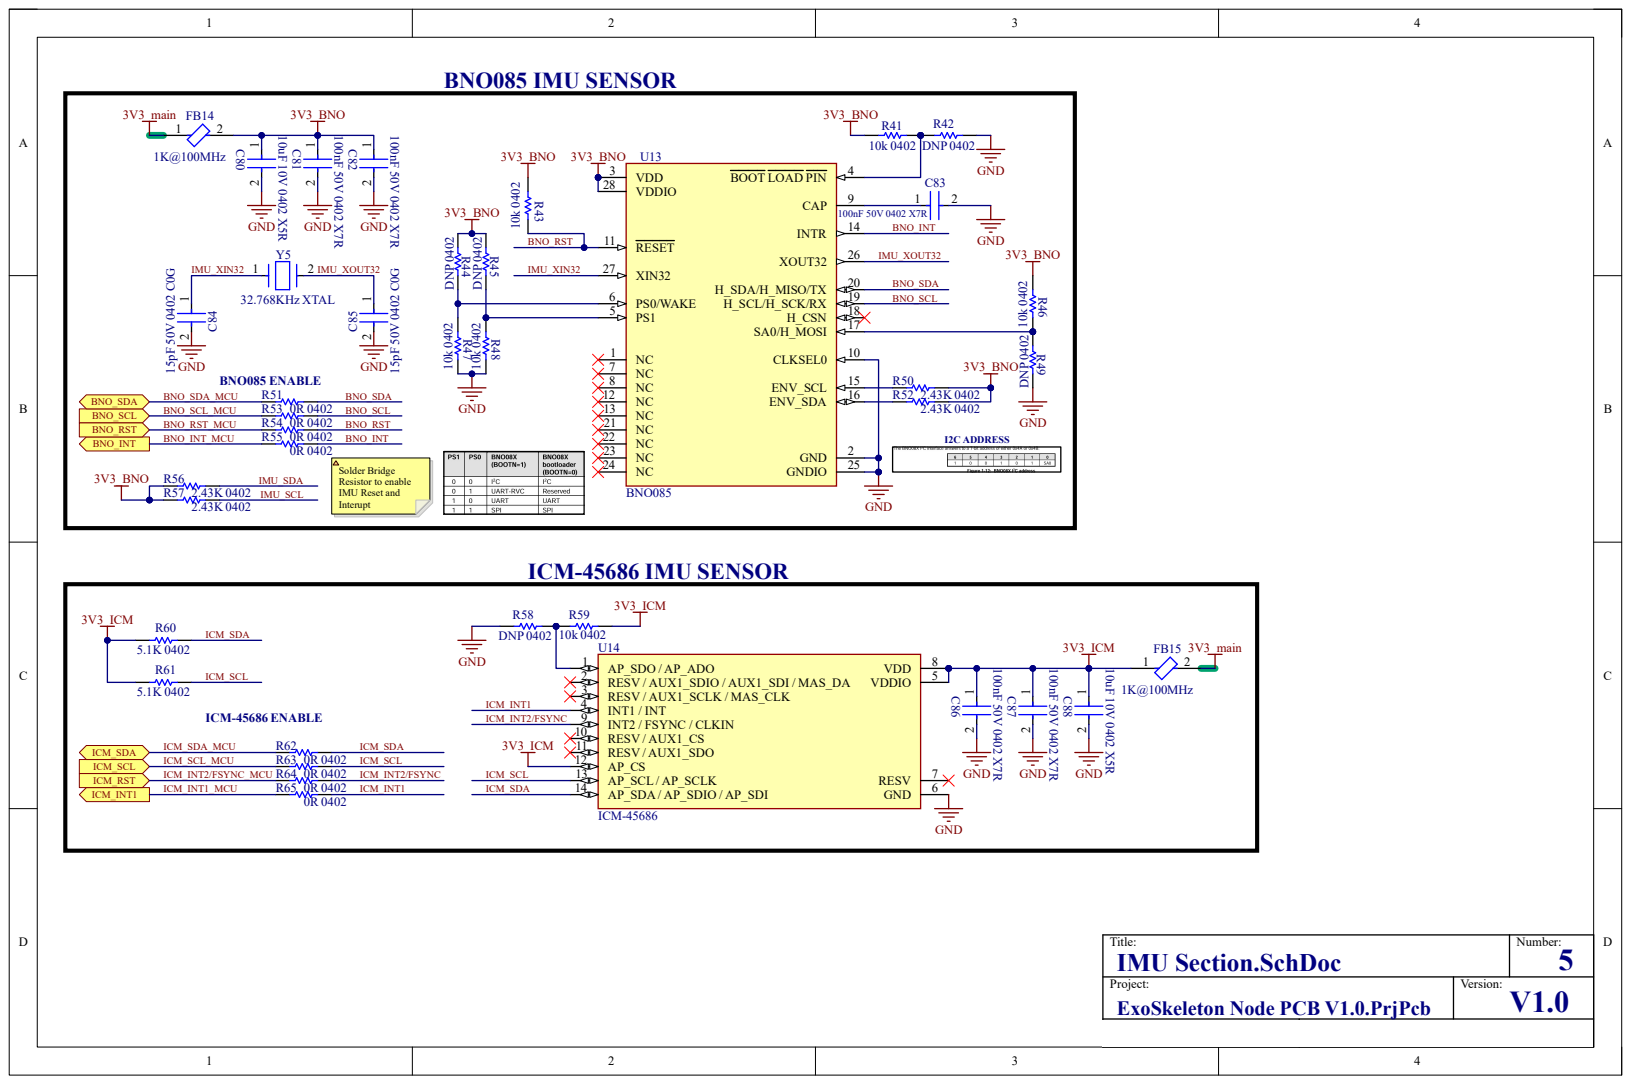
[picture p82: page 3]

Title: IMU Section.SchDoc | Number: 5
Project: ExoSkeleton Node PCB V1.0.PrjPcb | Version: V1.0

Date: | Designed by: 15/7/2024

# TOUCH SENS IC

# 256MB SPI FLASH

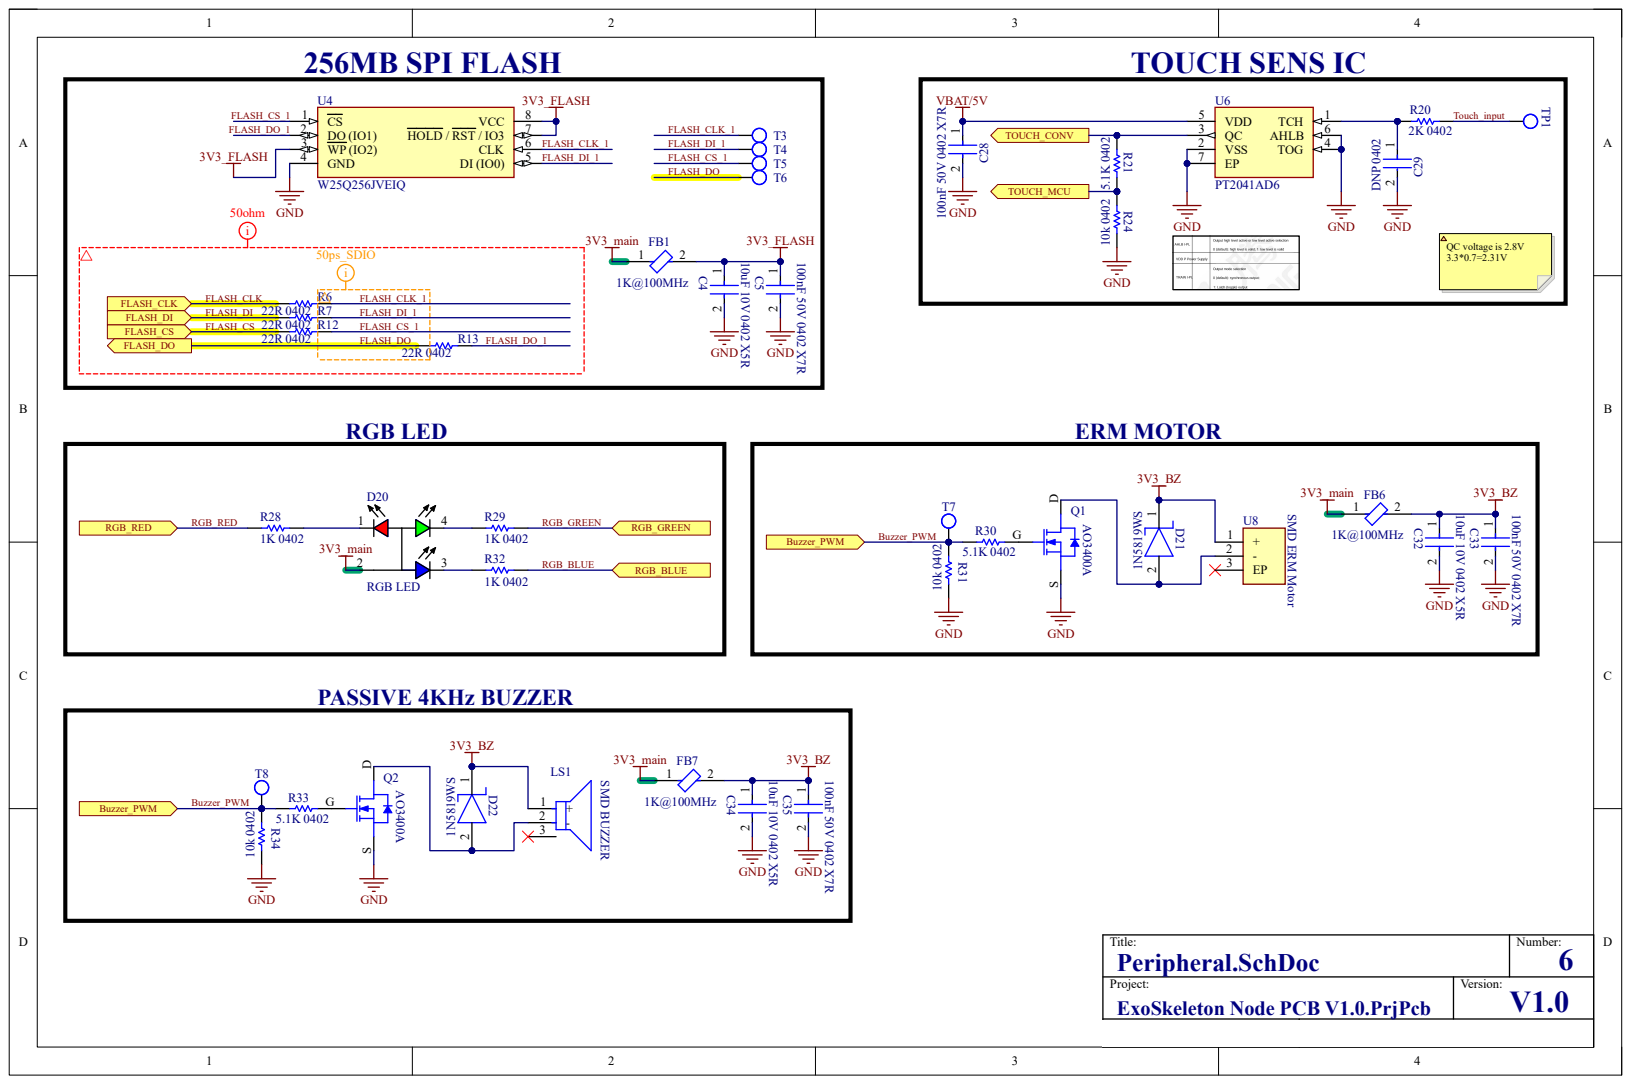
[picture p83: page 4]

Title: Peripheral.SchDoc | Number: 6
Project: ExoSkeleton Node PCB V1.0.PrjPcb | Version: V1.0

Date: | Designed by: 01/02/2025

# GND 100pF ⁵⁰V ⁰⁴⁰² C⁰G

# STM32WB55 POWER SUPPLY

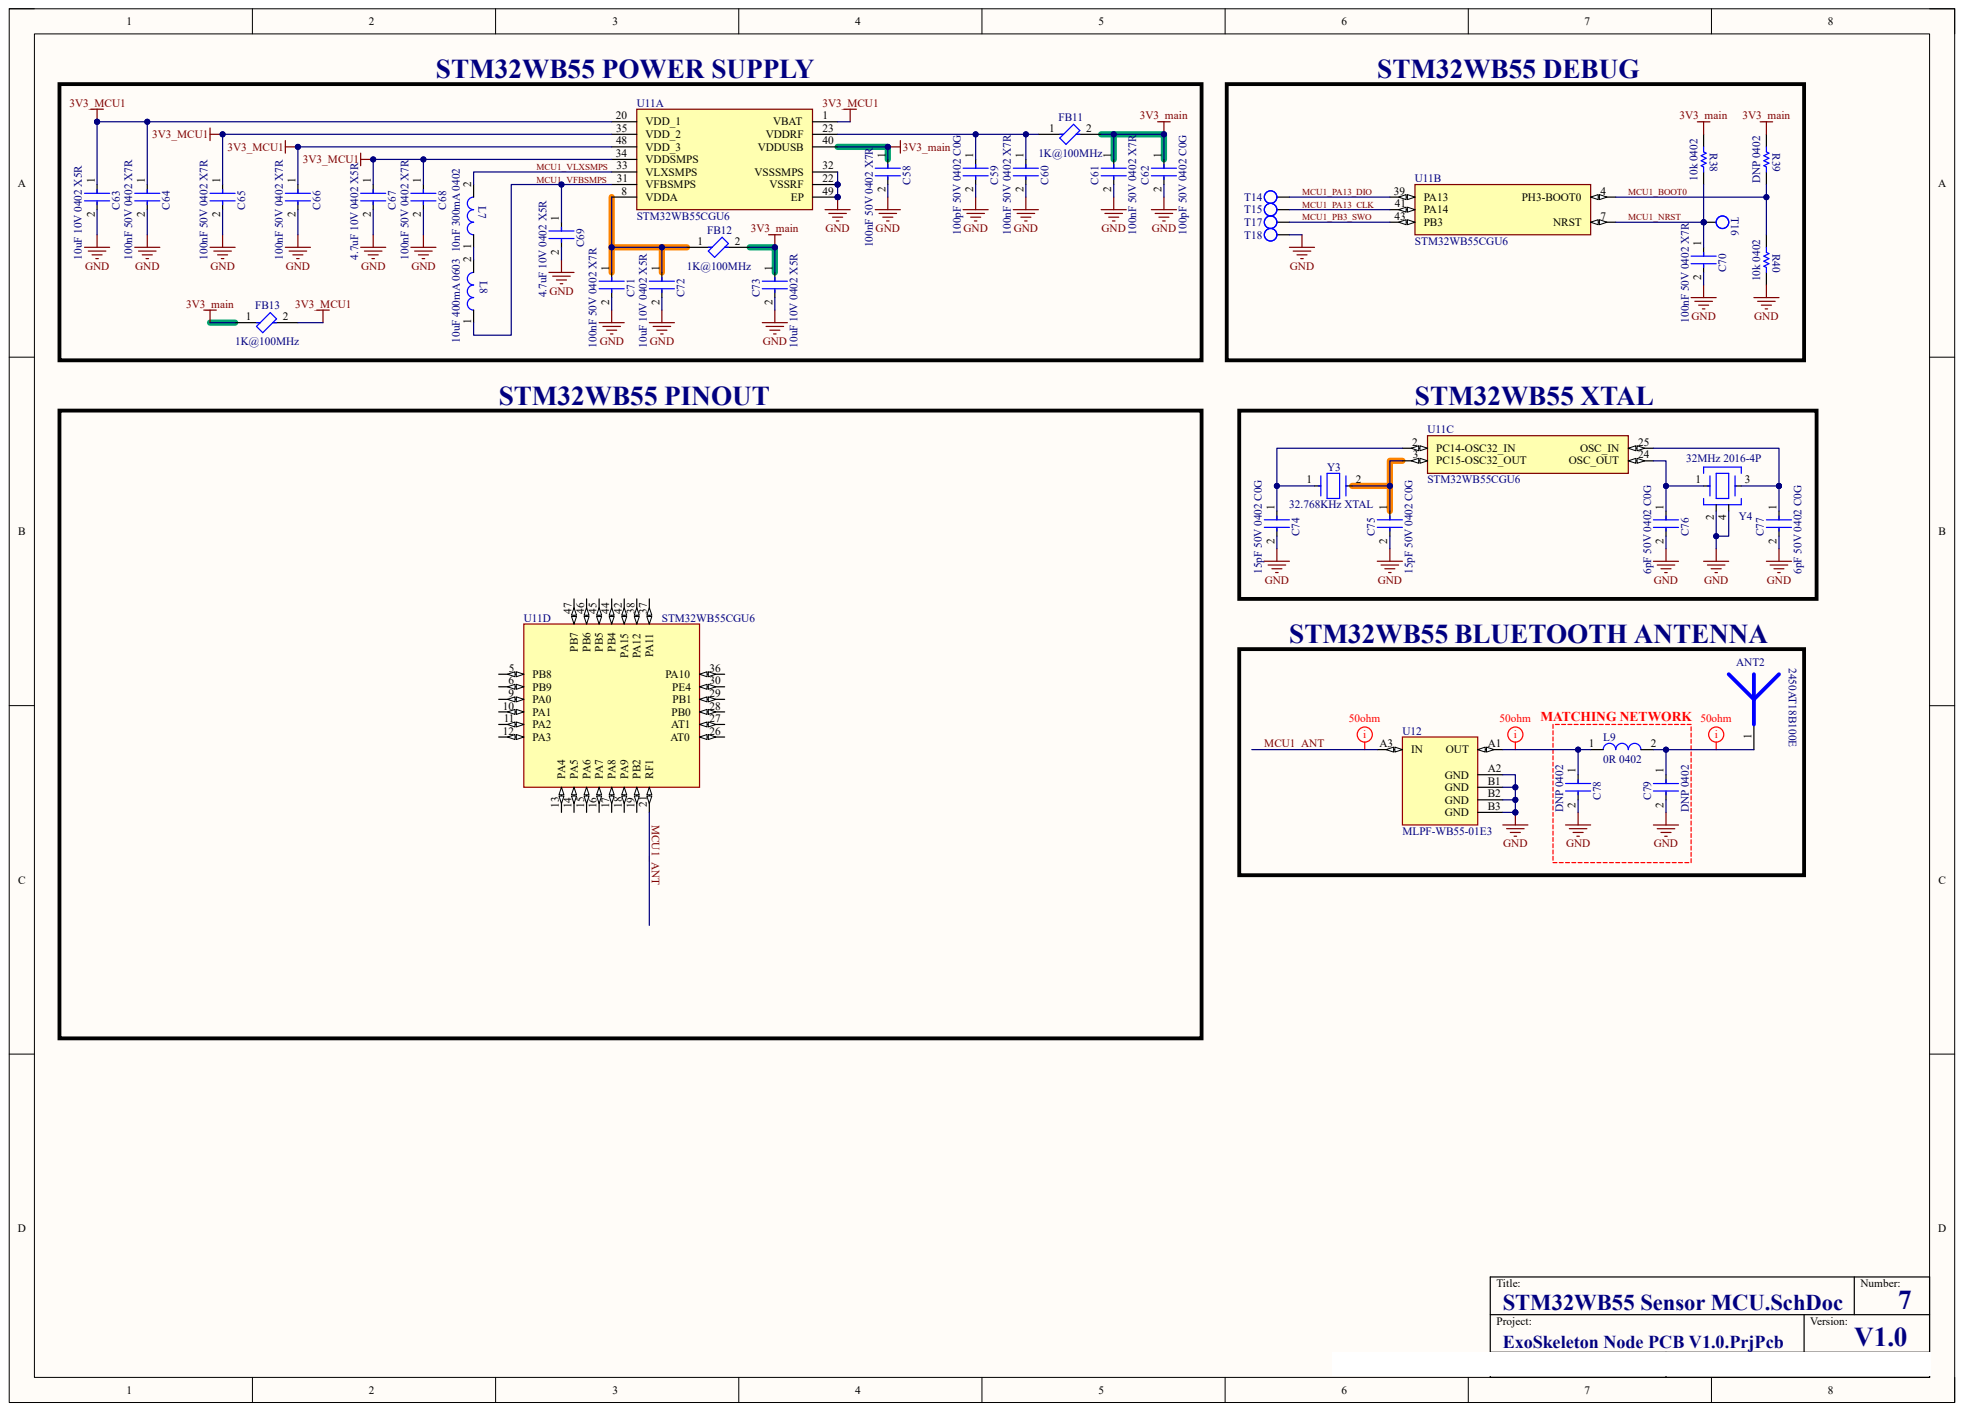
[picture p84: page 5]

Title: STM32WB55 Sensor MCU.SchDoc | Number: 7
Project: ExoSkeleton Node PCB V1.0.PrjPcb | Version: V1.0

Date: | Designed by: 23/03/2025
