machadevrepos/Vantare_Vantage_Suit/Docs/Files from Client/MASTER Assembly DI3.pdf

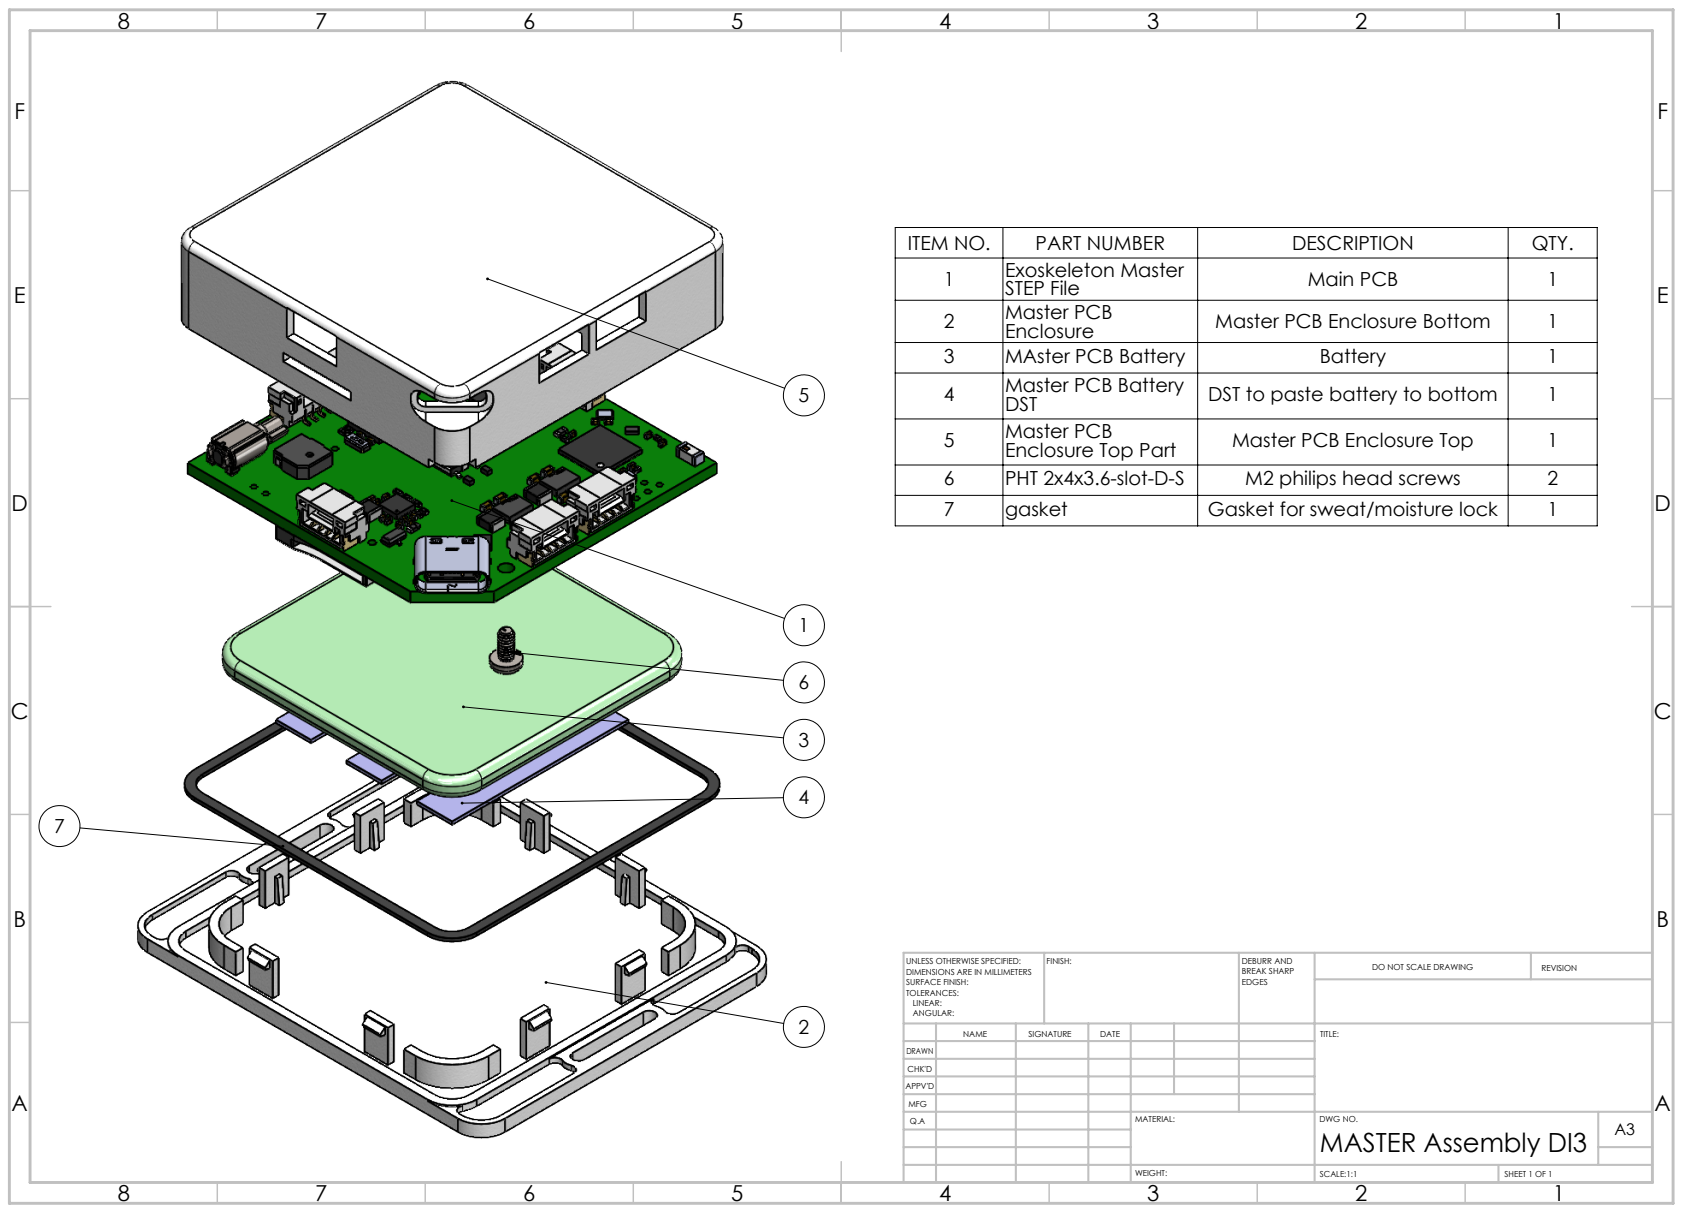
[picture p85: page 1]
FINISH:; DEBURR AND; BREAK SHARP; DO NOT SCALE DRAWING; REVISION; SCALE:1:1; SHEET 1 OF 1

ITEM NO. | PART NUMBER | DESCRIPTION | QTY.
1 | Exoskeleton Master STEP File | Main PCB | 1
2 | Master PCB Enclosure | Master PCB Enclosure Bottom | 1
3 | MAster PCB Battery | Battery | 1
4 | Master PCB Battery DST | DST to paste battery to bottom | 1
5 | Master PCB Enclosure Top Part | Master PCB Enclosure Top | 1
6 | PHT 2x4x3.6-slot-D-S | M2 philips head screws | 2
7 | gasket | Gasket for sweat/moisture lock | 1

UNLESS OTHERWISE SPECIFIED:
DIMENSIONS ARE IN MILLIMETERS
SURFACE FINISH:
TOLERANCES:
LINEAR:
ANGULAR:

NAME | SIGNATURE | DATE | | | | TITLE:

DRAWN
CHK'D
APPV'D
MFG
Q.A | | | | MATERIAL: | DWG NO. MASTER Assembly DI3 | A3
