machadevrepos/Vantare_Vantage_Suit/Docs/Files from Client/NODE Assembly DI3.pdf

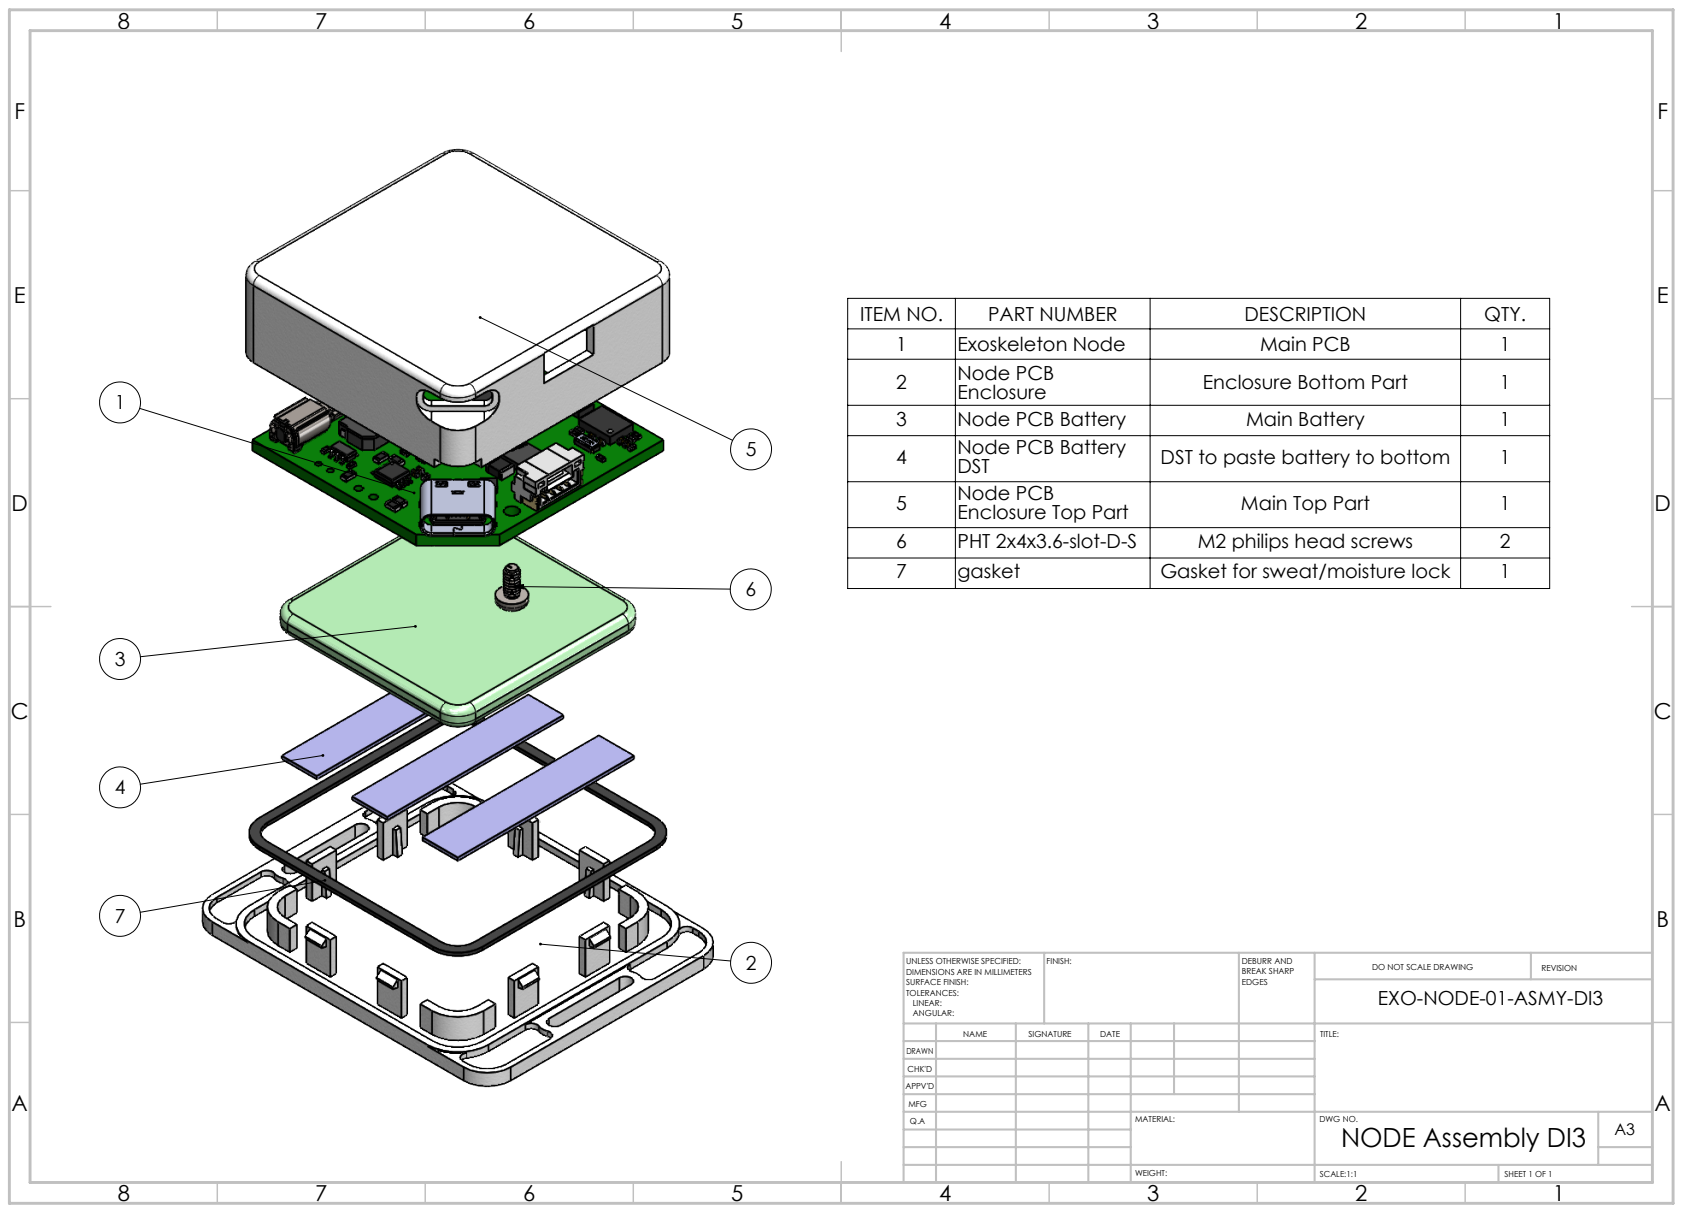
[picture p86: page 1]
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

ITEM NO. | PART NUMBER | DESCRIPTION | QTY.
1 | Exoskeleton Node | Main PCB | 1
2 | Node PCB Enclosure | Enclosure Bottom Part | 1
3 | Node PCB Battery | Main Battery | 1
4 | Node PCB Battery DST | DST to paste battery to bottom | 1
5 | Node PCB Enclosure Top Part | Main Top Part | 1
6 | PHT 2x4x3.6-slot-D-S | M2 philips head screws | 2
7 | gasket | Gasket for sweat/moisture lock | 1

UNLESS OTHERWISE SPECIFIED:
DIMENSIONS ARE IN MILLIMETERS
SURFACE FINISH:
TOLERANCES:
LINEAR:
ANGULAR:

EXO-NODE-01-ASMY-DI3

NAME | SIGNATURE | DATE | | | | TITLE:

DRAWN
CHK'D
APPV'D
MFG
Q.A | | | | MATERIAL: | DWG NO. NODE Assembly DI3 | A3
