machadevrepos/Vantare_Vantage_Suit/Docs/Files from Client/Master PCB Enclosure Bottom DI3.pdf

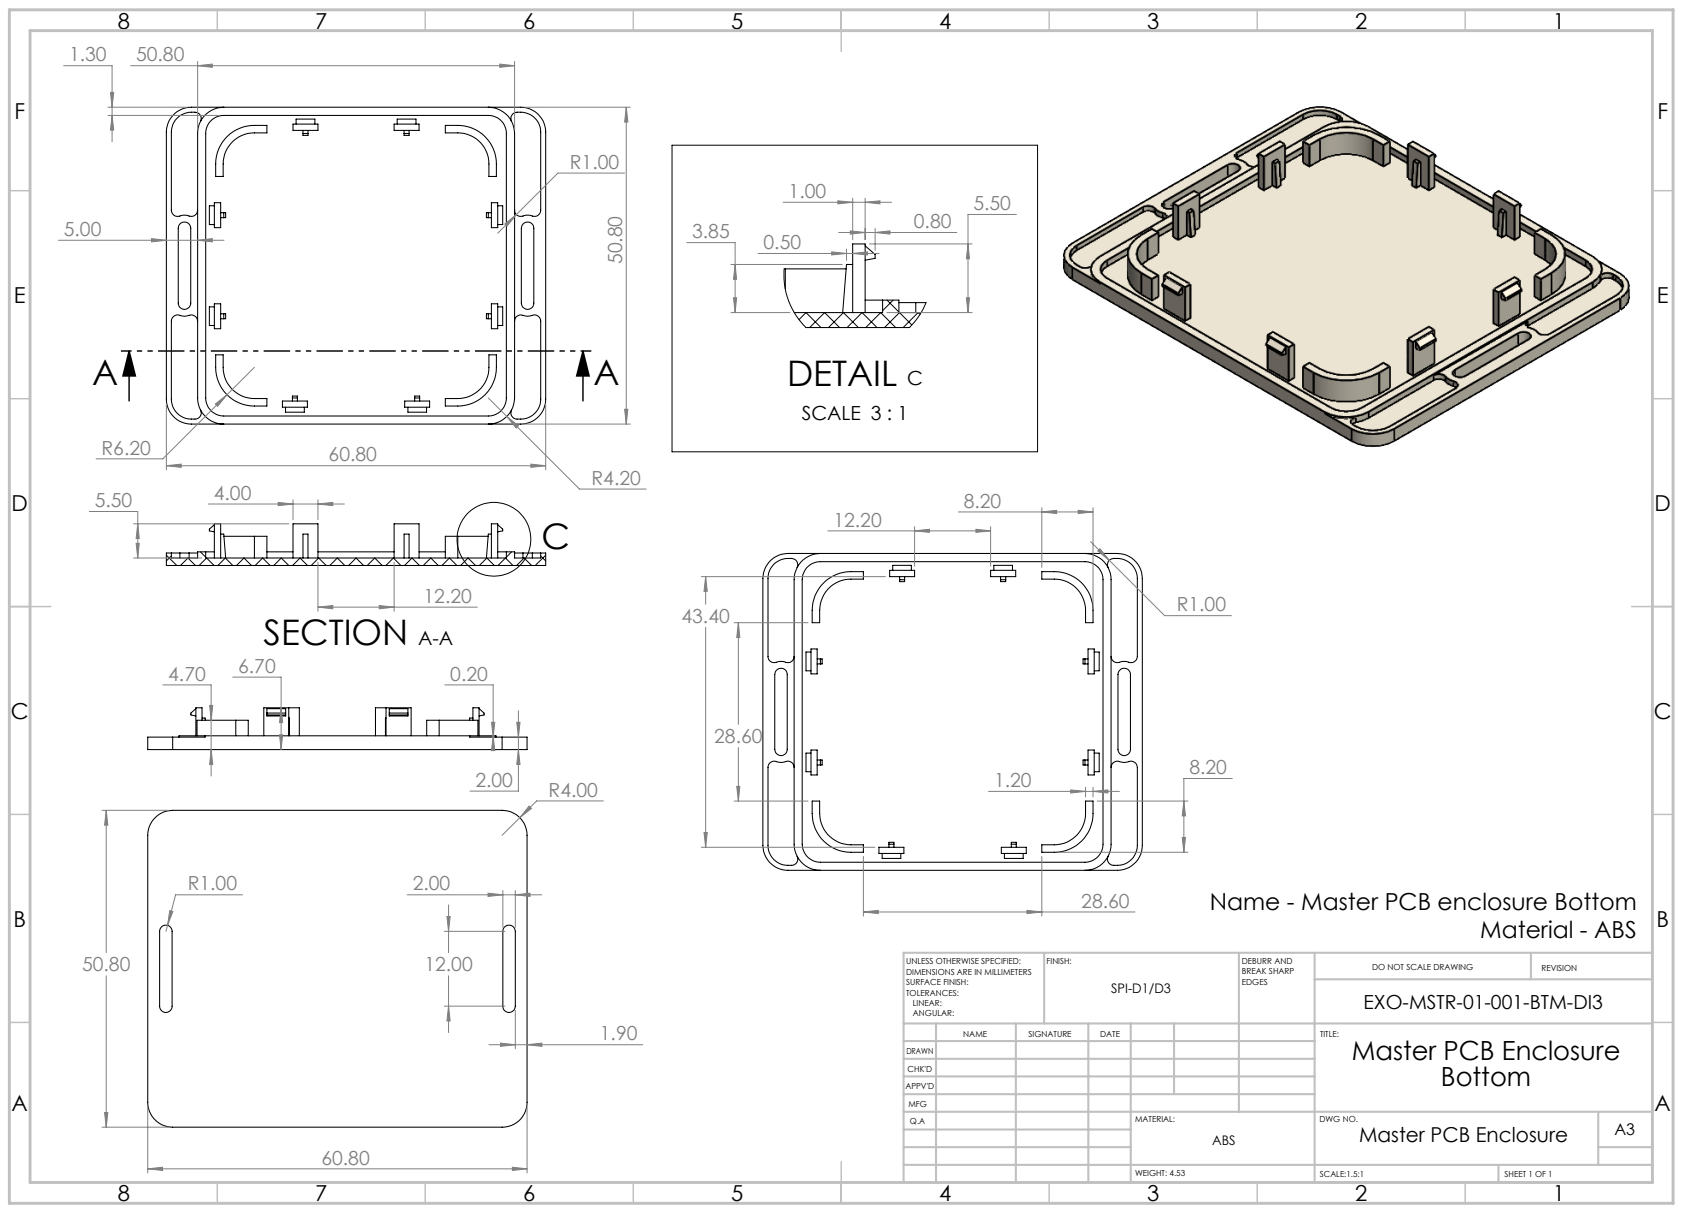
[picture p87: page 1]
SECTION A-A; DETAIL C; SCALE 3 : 1; Material - ABS; FINISH:; DEBURR AND; BREAK SHARP; DO NOT SCALE DRAWING; REVISION; SCALE:1.5:1; SHEET 1 OF 1; WEIGHT: 4.53

Name - Master PCB enclosure Bottom

UNLESS OTHERWISE SPECIFIED:
DIMENSIONS ARE IN MILLIMETERS
SURFACE FINISH:
TOLERANCES:
LINEAR:
ANGULAR:

EXO-MSTR-01-001-BTM-DI3

NAME | SIGNATURE | DATE | | | | TITLE: Master PCB Enclosure Bottom

DRAWN
CHK'D
APPV'D
MFG
Q.A | | | | MATERIAL: | DWG NO. Master PCB Enclosure | A3 ABS
