machadevrepos/Vantare_Vantage_Suit/Docs/Files from Client/Master PCB Enclosure Top Part.pdf

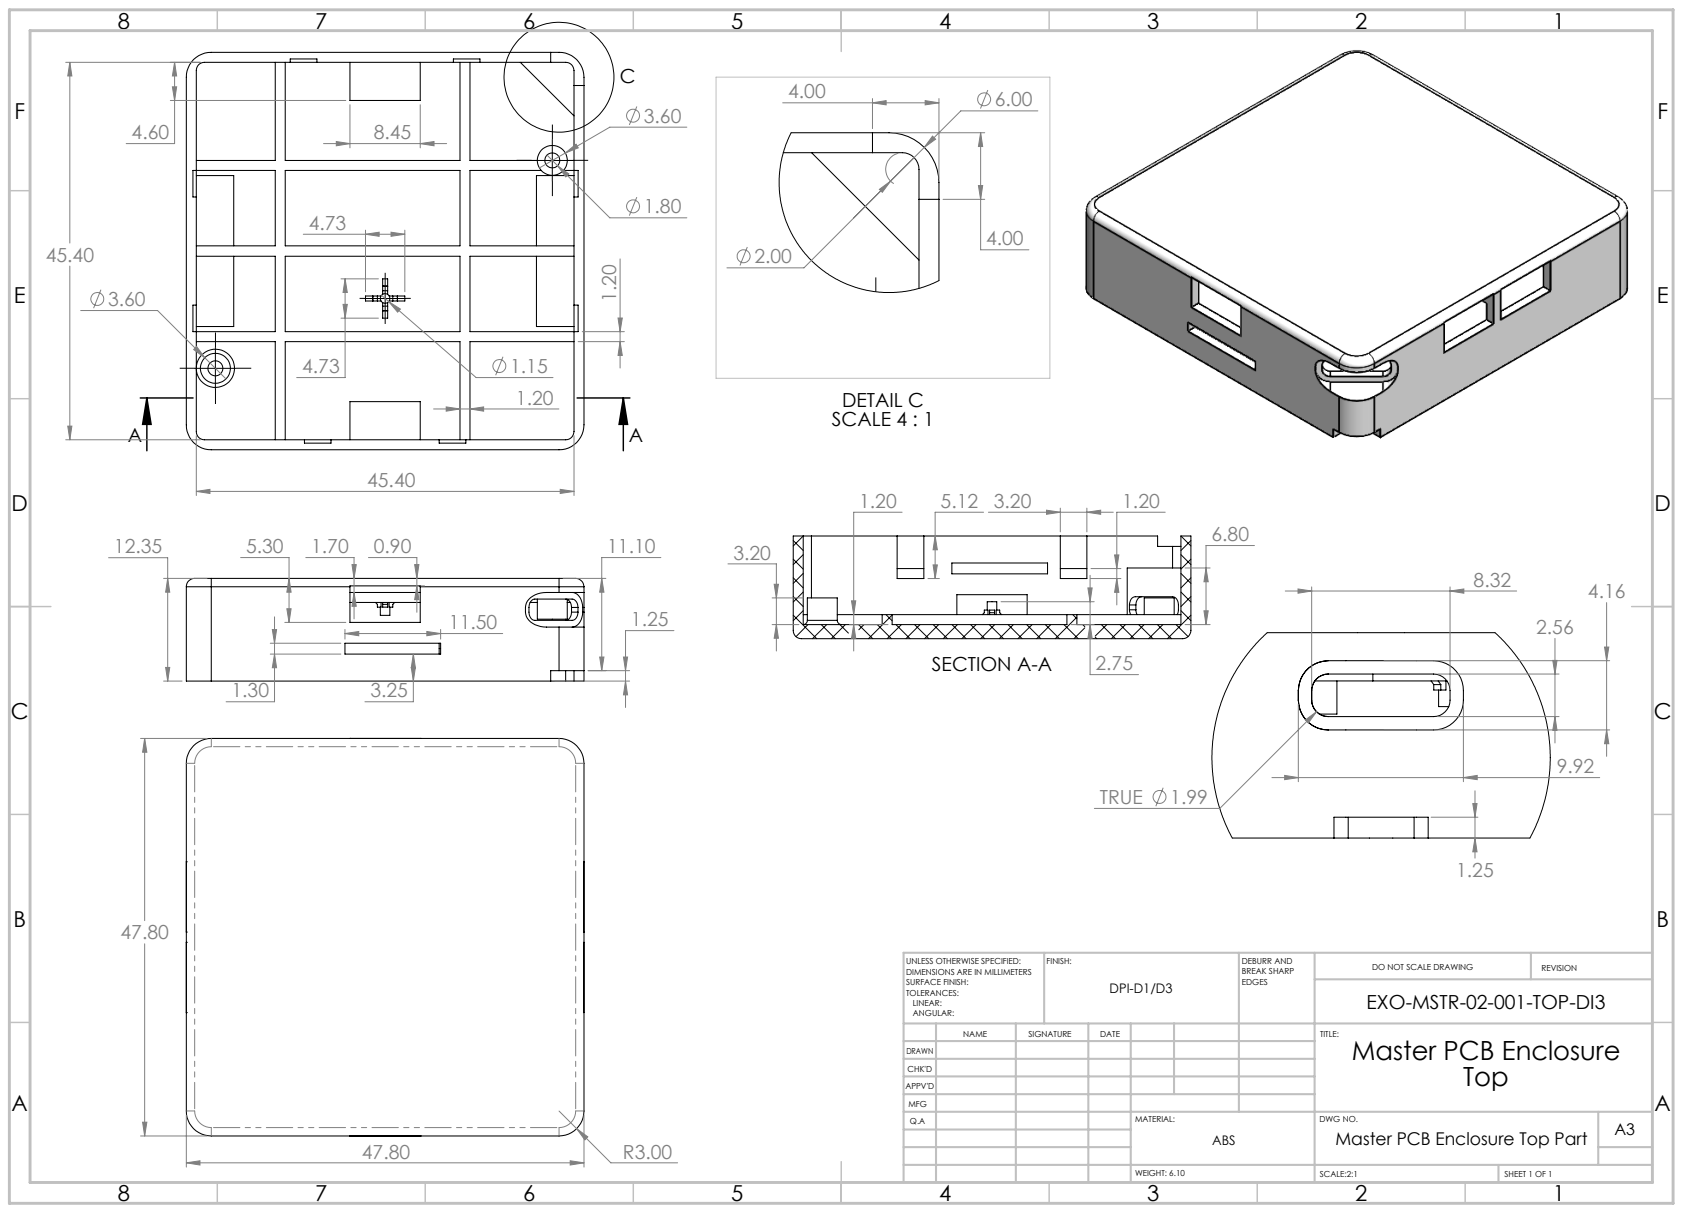
[picture p88: page 1]
TRUE 1.99; SECTION A-A; DETAIL C SCALE 4 : 1; FINISH:; DEBURR AND; BREAK SHARP; DO NOT SCALE DRAWING; REVISION; SCALE:2:1; SHEET 1 OF 1; WEIGHT: 6.10

UNLESS OTHERWISE SPECIFIED:
DIMENSIONS ARE IN MILLIMETERS
SURFACE FINISH:
TOLERANCES:
LINEAR:
ANGULAR:

EXO-MSTR-02-001-TOP-DI3

NAME | SIGNATURE | DATE | | | | TITLE: Master PCB Enclosure Top

DRAWN
CHK'D
APPV'D
MFG
Q.A | | | | MATERIAL: | DWG NO. Master PCB Enclosure Top Part | A3 ABS
