machadevrepos/Vantare_Vantage_Suit/Docs/Files from Client/Node PCB Enclosure Bottom DI4.pdf

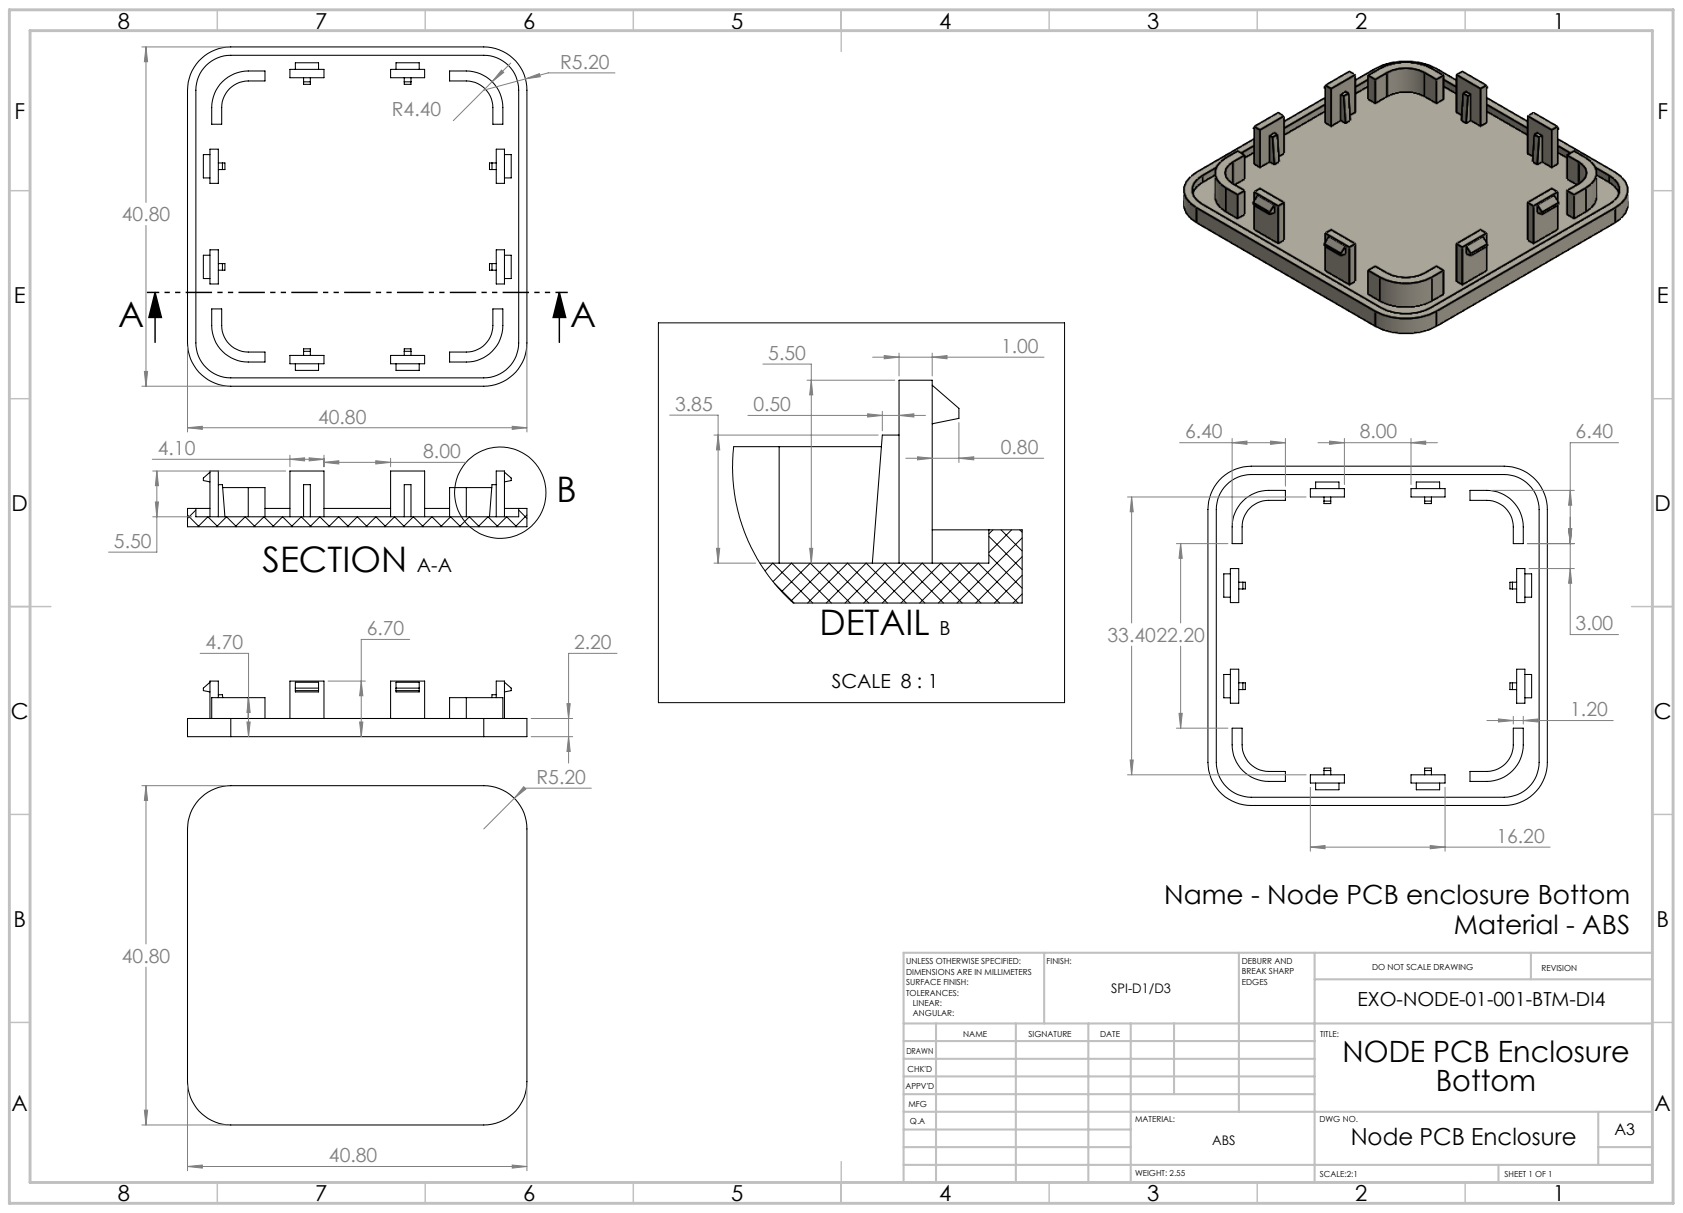
[picture p89: page 1]
SECTION A-A; DETAIL B; SCALE 8 : 1; Material - ABS; FINISH:; DEBURR AND; BREAK SHARP; DO NOT SCALE DRAWING; REVISION; SCALE:2:1; SHEET 1 OF 1; WEIGHT: 2.55

Name - Node PCB enclosure Bottom

UNLESS OTHERWISE SPECIFIED:
DIMENSIONS ARE IN MILLIMETERS
SURFACE FINISH:
TOLERANCES:
LINEAR:
ANGULAR:

EXO-NODE-01-001-BTM-DI4

NAME | SIGNATURE | DATE | | | | TITLE: NODE PCB Enclosure Bottom

DRAWN
CHK'D
APPV'D
MFG
Q.A | | | | MATERIAL: | DWG NO. Node PCB Enclosure | A3 ABS
