machadevrepos/Vantare_Vantage_Suit/(list of files, drawings)

Other design files:
Docs/P037-Exoskeleton/Exoskeleton Master PCB V1.0/ExoSkeleton Master PCB V1.0.PrjPcb
Docs/P037-Exoskeleton/Exoskeleton Master PCB V1.0/IMU Section.SchDoc
Docs/P037-Exoskeleton/Exoskeleton Master PCB V1.0/PCB V1.0.PcbDoc
Docs/P037-Exoskeleton/Exoskeleton Master PCB V1.0/Peripheral.SchDoc
Docs/P037-Exoskeleton/Exoskeleton Master PCB V1.0/Power Supply Section.SchDoc
Docs/P037-Exoskeleton/Exoskeleton Master PCB V1.0/RS485 Com and Connectors.SchDoc
Docs/P037-Exoskeleton/Exoskeleton Master PCB V1.0/STM32WB55 Main MCU.SchDoc
Docs/P037-Exoskeleton/Exoskeleton Master PCB V1.0/STM32WB55 Sensor MCU.SchDoc
Docs/P037-Exoskeleton/Exoskeleton Master PCB V1.0/Top Level Sheet.SchDoc
Docs/P037-Exoskeleton/Exoskeleton Master PCB V1.1/ExoSkeleton Master PCB V1.0.PrjPcb
Docs/P037-Exoskeleton/Exoskeleton Master PCB V1.1/IMU Section.SchDoc
Docs/P037-Exoskeleton/Exoskeleton Master PCB V1.1/PCB V1.0.PcbDoc
Docs/P037-Exoskeleton/Exoskeleton Master PCB V1.1/Peripheral.SchDoc
Docs/P037-Exoskeleton/Exoskeleton Master PCB V1.1/Power Supply Section.SchDoc
Docs/P037-Exoskeleton/Exoskeleton Master PCB V1.1/RS485 Com and Connectors.SchDoc
Docs/P037-Exoskeleton/Exoskeleton Master PCB V1.1/STM32WB55 Main MCU.SchDoc
Docs/P037-Exoskeleton/Exoskeleton Master PCB V1.1/STM32WB55 Sensor MCU.SchDoc
Docs/P037-Exoskeleton/Exoskeleton Master PCB V1.1/Top Level Sheet.SchDoc
Docs/P037-Exoskeleton/Exoskeleton Node PCB V1.0/ExoSkeleton Node PCB V1.0.PrjPcb
Docs/P037-Exoskeleton/Exoskeleton Node PCB V1.0/IMU Section.SchDoc
Docs/P037-Exoskeleton/Exoskeleton Node PCB V1.0/PCB V1.0.PcbDoc
Docs/P037-Exoskeleton/Exoskeleton Node PCB V1.0/Peripheral.SchDoc
Docs/P037-Exoskeleton/Exoskeleton Node PCB V1.0/Power Supply Section.SchDoc
Docs/P037-Exoskeleton/Exoskeleton Node PCB V1.0/RS485 Com and Connectors.SchDoc
Docs/P037-Exoskeleton/Exoskeleton Node PCB V1.0/STM32WB55 Main MCU.SchDoc
Docs/P037-Exoskeleton/Exoskeleton Node PCB V1.0/Top Level Sheet.SchDoc
Docs/P037-Exoskeleton/Exoskeleton Node PCB V1.1/ExoSkeleton Node PCB V1.0.PrjPcb
Docs/P037-Exoskeleton/Exoskeleton Node PCB V1.1/IMU Section.SchDoc
Docs/P037-Exoskeleton/Exoskeleton Node PCB V1.1/PCB V1.0.PcbDoc
Docs/P037-Exoskeleton/Exoskeleton Node PCB V1.1/Peripheral.SchDoc
Docs/P037-Exoskeleton/Exoskeleton Node PCB V1.1/Power Supply Section.SchDoc
Docs/P037-Exoskeleton/Exoskeleton Node PCB V1.1/RS485 Com and Connectors.SchDoc
Docs/P037-Exoskeleton/Exoskeleton Node PCB V1.1/STM32WB55 Main MCU.SchDoc
Docs/P037-Exoskeleton/Exoskeleton Node PCB V1.1/Top Level Sheet.SchDoc
