machadevrepos/Vantare_Vantage_Suit/Firmware/Master/Master.ioc

Mcu.UserName=STM32WB55CCUx
PA0.GPIO_Label=ICM_INT
PA0.Signal=GPXTI0
PA1.Signal=ADCx_IN6
PA10.GPIO_Label=BUZZER
PA10.Signal=S_TIM1_CH3
PA11.GPIO_Label=ERM
PA11.Signal=S_TIM1_CH4
PA12.Signal=SPI1_MOSI
PA13.Signal=SYS_JTMS-SWDIO
PA14.Signal=SYS_JTCK-SWCLK
PA15.GPIO_Label=BNO_INT
PA15.Signal=GPXTI15
PA2.GPIO_Label=TOUCH_MCU
PA2.Signal=GPXTI2
PA3.Signal=LPUART1_RX
PA4.Signal=SPI1_NSS
PA5.Signal=SPI1_SCK
PA6.Signal=SPI1_MISO
PA7.Signal=I2C3_SCL
PA8.Signal=USART1_CK
PA9.GPIO_Label=PWR_EN
PA9.Signal=GPIO_Output
PB0.GPIO_Label=RGB_R
PB0.Signal=GPIO_Output
PB1.GPIO_Label=RGB_G
PB1.Signal=GPIO_Output
PB2.GPIO_Label=CHG_STAT
PB2.Signal=GPIO_Input
PB4.Signal=I2C3_SDA
PB5.Signal=LPUART1_TX
PB6.Signal=USART1_TX
PB7.Signal=USART1_RX
PB8.Signal=I2C1_SCL
PB9.Signal=I2C1_SDA
PC14-OSC32_IN.Signal=RCC_OSC32_IN
PC15-OSC32_OUT.Signal=RCC_OSC32_OUT
PE4.GPIO_Label=RGB_B
PE4.Signal=GPIO_Output
