machadevrepos/Vantare_Vantage_Suit/Firmware/Master/Core/Inc/main.h

#define ICM_INT_Pin GPIO_PIN_0
#define ICM_INT_GPIO_Port GPIOA
#define TOUCH_MCU_Pin GPIO_PIN_2
#define TOUCH_MCU_GPIO_Port GPIOA
#define PWR_EN_Pin GPIO_PIN_9
#define PWR_EN_GPIO_Port GPIOA
#define CHG_STAT_Pin GPIO_PIN_2
#define CHG_STAT_GPIO_Port GPIOB
#define RGB_R_Pin GPIO_PIN_0
#define RGB_R_GPIO_Port GPIOB
#define RGB_G_Pin GPIO_PIN_1
#define RGB_G_GPIO_Port GPIOB
#define RGB_B_Pin GPIO_PIN_4
#define RGB_B_GPIO_Port GPIOE
#define BUZZER_Pin GPIO_PIN_10
#define BUZZER_GPIO_Port GPIOA
#define ERM_Pin GPIO_PIN_11
#define ERM_GPIO_Port GPIOA
#define BNO_INT_Pin GPIO_PIN_15
#define BNO_INT_GPIO_Port GPIOA
