machadevrepos/Vantare_Vantage_Suit/Firmware/Master/STM32_WPAN/App/app_ble.c

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

/* Includes ------------------------------------------------------------------*/
#include "main.h"

#include "app_common.h"

#include "dbg_trace.h"
#include "ble.h"
#include "tl.h"
#include "app_ble.h"

#include "stm32_seq.h"
#include "shci.h"
#include "stm32_lpm.h"
#include "otp.h"

#include "custom_app.h"

/* USER CODE BEGIN Includes */
#include <string.h>

#include "exo_hub_central_client.h"

extern void exo_ble_debug_printf(const char *fmt, ...);
#define EXO_LOG exo_ble_debug_printf

/* USER CODE END Includes */


/**
 * security parameters structure
 */
typedef struct _tSecurityParams
{
  /**
   * IO capability of the device
   */
  uint8_t ioCapability;

  /**
   * Authentication requirement of the device
   * Man In the Middle protection required?
   */
  uint8_t mitm_mode;

  /**
   * bonding mode of the device
   */
  uint8_t bonding_mode;

  /**
   * minimum encryption key size requirement
   */
  uint8_t encryptionKeySizeMin;

  /**
   * maximum encryption key size requirement
   */
  uint8_t encryptionKeySizeMax;

  /**
   * this flag indicates whether the host has to initiate
   * the security, wait for pairing or does not have any security
   * requirements.
   * 0x00 : no security required
   * 0x01 : host should initiate security by sending the slave security
   *        request command
   * 0x02 : host need not send the clave security request but it
   * has to wait for paiirng to complete before doing any other
   * processing
   */
  uint8_t initiateSecurity;
  /* USER CODE BEGIN tSecurityParams*/

  /* USER CODE END tSecurityParams */
}tSecurityParams;

/**
 * global context
 * contains the variables common to all
 * services
 */
typedef struct _tBLEProfileGlobalContext
{
  /**
   * security requirements of the host
   */
  tSecurityParams bleSecurityParam;

  /**
   * gap service handle
   */
  uint16_t gapServiceHandle;

  /**
   * device name characteristic handle
   */
  uint16_t devNameCharHandle;

  /**
   * appearance characteristic handle
   */
  uint16_t appearanceCharHandle;

  /**
   * connection handle of the current active connection
   * When not in connection, the handle is set to 0xFFFF
   */
  uint16_t connectionHandle;

  /**
   * length of the UUID list to be used while advertising
   */
  uint8_t advtServUUIDlen;

  /**
   * the UUID list to be used while advertising
   */
  uint8_t advtServUUID[100];
  /* USER CODE BEGIN BleGlobalContext_t*/

  /* USER CODE END BleGlobalContext_t */
}BleGlobalContext_t;

typedef struct
{
  BleGlobalContext_t BleApplicationContext_legacy;
  APP_BLE_ConnStatus_t Device_Connection_Status;
  /* USER CODE BEGIN PTD_1*/

  /* USER CODE END PTD_1 */
}BleApplicationContext_t;

#define FAST_ADV_TIMEOUT               (30*1000*1000/CFG_TS_TICK_VAL) /**< 30s */
#define INITIAL_ADV_TIMEOUT            (60*1000*1000/CFG_TS_TICK_VAL) /**< 60s */

#define BD_ADDR_SIZE_LOCAL    6
#define BLE_DEFAULT_PIN                     (111111)

PLACE_IN_SECTION("MB_MEM1") ALIGN(4) static TL_CmdPacket_t BleCmdBuffer;

/**
 *   Identity root key used to derive IRK and DHK(Legacy)
 */
static const uint8_t a_BLE_CfgIrValue[16] = CFG_BLE_IR;

/**
 * Encryption root key used to derive LTK(Legacy) and CSRK
 */
static const uint8_t a_BLE_CfgErValue[16] = CFG_BLE_ER;

/**
 * These are the two tags used to manage a power failure during OTA
 * The MagicKeywordAdress shall be mapped @0x140 from start of the binary image
 * The MagicKeywordvalue is checked in the ble_ota application
 */
PLACE_IN_SECTION("TAG_OTA_END") const uint32_t MagicKeywordValue = 0x94448A29 ;
PLACE_IN_SECTION("TAG_OTA_START") const uint32_t MagicKeywordAddress = (uint32_t)&MagicKeywordValue;

static BleApplicationContext_t BleApplicationContext;

Custom_App_ConnHandle_Not_evt_t HandleNotification;

#if (L2CAP_REQUEST_NEW_CONN_PARAM != 0)
#define SIZE_TAB_CONN_INT            2
float a_ConnInterval[SIZE_TAB_CONN_INT] = {50, 1000}; /* ms */
uint8_t index_con_int, mutex;
#endif /* L2CAP_REQUEST_NEW_CONN_PARAM != 0 */

/**
 * Advertising Data
 */
uint8_t a_AdvData[13] =
{
  8, AD_TYPE_COMPLETE_LOCAL_NAME, 'H', 'U', 'B', '0', '0', '0', '1',  /* Complete name */
  3, AD_TYPE_16_BIT_SERV_UUID_CMPLT_LIST, 0x00, 0x00,

};

/* USER CODE BEGIN PV */
static uint16_t g_phone_connection_handle = 0xFFFFU;
static uint8_t g_leaf_client_connecting = 0U;
static uint8_t g_phone_connected = 0U;
static uint8_t g_leaf_scan_holds_advertising = 0U;

/* USER CODE END PV */

static void BLE_UserEvtRx(void *p_Payload);
static void BLE_StatusNot(HCI_TL_CmdStatus_t Status);
static void Ble_Tl_Init(void);
static void Ble_Hci_Gap_Gatt_Init(void);
static void Adv_Request(APP_BLE_ConnStatus_t NewStatus);
static void Adv_Cancel(void);
#if (L2CAP_REQUEST_NEW_CONN_PARAM != 0)
static void BLE_SVC_L2CAP_Conn_Update(uint16_t ConnectionHandle);
static void Connection_Interval_Update_Req(void);
#endif /* L2CAP_REQUEST_NEW_CONN_PARAM != 0 */

/* USER CODE BEGIN PFP */
void APP_BLE_LeafClientConnecting(void);
void APP_BLE_LeafClientConnectIdle(void);
uint8_t APP_BLE_LeafClientPrepareScan(void);
void APP_BLE_LeafClientScanIdle(void);
uint8_t APP_BLE_LeafClientPhoneConnected(void);

/* USER CODE END PFP */

/* External variables --------------------------------------------------------*/

/* Functions Definition ------------------------------------------------------*/
void APP_BLE_Init(void)
{
  SHCI_CmdStatus_t status;
#if (RADIO_ACTIVITY_EVENT != 0)
  tBleStatus ret = BLE_STATUS_INVALID_PARAMS;
#endif /* RADIO_ACTIVITY_EVENT != 0 */
  /* USER CODE BEGIN APP_BLE_Init_1 */
  EXO_LOG("[BLE][APP][INIT] shci cfg_links=%u max_att_mtu=%u mblocks=%u\r\n",
          (unsigned)CFG_BLE_NUM_LINK,
          (unsigned)CFG_BLE_MAX_ATT_MTU,
          (unsigned)CFG_BLE_MBLOCK_COUNT);

  /* USER CODE END APP_BLE_Init_1 */
  SHCI_C2_Ble_Init_Cmd_Packet_t ble_init_cmd_packet =
  {
    {{0,0,0}},                          /**< Header unused */
    {0,                                 /** pBleBufferAddress not used */
     0,                                 /** BleBufferSize not used */
     CFG_BLE_NUM_GATT_ATTRIBUTES,
     CFG_BLE_NUM_GATT_SERVICES,
     CFG_BLE_ATT_VALUE_ARRAY_SIZE,
     CFG_BLE_NUM_LINK,
     CFG_BLE_DATA_LENGTH_EXTENSION,
     CFG_BLE_PREPARE_WRITE_LIST_SIZE,
     CFG_BLE_MBLOCK_COUNT,
     CFG_BLE_MAX_ATT_MTU,
     CFG_BLE_PERIPHERAL_SCA,
     CFG_BLE_CENTRAL_SCA,
     CFG_BLE_LS_SOURCE,
     CFG_BLE_MAX_CONN_EVENT_LENGTH,
     CFG_BLE_HSE_STARTUP_TIME,
     CFG_BLE_VITERBI_MODE,
     CFG_BLE_OPTIONS,
     0,
     CFG_BLE_MAX_COC_INITIATOR_NBR,
     CFG_BLE_MIN_TX_POWER,
     CFG_BLE_MAX_TX_POWER,
     CFG_BLE_RX_MODEL_CONFIG,
     CFG_BLE_MAX_ADV_SET_NBR,
     CFG_BLE_MAX_ADV_DATA_LEN,
     CFG_BLE_TX_PATH_COMPENS,
     CFG_BLE_RX_PATH_COMPENS,
     CFG_BLE_CORE_VERSION,
     CFG_BLE_OPTIONS_EXT,
	 CFG_BLE_MAX_ADD_EATT_BEARERS
    }
  };

  /**
   * Initialize Ble Transport Layer
   */
  Ble_Tl_Init();

  /**
   * Do not allow standby in the application
   */
  UTIL_LPM_SetOffMode(1 << CFG_LPM_APP_BLE, UTIL_LPM_DISABLE);

  /**
   * Register the hci transport layer to handle BLE User Asynchronous Events
   */
  UTIL_SEQ_RegTask(1<<CFG_TASK_HCI_ASYNCH_EVT_ID, UTIL_SEQ_RFU, hci_user_evt_proc);

  /**
   * Starts the BLE Stack on CPU2
   */
  status = SHCI_C2_BLE_Init(&ble_init_cmd_packet);
  if (status != SHCI_Success)
  {
    APP_DBG_MSG("  Fail   : SHCI_C2_BLE_Init command, result: 0x%02x\n\r", status);
    /* if you are here, maybe CPU2 doesn't contain STM32WB_Copro_Wireless_Binaries, see Release_Notes.html */
    Error_Handler();
  }
  else
  {
    APP_DBG_MSG("  Success: SHCI_C2_BLE_Init command\n\r");
  }

  /**
   * Initialization of HCI & GATT & GAP layer
   */
  Ble_Hci_Gap_Gatt_Init();

  /**
   * Initialization of the BLE Services
   */
  SVCCTL_Init();

  /**
   * Initialization of the BLE App Context
   */
  BleApplicationContext.Device_Connection_Status = APP_BLE_IDLE;
  BleApplicationContext.BleApplicationContext_legacy.connectionHandle = 0xFFFF;

  /**
   * From here, all initialization are BLE application specific
   */

  UTIL_SEQ_RegTask(1<<CFG_TASK_ADV_CANCEL_ID, UTIL_SEQ_RFU, Adv_Cancel);

  /* USER CODE BEGIN APP_BLE_Init_4 */
  g_phone_connection_handle = 0xFFFFU;
  g_leaf_client_connecting = 0U;
  g_phone_connected = 0U;

  /* USER CODE END APP_BLE_Init_4 */

  /**
   * Initialization of ADV - Ad Manufacturer Element - Support OTA Bit Mask
   */
#if (RADIO_ACTIVITY_EVENT != 0)
  ret = aci_hal_set_radio_activity_mask(0x0006);
  if (ret != BLE_STATUS_SUCCESS)
  {
    APP_DBG_MSG("  Fail   : aci_hal_set_radio_activity_mask command, result: 0x%x \n\r", ret);
  }
  else
  {
    APP_DBG_MSG("  Success: aci_hal_set_radio_activity_mask command\n\r");
  }
#endif /* RADIO_ACTIVITY_EVENT != 0 */

#if (L2CAP_REQUEST_NEW_CONN_PARAM != 0)
  index_con_int = 0;
  mutex = 1;
#endif /* L2CAP_REQUEST_NEW_CONN_PARAM != 0 */

  /**
   * Initialize Custom Template Application
   */
  Custom_APP_Init();

  /**
   * Make device discoverable
   */
  BleApplicationContext.BleApplicationContext_legacy.advtServUUID[0] = NULL;
  BleApplicationContext.BleApplicationContext_legacy.advtServUUIDlen = 0;

  /**
   * Start to Advertise to be connected by a Client
   */
  Adv_Request(APP_BLE_FAST_ADV);

  /* USER CODE BEGIN APP_BLE_Init_2 */
  exo_hub_central_client_set_ble_ready();

  /* USER CODE END APP_BLE_Init_2 */

  return;
}

SVCCTL_UserEvtFlowStatus_t SVCCTL_App_Notification(void *p_Pckt)
{
  hci_event_pckt    *p_event_pckt;
  evt_le_meta_event *p_meta_evt;
  evt_blecore_aci   *p_blecore_evt;
  tBleStatus        ret = BLE_STATUS_INVALID_PARAMS;
  hci_le_connection_complete_event_rp0        *p_connection_complete_event;
  hci_disconnection_complete_event_rp0        *p_disconnection_complete_event;
#if (CFG_DEBUG_APP_TRACE != 0)
  hci_le_connection_update_complete_event_rp0 *p_connection_update_complete_event;
#endif /* CFG_DEBUG_APP_TRACE != 0 */

  /* PAIRING */
  aci_gap_pairing_complete_event_rp0          *p_pairing_complete;
  /* PAIRING */

  p_event_pckt = (hci_event_pckt*) ((hci_uart_pckt *) p_Pckt)->data;

  switch (p_event_pckt->evt)
  {
    case HCI_DISCONNECTION_COMPLETE_EVT_CODE:
    {
      p_disconnection_complete_event = (hci_disconnection_complete_event_rp0 *) p_event_pckt->data;

      if (p_disconnection_complete_event->Connection_Handle == BleApplicationContext.BleApplicationContext_legacy.connectionHandle)
      {
        BleApplicationContext.BleApplicationContext_legacy.connectionHandle = 0;
        BleApplicationContext.Device_Connection_Status = APP_BLE_IDLE;
        APP_DBG_MSG(">>== HCI_DISCONNECTION_COMPLETE_EVT_CODE\n");
        APP_DBG_MSG("     - Connection Handle:   0x%x\n     - Reason:    0x%x\n\r",
                    p_disconnection_complete_event->Connection_Handle,
                    p_disconnection_complete_event->Reason);

      }

      /* USER CODE BEGIN EVT_DISCONN_COMPLETE_1 */
      if (p_disconnection_complete_event->Connection_Handle == g_phone_connection_handle)
      {
        g_phone_connected = 0U;
        g_phone_connection_handle = 0xFFFFU;
        EXO_LOG("[BLE][APP][DISC] phone disconnect handle=0x%04X reason=0x%02X\r\n",
                (unsigned)p_disconnection_complete_event->Connection_Handle,
                (unsigned)p_disconnection_complete_event->Reason);
      }
      else
      {
        EXO_LOG("[BLE][APP][DISC] leaf disconnect handle=0x%04X reason=0x%02X\r\n",
                (unsigned)p_disconnection_complete_event->Connection_Handle,
                (unsigned)p_disconnection_complete_event->Reason);
        exo_hub_central_client_on_disconnection_complete(p_disconnection_complete_event->Connection_Handle,
                                                         p_disconnection_complete_event->Reason);
        if (g_phone_connected != 0U)
        {
          BleApplicationContext.Device_Connection_Status = APP_BLE_CONNECTED_SERVER;
          BleApplicationContext.BleApplicationContext_legacy.connectionHandle = g_phone_connection_handle;
        }
      }

      /* USER CODE END EVT_DISCONN_COMPLETE_1 */

      /* restart advertising */
      Adv_Request(APP_BLE_FAST_ADV);

      /**
       * SPECIFIC to Custom Template APP
       */
      HandleNotification.Custom_Evt_Opcode = CUSTOM_DISCON_HANDLE_EVT;
      HandleNotification.ConnectionHandle = BleApplicationContext.BleApplicationContext_legacy.connectionHandle;
      Custom_APP_Notification(&HandleNotification);
      break; /* HCI_DISCONNECTION_COMPLETE_EVT_CODE */
    }

    case HCI_HARDWARE_ERROR_EVT_CODE:
    {
      hci_hardware_error_event_rp0 *p_hardware_error_event;

      p_hardware_error_event = (hci_hardware_error_event_rp0 *)p_event_pckt->data;
	  UNUSED(p_hardware_error_event);
      APP_DBG_MSG(">>== HCI_HARDWARE_ERROR_EVT_CODE\n");
      APP_DBG_MSG("Hardware Code = 0x%02X\n",p_hardware_error_event->Hardware_Code);
      break; /* HCI_HARDWARE_ERROR_EVT_CODE */
    }

    case HCI_LE_META_EVT_CODE:
    {
      p_meta_evt = (evt_le_meta_event*) p_event_pckt->data;
      /* USER CODE BEGIN EVT_LE_META_EVENT */
      if (p_meta_evt->subevent == HCI_LE_ADVERTISING_REPORT_SUBEVT_CODE)
      {
        const uint8_t *raw_adv = (const uint8_t *)p_meta_evt->data;
        const uint8_t raw_adv_len = (p_event_pckt->plen > 1U) ? (uint8_t)(p_event_pckt->plen - 1U) : 0U;
        if (raw_adv_len < 11U)
        {
          EXO_LOG("[BLE][APP][DISC] adv report short len=%u\r\n",
                  (unsigned)raw_adv_len);
        }
        else if (raw_adv[0] != 0U)
        {
          Advertising_Report_t adv_report;
          uint8_t data_len;
          const uint8_t num_reports = raw_adv[0];
          adv_report.Event_Type = raw_adv[1];
          adv_report.Address_Type = raw_adv[2];
          memcpy(adv_report.Address, &raw_adv[3], sizeof(adv_report.Address));
          data_len = raw_adv[9];
          if (data_len > 31U)
          {
            EXO_LOG("[BLE][APP][DISC] adv report invalid len=%u count=%u\r\n",
                    (unsigned)data_len,
                    (unsigned)num_reports);
          }
          else if ((uint8_t)(10U + data_len) >= raw_adv_len)
          {
            EXO_LOG("[BLE][APP][DISC] adv report truncated raw_len=%u adv_len=%u count=%u\r\n",
                    (unsigned)raw_adv_len,
                    (unsigned)data_len,
                    (unsigned)num_reports);
          }
          else
          {
            adv_report.Length_Data = data_len;
            adv_report.Data = &raw_adv[10];
            adv_report.RSSI = raw_adv[10U + data_len];
//            EXO_LOG("[BLE][APP][DISC] adv report count=%u rssi=%d len=%u type=0x%02X\r\n",
//                    (unsigned)num_reports,
//                    (int)(int8_t)adv_report.RSSI,
//                    (unsigned)adv_report.Length_Data,
//                    (unsigned)adv_report.Event_Type);
            hci_le_advertising_report_event(1U, &adv_report);
          }
        }
      }

      /* USER CODE END EVT_LE_META_EVENT */
      switch (p_meta_evt->subevent)
      {
        case HCI_LE_CONNECTION_UPDATE_COMPLETE_SUBEVT_CODE:
#if (CFG_DEBUG_APP_TRACE != 0)
          p_connection_update_complete_event = (hci_le_connection_update_complete_event_rp0 *) p_meta_evt->data;
          APP_DBG_MSG(">>== HCI_LE_CONNECTION_UPDATE_COMPLETE_SUBEVT_CODE\n");
          APP_DBG_MSG("     - Connection Interval:   %.2f ms\n     - Connection latency:    %d\n     - Supervision Timeout: %d ms\n\r",
                       p_connection_update_complete_event->Conn_Interval*1.25,
                       p_connection_update_complete_event->Conn_Latency,
                       p_connection_update_complete_event->Supervision_Timeout*10);
#endif /* CFG_DEBUG_APP_TRACE != 0 */

          break;

        case HCI_LE_CONNECTION_COMPLETE_SUBEVT_CODE:
        {
          p_connection_complete_event = (hci_le_connection_complete_event_rp0 *) p_meta_evt->data;
          /**
           * The connection is done, there is no need anymore to schedule the LP ADV
           */

          APP_DBG_MSG(">>== HCI_LE_CONNECTION_COMPLETE_SUBEVT_CODE - Connection handle: 0x%x\n", p_connection_complete_event->Connection_Handle);
          APP_DBG_MSG("     - Connection established with Central: @:%02x:%02x:%02x:%02x:%02x:%02x\n",
                      p_connection_complete_event->Peer_Address[5],
                      p_connection_complete_event->Peer_Address[4],
                      p_connection_complete_event->Peer_Address[3],
                      p_connection_complete_event->Peer_Address[2],
                      p_connection_complete_event->Peer_Address[1],
                      p_connection_complete_event->Peer_Address[0]);
          APP_DBG_MSG("     - Connection Interval:   %.2f ms\n     - Connection latency:    %d\n     - Supervision Timeout: %d ms\n\r",
                      p_connection_complete_event->Conn_Interval*1.25,
                      p_connection_complete_event->Conn_Latency,
                      p_connection_complete_event->Supervision_Timeout*10
                     );

          if (BleApplicationContext.Device_Connection_Status == APP_BLE_LP_CONNECTING)
          {
            /* Connection as client */
            BleApplicationContext.Device_Connection_Status = APP_BLE_CONNECTED_CLIENT;
          }
          else
          {
            /* Connection as server */
            BleApplicationContext.Device_Connection_Status = APP_BLE_CONNECTED_SERVER;
          }
          BleApplicationContext.BleApplicationContext_legacy.connectionHandle = p_connection_complete_event->Connection_Handle;
          /**
           * SPECIFIC to Custom Template APP
           */
          HandleNotification.Custom_Evt_Opcode = CUSTOM_CONN_HANDLE_EVT;
          HandleNotification.ConnectionHandle = BleApplicationContext.BleApplicationContext_legacy.connectionHandle;
          Custom_APP_Notification(&HandleNotification);
          /* USER CODE BEGIN HCI_EVT_LE_CONN_COMPLETE */
          if (g_leaf_client_connecting != 0U && (p_connection_complete_event->Status != 0U || p_connection_complete_event->Role == 0U))
          {
            g_leaf_client_connecting = 0U;
            EXO_LOG("[BLE][APP][DISC] leaf connect handle=0x%04X status=0x%02X role=%u addr=%02X:%02X:%02X:%02X:%02X:%02X\r\n",
                    (unsigned)p_connection_complete_event->Connection_Handle,
                    (unsigned)p_connection_complete_event->Status,
                    (unsigned)p_connection_complete_event->Role,
                    (unsigned)p_connection_complete_event->Peer_Address[5],
                    (unsigned)p_connection_complete_event->Peer_Address[4],
                    (unsigned)p_connection_complete_event->Peer_Address[3],
                    (unsigned)p_connection_complete_event->Peer_Address[2],
                    (unsigned)p_connection_complete_event->Peer_Address[1],
                    (unsigned)p_connection_complete_event->Peer_Address[0]);
            exo_hub_central_client_on_connection_complete(1U,
                                                          p_connection_complete_event->Status,
                                                          p_connection_complete_event->Connection_Handle,
                                                          p_connection_complete_event->Peer_Address_Type,
                                                          p_connection_complete_event->Peer_Address);
            if (g_phone_connected != 0U)
            {
              BleApplicationContext.Device_Connection_Status = APP_BLE_CONNECTED_SERVER;
              BleApplicationContext.BleApplicationContext_legacy.connectionHandle = g_phone_connection_handle;
            }
          }
          else
          {
            g_phone_connected = 1U;
            g_phone_connection_handle = p_connection_complete_event->Connection_Handle;
            if (g_leaf_client_connecting != 0U)
            {
              BleApplicationContext.Device_Connection_Status = APP_BLE_LP_CONNECTING;
            }
            EXO_LOG("[BLE][APP][DISC] phone connect handle=0x%04X status=0x%02X role=%u leaf_pending=%u addr=%02X:%02X:%02X:%02X:%02X:%02X\r\n",
                    (unsigned)p_connection_complete_event->Connection_Handle,
                    (unsigned)p_connection_complete_event->Status,
                    (unsigned)p_connection_complete_event->Role,
                    (unsigned)g_leaf_client_connecting,
                    (unsigned)p_connection_complete_event->Peer_Address[5],
                    (unsigned)p_connection_complete_event->Peer_Address[4],
                    (unsigned)p_connection_complete_event->Peer_Address[3],
                    (unsigned)p_connection_complete_event->Peer_Address[2],
                    (unsigned)p_connection_complete_event->Peer_Address[1],
                    (unsigned)p_connection_complete_event->Peer_Address[0]);
          }

          /* USER CODE END HCI_EVT_LE_CONN_COMPLETE */
          break; /* HCI_LE_CONNECTION_COMPLETE_SUBEVT_CODE */
        }

        default:
          break;
      }

      break; /* HCI_LE_META_EVT_CODE */
    }

    case HCI_VENDOR_SPECIFIC_DEBUG_EVT_CODE:
      p_blecore_evt = (evt_blecore_aci*) p_event_pckt->data;
      /* USER CODE BEGIN EVT_VENDOR */
      switch (p_blecore_evt->ecode)
      {
        case ACI_GAP_PROC_COMPLETE_VSEVT_CODE:
        {
          const aci_gap_proc_complete_event_rp0 *p_evt =
              (const aci_gap_proc_complete_event_rp0 *)p_blecore_evt->data;
          aci_gap_proc_complete_event(p_evt->Procedure_Code,
                                      p_evt->Status,
                                      p_evt->Data_Length,
                                      p_evt->Data);
          break;
        }

        case ACI_ATT_READ_BY_GROUP_TYPE_RESP_VSEVT_CODE:
        {
          const aci_att_read_by_group_type_resp_event_rp0 *p_evt =
              (const aci_att_read_by_group_type_resp_event_rp0 *)p_blecore_evt->data;
          aci_att_read_by_group_type_resp_event(p_evt->Connection_Handle,
                                                p_evt->Attribute_Data_Length,
                                                p_evt->Data_Length,
                                                p_evt->Attribute_Data_List);
          break;
        }

        case ACI_ATT_READ_BY_TYPE_RESP_VSEVT_CODE:
        {
          const aci_att_read_by_type_resp_event_rp0 *p_evt =
              (const aci_att_read_by_type_resp_event_rp0 *)p_blecore_evt->data;
          aci_att_read_by_type_resp_event(p_evt->Connection_Handle,
                                          p_evt->Handle_Value_Pair_Length,
                                          p_evt->Data_Length,
                                          p_evt->Handle_Value_Pair_Data);
          break;
        }

        case ACI_GATT_NOTIFICATION_VSEVT_CODE:
        {
          const aci_gatt_notification_event_rp0 *p_evt =
              (const aci_gatt_notification_event_rp0 *)p_blecore_evt->data;
          aci_gatt_notification_event(p_evt->Connection_Handle,
                                      p_evt->Attribute_Handle,
                                      p_evt->Attribute_Value_Length,
                                      p_evt->Attribute_Value);
          break;
        }

        case ACI_GATT_INDICATION_VSEVT_CODE:
        {
          const aci_gatt_indication_event_rp0 *p_evt =
              (const aci_gatt_indication_event_rp0 *)p_blecore_evt->data;
          aci_gatt_indication_event(p_evt->Connection_Handle,
                                    p_evt->Attribute_Handle,
                                    p_evt->Attribute_Value_Length,
                                    p_evt->Attribute_Value);
          break;
        }

        case ACI_GATT_PROC_COMPLETE_VSEVT_CODE:
        {
          const aci_gatt_proc_complete_event_rp0 *p_evt =
              (const aci_gatt_proc_complete_event_rp0 *)p_blecore_evt->data;
          aci_gatt_proc_complete_event(p_evt->Connection_Handle,
                                       p_evt->Error_Code);
          break;
        }

        default:
          break;
      }

      /* USER CODE END EVT_VENDOR */
      switch (p_blecore_evt->ecode)
      {
        /**
         * SPECIFIC to Custom Template APP
         */
        case ACI_L2CAP_CONNECTION_UPDATE_RESP_VSEVT_CODE:
#if (L2CAP_REQUEST_NEW_CONN_PARAM != 0)
          mutex = 1;
#endif /* L2CAP_REQUEST_NEW_CONN_PARAM != 0 */
          /* USER CODE BEGIN EVT_BLUE_L2CAP_CONNECTION_UPDATE_RESP */

          /* USER CODE END EVT_BLUE_L2CAP_CONNECTION_UPDATE_RESP */
          break;

        case ACI_GAP_PROC_COMPLETE_VSEVT_CODE:
          APP_DBG_MSG(">>== ACI_GAP_PROC_COMPLETE_VSEVT_CODE \r");
          /* USER CODE BEGIN EVT_BLUE_GAP_PROCEDURE_COMPLETE */

          /* USER CODE END EVT_BLUE_GAP_PROCEDURE_COMPLETE */
          break; /* ACI_GAP_PROC_COMPLETE_VSEVT_CODE */

#if (RADIO_ACTIVITY_EVENT != 0)
        case ACI_HAL_END_OF_RADIO_ACTIVITY_VSEVT_CODE:
          /* USER CODE BEGIN RADIO_ACTIVITY_EVENT*/

          /* USER CODE END RADIO_ACTIVITY_EVENT*/
          break; /* ACI_HAL_END_OF_RADIO_ACTIVITY_VSEVT_CODE */
#endif /* RADIO_ACTIVITY_EVENT != 0 */

        /* PAIRING */
        case (ACI_GAP_KEYPRESS_NOTIFICATION_VSEVT_CODE):
            APP_DBG_MSG(">>== ACI_GAP_KEYPRESS_NOTIFICATION_VSEVT_CODE\n");
          /* USER CODE BEGIN ACI_GAP_KEYPRESS_NOTIFICATION_VSEVT_CODE*/

          /* USER CODE END ACI_GAP_KEYPRESS_NOTIFICATION_VSEVT_CODE*/
          break;

        case ACI_GAP_PASS_KEY_REQ_VSEVT_CODE:
		{
	      uint32_t pin;
          APP_DBG_MSG(">>== ACI_GAP_PASS_KEY_REQ_VSEVT_CODE \n");
          pin = BLE_DEFAULT_PIN;
          /* USER CODE BEGIN ACI_GAP_PASS_KEY_REQ_VSEVT_CODE_0 */

          /* USER CODE END ACI_GAP_PASS_KEY_REQ_VSEVT_CODE_0 */

          ret = aci_gap_pass_key_resp(BleApplicationContext.BleApplicationContext_legacy.connectionHandle, pin);
          if (ret != BLE_STATUS_SUCCESS)
          {
            APP_DBG_MSG("==>> aci_gap_pass_key_resp : Fail, reason: 0x%x\n", ret);
          }
          else
          {
            APP_DBG_MSG("==>> aci_gap_pass_key_resp : Success \n");
          }
          /* USER CODE BEGIN ACI_GAP_PASS_KEY_REQ_VSEVT_CODE*/

          /* USER CODE END ACI_GAP_PASS_KEY_REQ_VSEVT_CODE*/
          break;
		}

        case ACI_GAP_NUMERIC_COMPARISON_VALUE_VSEVT_CODE:
          APP_DBG_MSG(">>== ACI_GAP_NUMERIC_COMPARISON_VALUE_VSEVT_CODE\n");
          APP_DBG_MSG("     - numeric_value = %ld\n",
                      ((aci_gap_numeric_comparison_value_event_rp0 *)(p_blecore_evt->data))->Numeric_Value);
          APP_DBG_MSG("     - Hex_value = %lx\n",
                      ((aci_gap_numeric_comparison_value_event_rp0 *)(p_blecore_evt->data))->Numeric_Value);
          ret = aci_gap_numeric_comparison_value_confirm_yesno(BleApplicationContext.BleApplicationContext_legacy.connectionHandle, YES);
          if (ret != BLE_STATUS_SUCCESS)
          {
            APP_DBG_MSG("==>> aci_gap_numeric_comparison_value_confirm_yesno-->YES : Fail, reason: 0x%x\n", ret);
          }
          else
          {
            APP_DBG_MSG("==>> aci_gap_numeric_comparison_value_confirm_yesno-->YES : Success \n");
          }
          /* USER CODE BEGIN ACI_GAP_NUMERIC_COMPARISON_VALUE_VSEVT_CODE*/

          /* USER CODE END ACI_GAP_NUMERIC_COMPARISON_VALUE_VSEVT_CODE*/
          break;

        case ACI_GAP_PAIRING_COMPLETE_VSEVT_CODE:
          p_pairing_complete = (aci_gap_pairing_complete_event_rp0*)p_blecore_evt->data;

          APP_DBG_MSG(">>== ACI_GAP_PAIRING_COMPLETE_VSEVT_CODE\n");
          if (p_pairing_complete->Status != 0)
          {
            APP_DBG_MSG("     - Pairing KO \n     - Status: 0x%x\n     - Reason: 0x%x\n", p_pairing_complete->Status, p_pairing_complete->Reason);
          }
          else
          {
            APP_DBG_MSG("     - Pairing Success\n");
          }
          APP_DBG_MSG("\n");

          /* USER CODE BEGIN ACI_GAP_PAIRING_COMPLETE_VSEVT_CODE*/

          /* USER CODE END ACI_GAP_PAIRING_COMPLETE_VSEVT_CODE*/
          break;
        /* PAIRING */
        case ACI_GATT_INDICATION_VSEVT_CODE:
        {
          APP_DBG_MSG(">>== ACI_GATT_INDICATION_VSEVT_CODE \r");
          aci_gatt_confirm_indication(BleApplicationContext.BleApplicationContext_legacy.connectionHandle);
        }
        break;

        case ACI_HAL_WARNING_VSEVT_CODE:
        {
          aci_hal_warning_event_rp0 *p_warning_event;

	      p_warning_event = (aci_hal_warning_event_rp0 *)p_blecore_evt->data;
		  UNUSED(p_warning_event);
          APP_DBG_MSG(">>== ACI_HAL_WARNING_VSEVT_CODE\n");
          APP_DBG_MSG("Warning Type = 0x%02X\n", p_warning_event->Warning_Type);
          break;
        }
      }
      break; /* HCI_VENDOR_SPECIFIC_DEBUG_EVT_CODE */

    default:
      /* USER CODE BEGIN ECODE_DEFAULT*/

      /* USER CODE END ECODE_DEFAULT*/
      break;
  }

  return (SVCCTL_UserEvtFlowEnable);
}

APP_BLE_ConnStatus_t APP_BLE_Get_Server_Connection_Status(void)
{
  return BleApplicationContext.Device_Connection_Status;
}

/* USER CODE BEGIN FD*/
void APP_BLE_LeafClientConnecting(void)
{
  g_leaf_client_connecting = 1U;
  BleApplicationContext.Device_Connection_Status = APP_BLE_LP_CONNECTING;
  EXO_LOG("[BLE][APP][DISC] connect state=CONNECTING\r\n");
}

void APP_BLE_LeafClientConnectIdle(void)
{
  g_leaf_client_connecting = 0U;
  if (g_phone_connected != 0U)
  {
    BleApplicationContext.Device_Connection_Status = APP_BLE_CONNECTED_SERVER;
    BleApplicationContext.BleApplicationContext_legacy.connectionHandle = g_phone_connection_handle;
  }
  else
  {
    BleApplicationContext.Device_Connection_Status = APP_BLE_IDLE;
  }
  EXO_LOG("[BLE][APP][DISC] connect state=IDLE\r\n");
}

uint8_t APP_BLE_LeafClientPrepareScan(void)
{
  if (g_phone_connected != 0U)
  {
    BleApplicationContext.Device_Connection_Status = APP_BLE_SCAN;
    EXO_LOG("[BLE][APP][DISC] scan state=SCAN phone-connected handle=0x%04X\r\n",
            (unsigned)g_phone_connection_handle);
    return 1U;
  }
  if (BleApplicationContext.Device_Connection_Status == APP_BLE_FAST_ADV ||
      BleApplicationContext.Device_Connection_Status == APP_BLE_LP_ADV)
  {
    if (aci_gap_set_non_discoverable() != BLE_STATUS_SUCCESS)
    {
      EXO_LOG("[BLE][APP][DISC] scan prepare stop-adv failed\r\n");
      return 0U;
    }
    g_leaf_scan_holds_advertising = 1U;
    EXO_LOG("[BLE][APP][DISC] scan prepare stop-adv ok\r\n");
  }
  BleApplicationContext.Device_Connection_Status = APP_BLE_SCAN;
  EXO_LOG("[BLE][APP][DISC] scan state=SCAN\r\n");
  return 1U;
}

void APP_BLE_LeafClientScanIdle(void)
{
  if (g_phone_connected != 0U)
  {
    BleApplicationContext.Device_Connection_Status = APP_BLE_CONNECTED_SERVER;
    BleApplicationContext.BleApplicationContext_legacy.connectionHandle = g_phone_connection_handle;
    EXO_LOG("[BLE][APP][DISC] scan idle phone-connected handle=0x%04X\r\n",
            (unsigned)g_phone_connection_handle);
    return;
  }
  if (g_leaf_scan_holds_advertising != 0U &&
      BleApplicationContext.Device_Connection_Status != APP_BLE_LP_CONNECTING)
  {
    g_leaf_scan_holds_advertising = 0U;
    EXO_LOG("[BLE][APP][DISC] scan idle resume adv\r\n");
    Adv_Request(APP_BLE_FAST_ADV);
  }
}

uint8_t APP_BLE_LeafClientPhoneConnected(void)
{
  return g_phone_connected;
}

/* USER CODE END FD*/

/*************************************************************
 *
 * LOCAL FUNCTIONS
 *
 *************************************************************/
static void Ble_Tl_Init(void)
{
  HCI_TL_HciInitConf_t Hci_Tl_Init_Conf;

  Hci_Tl_Init_Conf.p_cmdbuffer = (uint8_t*)&BleCmdBuffer;
  Hci_Tl_Init_Conf.StatusNotCallBack = BLE_StatusNot;
  hci_init(BLE_UserEvtRx, (void*) &Hci_Tl_Init_Conf);

  return;
}

static void Ble_Hci_Gap_Gatt_Init(void)
{
  uint8_t role;
  uint16_t gap_service_handle, gap_dev_name_char_handle, gap_appearance_char_handle;
  uint32_t a_srd_bd_addr[2] = {0,0};
  uint16_t a_appearance[1] = {BLE_CFG_GAP_APPEARANCE};
  tBleStatus ret = BLE_STATUS_INVALID_PARAMS;
  /* USER CODE BEGIN Ble_Hci_Gap_Gatt_Init*/

  /* USER CODE END Ble_Hci_Gap_Gatt_Init*/

  APP_DBG_MSG("==>> Start Ble_Hci_Gap_Gatt_Init function\n");

  /**
   * Initialize HCI layer
   */
  /*HCI Reset to synchronise BLE Stack*/
  ret = hci_reset();
  if (ret != BLE_STATUS_SUCCESS)
  {
    APP_DBG_MSG("  Fail   : hci_reset command, result: 0x%x \n", ret);
  }
  else
  {
    APP_DBG_MSG("  Success: hci_reset command\n");
  }

  /**
   * Static random Address
   * The two upper bits shall be set to 1
   * The lowest 32bits is read from the UDN to differentiate between devices
   * The RNG may be used to provide a random number on each power on
   */
#if (CFG_IDENTITY_ADDRESS == GAP_STATIC_RANDOM_ADDR)
#if defined(CFG_STATIC_RANDOM_ADDRESS)
  a_srd_bd_addr[0] = CFG_STATIC_RANDOM_ADDRESS & 0xFFFFFFFF;
  a_srd_bd_addr[1] = (uint32_t)((uint64_t)CFG_STATIC_RANDOM_ADDRESS >> 32);
  a_srd_bd_addr[1] |= 0xC000; /* The two upper bits shall be set to 1 */
#endif /* CFG_STATIC_RANDOM_ADDRESS */
#endif
#if (CFG_BLE_ADDRESS_TYPE == GAP_STATIC_RANDOM_ADDR)
#endif

#if (CFG_BLE_ADDRESS_TYPE != PUBLIC_ADDR)
  ret = aci_hal_write_config_data(CONFIG_DATA_RANDOM_ADDRESS_OFFSET, CONFIG_DATA_RANDOM_ADDRESS_LEN, (uint8_t*)a_srd_bd_addr);
  if (ret != BLE_STATUS_SUCCESS)
  {
    APP_DBG_MSG("  Fail   : aci_hal_write_config_data command - CONFIG_DATA_RANDOM_ADDRESS_OFFSET, result: 0x%x \n", ret);
  }
  else
  {
    APP_DBG_MSG("  Success: aci_hal_write_config_data command - CONFIG_DATA_RANDOM_ADDRESS_OFFSET\n");
    APP_DBG_MSG("  Random Bluetooth Address: %02x:%02x:%02x:%02x:%02x:%02x\n", (uint8_t)(a_srd_bd_addr[1] >> 8),
                                                                               (uint8_t)(a_srd_bd_addr[1]),
                                                                               (uint8_t)(a_srd_bd_addr[0] >> 24),
                                                                               (uint8_t)(a_srd_bd_addr[0] >> 16),
                                                                               (uint8_t)(a_srd_bd_addr[0] >> 8),
                                                                               (uint8_t)(a_srd_bd_addr[0]));
  }
#endif /* CFG_BLE_ADDRESS_TYPE != GAP_PUBLIC_ADDR */

  /**
   * Write Identity root key used to derive IRK and DHK(Legacy)
   */
  ret = aci_hal_write_config_data(CONFIG_DATA_IR_OFFSET, CONFIG_DATA_IR_LEN, (uint8_t*)a_BLE_CfgIrValue);
  if (ret != BLE_STATUS_SUCCESS)
  {
    APP_DBG_MSG("  Fail   : aci_hal_write_config_data command - CONFIG_DATA_IR_OFFSET, result: 0x%x \n", ret);
  }
  else
  {
    APP_DBG_MSG("  Success: aci_hal_write_config_data command - CONFIG_DATA_IR_OFFSET\n");
  }

  /**
   * Write Encryption root key used to derive LTK and CSRK
   */
  ret = aci_hal_write_config_data(CONFIG_DATA_ER_OFFSET, CONFIG_DATA_ER_LEN, (uint8_t*)a_BLE_CfgErValue);
  if (ret != BLE_STATUS_SUCCESS)
  {
    APP_DBG_MSG("  Fail   : aci_hal_write_config_data command - CONFIG_DATA_ER_OFFSET, result: 0x%x \n", ret);
  }
  else
  {
    APP_DBG_MSG("  Success: aci_hal_write_config_data command - CONFIG_DATA_ER_OFFSET\n");
  }

  /**
   * Set TX Power.
   */
  ret = aci_hal_set_tx_power_level(1, CFG_TX_POWER);
  if (ret != BLE_STATUS_SUCCESS)
  {
    APP_DBG_MSG("  Fail   : aci_hal_set_tx_power_level command, result: 0x%x \n", ret);
  }
  else
  {
    APP_DBG_MSG("  Success: aci_hal_set_tx_power_level command\n");
  }

  /**
   * Initialize GATT interface
   */
  ret = aci_gatt_init();
  if (ret != BLE_STATUS_SUCCESS)
  {
    APP_DBG_MSG("  Fail   : aci_gatt_init command, result: 0x%x \n", ret);
  }
  else
  {
    APP_DBG_MSG("  Success: aci_gatt_init command\n");
  }

  /**
   * Initialize GAP interface
   */
  role = 0;

#if (BLE_CFG_PERIPHERAL == 1)
  role |= GAP_PERIPHERAL_ROLE;
#endif /* BLE_CFG_PERIPHERAL == 1 */

#if (BLE_CFG_CENTRAL == 1)
  role |= GAP_CENTRAL_ROLE;
#endif /* BLE_CFG_CENTRAL == 1 */

/* USER CODE BEGIN Role_Mngt*/
  role |= GAP_CENTRAL_ROLE;
  EXO_LOG("[BLE][APP][DISC] gap role=0x%02X peripheral=%u central=%u cfg_peripheral=%u cfg_central=%u\r\n",
          (unsigned)role,
          (unsigned)((role & GAP_PERIPHERAL_ROLE) != 0U),
          (unsigned)((role & GAP_CENTRAL_ROLE) != 0U),
          (unsigned)BLE_CFG_PERIPHERAL,
          (unsigned)BLE_CFG_CENTRAL);

/* USER CODE END Role_Mngt */

  if (role > 0)
  {
    const char *name = CFG_GAP_DEVICE_NAME;
    ret = aci_gap_init(role,
                       CFG_PRIVACY,
                       CFG_GAP_DEVICE_NAME_LENGTH,
                       &gap_service_handle,
                       &gap_dev_name_char_handle,
                       &gap_appearance_char_handle);

    if (ret != BLE_STATUS_SUCCESS)
    {
      APP_DBG_MSG("  Fail   : aci_gap_init command, result: 0x%x \n", ret);
    }
    else
    {
      APP_DBG_MSG("  Success: aci_gap_init command\n");
    }

    ret = aci_gatt_update_char_value(gap_service_handle, gap_dev_name_char_handle, 0, strlen(name), (uint8_t *) name);
    if (ret != BLE_STATUS_SUCCESS)
    {
      BLE_DBG_SVCCTL_MSG("  Fail   : aci_gatt_update_char_value - Device Name\n");
    }
    else
    {
      BLE_DBG_SVCCTL_MSG("  Success: aci_gatt_update_char_value - Device Name\n");
    }
  }

  ret = aci_gatt_update_char_value(gap_service_handle,
                                   gap_appearance_char_handle,
                                   0,
                                   2,
                                   (uint8_t *)&a_appearance);
  if (ret != BLE_STATUS_SUCCESS)
  {
    BLE_DBG_SVCCTL_MSG("  Fail   : aci_gatt_update_char_value - Appearance\n");
  }
  else
  {
    BLE_DBG_SVCCTL_MSG("  Success: aci_gatt_update_char_value - Appearance\n");
  }

  /**
   * Initialize Default PHY
   */
  ret = hci_le_set_default_phy(ALL_PHYS_PREFERENCE,TX_2M_PREFERRED,RX_2M_PREFERRED);
  if (ret != BLE_STATUS_SUCCESS)
  {
    APP_DBG_MSG("  Fail   : hci_le_set_default_phy command, result: 0x%x \n", ret);
  }
  else
  {
    APP_DBG_MSG("  Success: hci_le_set_default_phy command\n");
  }

  /**
   * Initialize IO capability
   */
  BleApplicationContext.BleApplicationContext_legacy.bleSecurityParam.ioCapability = CFG_IO_CAPABILITY;
  ret = aci_gap_set_io_capability(BleApplicationContext.BleApplicationContext_legacy.bleSecurityParam.ioCapability);
  if (ret != BLE_STATUS_SUCCESS)
  {
    APP_DBG_MSG("  Fail   : aci_gap_set_io_capability command, result: 0x%x \n", ret);
  }
  else
  {
    APP_DBG_MSG("  Success: aci_gap_set_io_capability command\n");
  }

  /**
   * Initialize authentication
   */
  BleApplicationContext.BleApplicationContext_legacy.bleSecurityParam.mitm_mode = CFG_MITM_PROTECTION;
  BleApplicationContext.BleApplicationContext_legacy.bleSecurityParam.encryptionKeySizeMin = CFG_ENCRYPTION_KEY_SIZE_MIN;
  BleApplicationContext.BleApplicationContext_legacy.bleSecurityParam.encryptionKeySizeMax = CFG_ENCRYPTION_KEY_SIZE_MAX;
  BleApplicationContext.BleApplicationContext_legacy.bleSecurityParam.bonding_mode = CFG_BONDING_MODE;
  /* USER CODE BEGIN Ble_Hci_Gap_Gatt_Init_1*/

  /* USER CODE END Ble_Hci_Gap_Gatt_Init_1*/

  ret = aci_gap_set_authentication_requirement(BleApplicationContext.BleApplicationContext_legacy.bleSecurityParam.bonding_mode,
                                               BleApplicationContext.BleApplicationContext_legacy.bleSecurityParam.mitm_mode,
                                               CFG_SC_SUPPORT,
                                               CFG_KEYPRESS_NOTIFICATION_SUPPORT,
                                               BleApplicationContext.BleApplicationContext_legacy.bleSecurityParam.encryptionKeySizeMin,
                                               BleApplicationContext.BleApplicationContext_legacy.bleSecurityParam.encryptionKeySizeMax,
                                               USE_FIXED_PIN_FOR_PAIRING_FORBIDDEN, /* deprecated feature */
                                               0,                                   /* deprecated feature */
                                               CFG_IDENTITY_ADDRESS);
  if (ret != BLE_STATUS_SUCCESS)
  {
    APP_DBG_MSG("  Fail   : aci_gap_set_authentication_requirement command, result: 0x%x \n", ret);
  }
  else
  {
    APP_DBG_MSG("  Success: aci_gap_set_authentication_requirement command\n");
  }

  /**
   * Initialize whitelist
   */
  if (BleApplicationContext.BleApplicationContext_legacy.bleSecurityParam.bonding_mode)
  {
    ret = aci_gap_configure_whitelist();
    if (ret != BLE_STATUS_SUCCESS)
    {
      APP_DBG_MSG("  Fail   : aci_gap_configure_whitelist command, result: 0x%x \n", ret);
    }
    else
    {
      APP_DBG_MSG("  Success: aci_gap_configure_whitelist command\n");
    }
  }
  APP_DBG_MSG("==>> End Ble_Hci_Gap_Gatt_Init function\n\r");
}

static void Adv_Request(APP_BLE_ConnStatus_t NewStatus)
{
  tBleStatus ret = BLE_STATUS_INVALID_PARAMS;

  BleApplicationContext.Device_Connection_Status = NewStatus;
  /* Start Fast or Low Power Advertising */
  ret = aci_gap_set_discoverable(ADV_TYPE,
                                 CFG_FAST_CONN_ADV_INTERVAL_MIN,
                                 CFG_FAST_CONN_ADV_INTERVAL_MAX,
                                 CFG_BLE_ADDRESS_TYPE,
                                 ADV_FILTER,
                                 0,
                                 0,
                                 0,
                                 0,
                                 0,
                                 0);
  if (ret != BLE_STATUS_SUCCESS)
  {
    APP_DBG_MSG("==>> aci_gap_set_discoverable - fail, result: 0x%x \n", ret);
  }
  else
  {
    APP_DBG_MSG("==>> aci_gap_set_discoverable - Success\n");
  }

/* USER CODE BEGIN Adv_Request_1*/
  if (g_phone_connected != 0U)
  {
    (void)aci_gap_set_non_discoverable();
    BleApplicationContext.Device_Connection_Status = APP_BLE_CONNECTED_SERVER;
    BleApplicationContext.BleApplicationContext_legacy.connectionHandle = g_phone_connection_handle;
    return;
  }

/* USER CODE END Adv_Request_1*/

  /* Update Advertising data */
  ret = aci_gap_update_adv_data(sizeof(a_AdvData), (uint8_t*) a_AdvData);
  if (ret != BLE_STATUS_SUCCESS)
  {
      APP_DBG_MSG("==>> Start Fast Advertising Failed , result: %d \n\r", ret);
  }
  else
  {
      APP_DBG_MSG("==>> Success: Start Fast Advertising \n\r");
  }

  return;
}

/*************************************************************
 *
 * SPECIFIC FUNCTIONS FOR CUSTOM
 *
 *************************************************************/
static void Adv_Cancel(void)
{
  if (BleApplicationContext.Device_Connection_Status != APP_BLE_CONNECTED_SERVER)
  {
    tBleStatus ret = BLE_STATUS_INVALID_PARAMS;

    ret = aci_gap_set_non_discoverable();

    BleApplicationContext.Device_Connection_Status = APP_BLE_IDLE;
    if (ret != BLE_STATUS_SUCCESS)
    {
      APP_DBG_MSG("** STOP ADVERTISING **  Failed \r\n\r");
    }
    else
    {
      APP_DBG_MSG("  \r\n\r");
      APP_DBG_MSG("** STOP ADVERTISING **  \r\n\r");
    }
  }

  return;
}

#if (L2CAP_REQUEST_NEW_CONN_PARAM != 0)
void BLE_SVC_L2CAP_Conn_Update(uint16_t ConnectionHandle)
{
  /* USER CODE BEGIN BLE_SVC_L2CAP_Conn_Update_1 */
  (void)ConnectionHandle;
  a_ConnInterval[0] = 15.0f;
  a_ConnInterval[1] = 30.0f;

  /* USER CODE END BLE_SVC_L2CAP_Conn_Update_1 */

  if (mutex == 1)
  {
    mutex = 0;
    index_con_int = (index_con_int + 1)%SIZE_TAB_CONN_INT;
    uint16_t interval_min = CONN_P(a_ConnInterval[index_con_int]);
    uint16_t interval_max = CONN_P(a_ConnInterval[index_con_int]);
    uint16_t peripheral_latency = L2CAP_PERIPHERAL_LATENCY;
    uint16_t timeout_multiplier = L2CAP_TIMEOUT_MULTIPLIER;
    tBleStatus ret;

    ret = aci_l2cap_connection_parameter_update_req(BleApplicationContext.BleApplicationContext_legacy.connectionHandle,
                                                    interval_min, interval_max,
                                                    peripheral_latency, timeout_multiplier);
    if (ret != BLE_STATUS_SUCCESS)
    {
      APP_DBG_MSG("BLE_SVC_L2CAP_Conn_Update(), Failed \r\n\r");
    }
    else
    {
      APP_DBG_MSG("BLE_SVC_L2CAP_Conn_Update(), Successfully \r\n\r");
    }
  }

  return;
}
#endif /* L2CAP_REQUEST_NEW_CONN_PARAM != 0 */

#if (L2CAP_REQUEST_NEW_CONN_PARAM != 0)
static void Connection_Interval_Update_Req(void)
{
  if (BleApplicationContext.Device_Connection_Status != APP_BLE_FAST_ADV && BleApplicationContext.Device_Connection_Status != APP_BLE_IDLE)
  {
    BLE_SVC_L2CAP_Conn_Update(BleApplicationContext.BleApplicationContext_legacy.connectionHandle);
  }

  return;
}
#endif /* L2CAP_REQUEST_NEW_CONN_PARAM != 0 */

/*************************************************************
 *
 * WRAP FUNCTIONS
 *
 *************************************************************/
void hci_notify_asynch_evt(void* p_Data)
{
  UTIL_SEQ_SetTask(1 << CFG_TASK_HCI_ASYNCH_EVT_ID, CFG_SCH_PRIO_0);

  return;
}

void hci_cmd_resp_release(uint32_t Flag)
{
  UTIL_SEQ_SetEvt(1 << CFG_IDLEEVT_HCI_CMD_EVT_RSP_ID);

  return;
}

void hci_cmd_resp_wait(uint32_t Timeout)
{
  UTIL_SEQ_WaitEvt(1 << CFG_IDLEEVT_HCI_CMD_EVT_RSP_ID);

  return;
}

static void BLE_UserEvtRx(void *p_Payload)
{
  SVCCTL_UserEvtFlowStatus_t svctl_return_status;
  tHCI_UserEvtRxParam *p_param;

  p_param = (tHCI_UserEvtRxParam *)p_Payload;

  svctl_return_status = SVCCTL_UserEvtRx((void *)&(p_param->pckt->evtserial));
  if (svctl_return_status != SVCCTL_UserEvtFlowDisable)
  {
    p_param->status = HCI_TL_UserEventFlow_Enable;
  }
  else
  {
    p_param->status = HCI_TL_UserEventFlow_Disable;
  }

  return;
}

static void BLE_StatusNot(HCI_TL_CmdStatus_t Status)
{
  uint32_t task_id_list;
  switch (Status)
  {
    case HCI_TL_CmdBusy:
      /**
       * All tasks that may send an aci/hci commands shall be listed here
       * This is to prevent a new command is sent while one is already pending
       */
      task_id_list = (1 << CFG_LAST_TASK_ID_WITH_HCICMD) - 1;
      UTIL_SEQ_PauseTask(task_id_list);
      break;

    case HCI_TL_CmdAvailable:
      /**
       * All tasks that may send an aci/hci commands shall be listed here
       * This is to prevent a new command is sent while one is already pending
       */
      task_id_list = (1 << CFG_LAST_TASK_ID_WITH_HCICMD) - 1;
      UTIL_SEQ_ResumeTask(task_id_list);
      break;

    default:
      break;
  }

  return;
}

void SVCCTL_ResumeUserEventFlow(void)
{
  hci_resume_flow();

  return;
}
