machadevrepos/Vantare_Vantage_Suit/(commit log)

2026-08-03 chore: stage multi-node integration patch
2026-08-03 feat: track deterministic four-node transfer ownership
2026-08-03 fix: coalesce node live preview samples fairly
    [HUB_LEAF_BLE_MANAGER.h]
2026-08-03 perf: stream staged node samples without per-row seeks
2026-08-03 chore: reset manager queues with value initialization
    [HUB_LEAF_BLE_MANAGER.h]
2026-08-03 feat: attach source timing and quality metadata
2026-08-03 chore: stage cleanup patch part 01
2026-08-03 chore: stage cleanup patch part 02
2026-08-03 chore: stage cleanup patch part 03
2026-08-03 chore: stage cleanup patch part 04
2026-08-03 chore: stage cleanup patch part 05
2026-08-03 chore: stage cleanup patch part 06
2026-08-03 chore: stage cleanup patch part 07
2026-08-03 chore: stage cleanup patch part 08
2026-08-03 chore: stage cleanup patch part 09
