machadevrepos/Vantare_Vantage_Suit/(notices)

Notices in the files:
Firmware/Master/STM32_WPAN/App/app_ble.c:
Copyright (c) 2026 STMicroelectronics.
All rights reserved.
This software is licensed under terms that can be found in the LICENSE file
